Kidus-Tesfaye/edf-tvc-testbed/CAD/views/16_rangefinder_TFmini-S_from_below.png

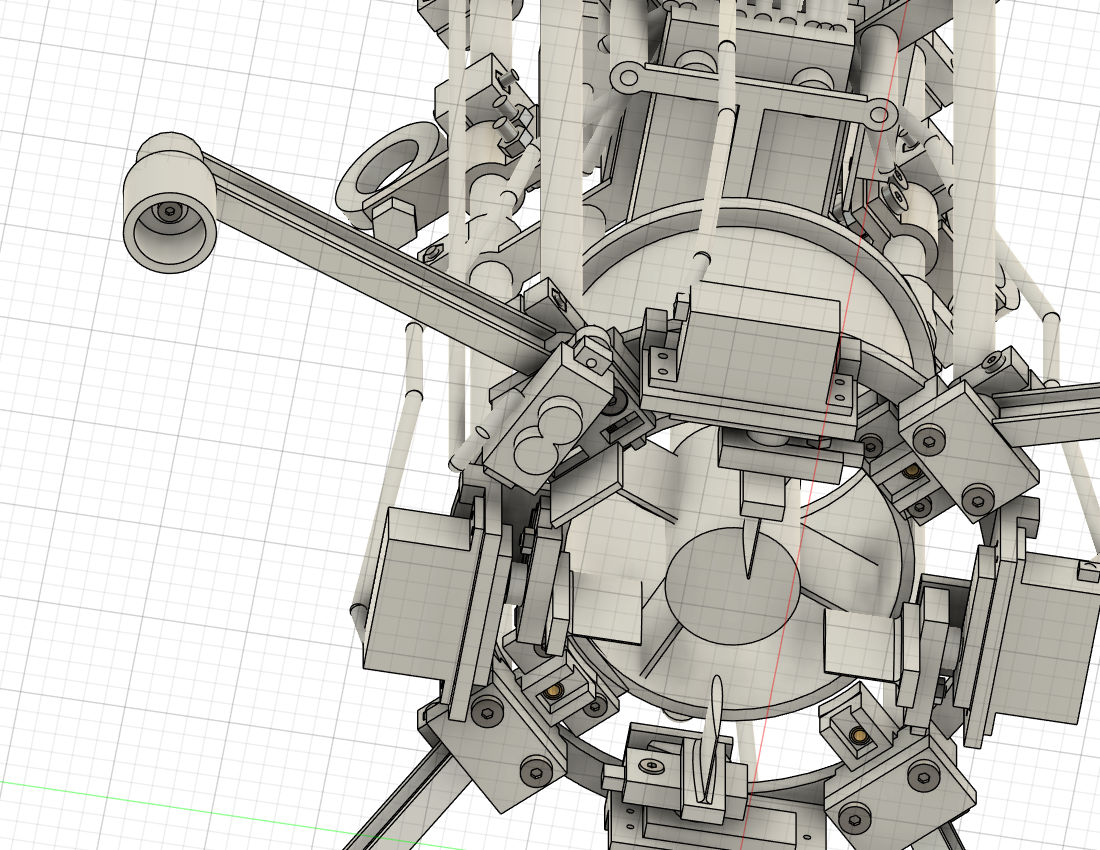
CAD/views/16_rangefinder_TFmini-S_from_below.png
