Kidus-Tesfaye/edf-tvc-testbed/docs/gap-statement-review-2026-09-17-edf-variant.md

# Gap statement review — electric (EDF) variant of the actively stabilised rocket project

*Date: 2026-09-17 · Audience assumed: student-conference reviewers · Reviewer: Claude (Opus 5, via Claude Code) ·
Search bound: delta audit on top of the solid-motor review of the same date — surveys, system papers, recent preprints and same-tier builds for electric-ducted-fan vehicles, one citation hop; "recent" cut-off 2025-03. Source keys S1–S35 refer to the earlier report's table and are repeated below only where cited; new sources start at S36.*

**Statement under review (verbatim, now applied to an electric-ducted-fan vehicle; starting point: the BB Projects "SpaceX-inspired EDF rocket" <a href="#s36" title="S36: B. Brocken, 2021-02-27, &quot;SpaceX inspired EDF rocket&quot;, BB Projects (bbprojects.technology) project page — starting point supplied by the user; counter-example SC1 and SC2 (flown, stock ArduPilot SingleCopter); read: full text; verified: yes — page (70 mm 6S EDF, about 2.5 kg thrust, Pixhawk/ArduPilot 4.0.4 SingleC…">[S36]</a>):**

> Active stabilisation of vertical thrust is a stretch problem for student teams; commercial model rockets use passive fins and aren't designed for control experimentation.

## Verdict

**Not defensible** — confidence high for the statement as written under electric propulsion; a narrower, EDF-specific statement (below) is defensible after narrowing, confidence medium.

Switching to an electric ducted fan (EDF) does not narrow the original gap — it removes it. Every clause now points at something that demonstrably exists. Attitude stabilisation of an EDF "rocket" was flown by the starting-point project itself in 2021 on a stock open-source autopilot configuration (ArduPilot SingleCopter: one fan, four vanes) <a href="#s36" title="S36: B. Brocken, 2021-02-27, &quot;SpaceX inspired EDF rocket&quot;, BB Projects (bbprojects.technology) project page — starting point supplied by the user; counter-example SC1 and SC2 (flown, stock ArduPilot SingleCopter); read: full text; verified: yes — page (70 mm 6S EDF, about 2.5 kg thrust, Pixhawk/ArduPilot 4.0.4 SingleC…">[S36]</a><a href="#s40" title="S40: ArduPilot Dev Team, n.d. (page current 2026-09-17), &quot;SingleCopter and CoaxCopter&quot;, ArduPilot Copter documentation — counter-example SC2 (stock support for a one-fan, four-vane vehicle); read: full text; verified: yes — page (`FRAME_CLASS` 8/9, vane servo mapping and parameters)">[S40]</a>; autonomous hover *and* soft landing were demonstrated by a single Master's student in March 2026 with custom 100 Hz avionics, and the code, CAD and thesis are public <a href="#s37" title="S37: U. Kukovič, 2026-03, &quot;TVC Self-Landing Rocket&quot; (Master&#x27;s thesis, University of Maribor, Electrical Engineering — Automation &amp; Robotics; mentor A. Sarjaš), GitHub repository with thesis PDF, code and CAD, CC BY-NC — strongest counter-example SC1; open flown vehicle for SC3; documented absence (horizontal control);…">[S37]</a>; research groups have adopted electric TVC vehicles as their preferred low-risk testbeds precisely because solid motors are hard to experiment on <a href="#s6" title="S6: R. Linsen, P. Listov, A. de Lajarte, R. Schwan, C. N. Jones, 2022, &quot;Optimal Thrust Vector Control of an Electric Small-Scale Rocket Prototype&quot;, IEEE ICRA 2022; EPFL — carried over; now the nearest academic neighbour (flown electric TVC platform); read: abstract; verified: yes — abstract via OpenAlex (earlier repor…">[S6]</a><a href="#s5" title="S5: P. Santos, J. Reis, P. Oliveira, C. Silvestre, 2026, &quot;QuadRocket: An Aerial Robotic Testbed for Adaptive Thrust-Vector Control of Rocket-Like Vehicles&quot;, arXiv — carried over; research testbed (electric); read: abstract; verified: yes — abstract (earlier report)">[S5]</a><a href="#s38" title="S38: A. Fonte, P. Santos, P. Oliveira, 2025-09-24, &quot;Control and Navigation of a 2-D Electric Rocket&quot;, arXiv preprint — recent; simulation-only; documented open limitation (lateral axis); read: abstract; verified: yes — abstract (&quot;limitations along the lateral axis&quot;)">[S38]</a>. And the "not designed for control experimentation" clause is inverted by the autopilot the starting point already runs: ArduPilot ships a custom-controller framework (`CC_TYPE`, `CC_AXIS_MASK`) with in-flight switching and bumpless transfer back to the stock controller — a hook built for exactly this kind of experiment <a href="#s41" title="S41: ArduPilot Dev Team, n.d. (page current 2026-09-17), &quot;Adding a Custom Controller&quot;, ArduPilot developer documentation — counter-example SC3 (experimentation hook in the COTS autopilot); read: full text; verified: yes — page (`CC_TYPE`, `CC_AXIS_MASK`, RC option 109, bumpless transfer, &quot;tested only lightly&quot;)">[S41]</a>. "Commercial model rockets use passive fins" is simply the wrong comparison class: an EDF vehicle is a powered model aircraft / small UAS, not a model rocket, in regulation and in practice <a href="#s46" title="S46: Federal Aviation Administration, n.d., &quot;Small Unmanned Aircraft Systems (UAS) Regulations (Part 107)&quot; — regulatory class of an EDF vehicle (US context only); read: snippet only; verified: no — classification taken from the search summary; the user&#x27;s jurisdiction is unknown">[S46]</a>. What survives is one specific, documented hole at the student tier — closed-loop *horizontal* position control with low-cost onboard sensing, which the one published thesis reports it could not achieve — and one not-found-by-search absence: an open EDF testbed publishing a validated plant model with a like-for-like comparison of controllers on the same airframe.

| Test | Result | Why (one line, with [S#]) |
|---|---|---|
| 1 Falsifiable | partial | Same as before: "stretch problem" cannot be refuted; the "not designed for control experimentation" clause can be, and <a href="#s41" title="S41: ArduPilot Dev Team, n.d. (page current 2026-09-17), &quot;Adding a Custom Controller&quot;, ArduPilot developer documentation — counter-example SC3 (experimentation hook in the COTS autopilot); read: full text; verified: yes — page (`CC_TYPE`, `CC_AXIS_MASK`, RC option 109, bumpless transfer, &quot;tested only lightly&quot;)">[S41]</a> does |
| 2 Evidenced absence | fail | Every absence claimed is met by a documented presence: flown hobbyist vehicle <a href="#s36" title="S36: B. Brocken, 2021-02-27, &quot;SpaceX inspired EDF rocket&quot;, BB Projects (bbprojects.technology) project page — starting point supplied by the user; counter-example SC1 and SC2 (flown, stock ArduPilot SingleCopter); read: full text; verified: yes — page (70 mm 6S EDF, about 2.5 kg thrust, Pixhawk/ArduPilot 4.0.4 SingleC…">[S36]</a>, flown open thesis vehicle <a href="#s37" title="S37: U. Kukovič, 2026-03, &quot;TVC Self-Landing Rocket&quot; (Master&#x27;s thesis, University of Maribor, Electrical Engineering — Automation &amp; Robotics; mentor A. Sarjaš), GitHub repository with thesis PDF, code and CAD, CC BY-NC — strongest counter-example SC1; open flown vehicle for SC3; documented absence (horizontal control);…">[S37]</a>, stock autopilot support <a href="#s40" title="S40: ArduPilot Dev Team, n.d. (page current 2026-09-17), &quot;SingleCopter and CoaxCopter&quot;, ArduPilot Copter documentation — counter-example SC2 (stock support for a one-fan, four-vane vehicle); read: full text; verified: yes — page (`FRAME_CLASS` 8/9, vane servo mapping and parameters)">[S40]</a>, custom-controller hook <a href="#s41" title="S41: ArduPilot Dev Team, n.d. (page current 2026-09-17), &quot;Adding a Custom Controller&quot;, ArduPilot developer documentation — counter-example SC3 (experimentation hook in the COTS autopilot); read: full text; verified: yes — page (`CC_TYPE`, `CC_AXIS_MASK`, RC option 109, bumpless transfer, &quot;tested only lightly&quot;)">[S41]</a> |
| 3 Honestly scoped | fail | "Model rockets" is the wrong class for an EDF vehicle; the relevant neighbours are single-fan VTOL aircraft and their autopilots, and the claim was never scoped to them |
| 4 Significant | partial | A flown testbed still has value for the expo, but the *research* value has to come from the experiments run on it, because the platform itself is no longer the contribution |
| 5 Not empty for a good reason | fail | It is not empty. The sub-problem that *is* empty at the student tier (horizontal control with cheap sensing) is empty for a good reason — EDF vibration corrupts optical-flow velocity <a href="#s37" title="S37: U. Kukovič, 2026-03, &quot;TVC Self-Landing Rocket&quot; (Master&#x27;s thesis, University of Maribor, Electrical Engineering — Automation &amp; Robotics; mentor A. Sarjaš), GitHub repository with thesis PDF, code and CAD, CC BY-NC — strongest counter-example SC1; open flown vehicle for SC3; documented absence (horizontal control);…">[S37]</a> and lateral dynamics are the stated open limitation in simulation too <a href="#s38" title="S38: A. Fonte, P. Santos, P. Oliveira, 2025-09-24, &quot;Control and Navigation of a 2-D Electric Rocket&quot;, arXiv preprint — recent; simulation-only; documented open limitation (lateral axis); read: abstract; verified: yes — abstract (&quot;limitations along the lateral axis&quot;)">[S38]</a> |
| 6 Current | fail | Three items since the cut-off close or reshape the claim: the Maribor thesis (2026-03) <a href="#s37" title="S37: U. Kukovič, 2026-03, &quot;TVC Self-Landing Rocket&quot; (Master&#x27;s thesis, University of Maribor, Electrical Engineering — Automation &amp; Robotics; mentor A. Sarjaš), GitHub repository with thesis PDF, code and CAD, CC BY-NC — strongest counter-example SC1; open flown vehicle for SC3; documented absence (horizontal control);…">[S37]</a>, QuadRocket (2026-07) <a href="#s5" title="S5: P. Santos, J. Reis, P. Oliveira, C. Silvestre, 2026, &quot;QuadRocket: An Aerial Robotic Testbed for Adaptive Thrust-Vector Control of Rocket-Like Vehicles&quot;, arXiv — carried over; research testbed (electric); read: abstract; verified: yes — abstract (earlier report)">[S5]</a>, and the 2-D electric rocket simulation (2025-09) <a href="#s38" title="S38: A. Fonte, P. Santos, P. Oliveira, 2025-09-24, &quot;Control and Navigation of a 2-D Electric Rocket&quot;, arXiv preprint — recent; simulation-only; documented open limitation (lateral axis); read: abstract; verified: yes — abstract (&quot;limitations along the lateral axis&quot;)">[S38]</a> |

## Glossary

| Term | Meaning here |
|---|---|
| Sub-claim | One atomic piece of the statement, "X has not been done under condition Y", that a single paper could refute |
| Documented absence | Evidence that something is missing: a paper's own limitation sentence, a survey table with the cell empty, a rule saying a component is unavailable |
| Not-found-by-search | Weaker: our logged queries surfaced nothing. Only as strong as the queries |
| EDF | Electric ducted fan: a brushless motor driving a multi-blade fan inside a duct. Throttleable, restartable, runs for minutes, no pyrotechnics — the opposite of a solid rocket motor on every axis that made TVC hard |
| Vane TVC vs gimbal TVC | Vanes deflect the fan's exhaust with movable surfaces in the jet (the BB Projects design <a href="#s36" title="S36: B. Brocken, 2021-02-27, &quot;SpaceX inspired EDF rocket&quot;, BB Projects (bbprojects.technology) project page — starting point supplied by the user; counter-example SC1 and SC2 (flown, stock ArduPilot SingleCopter); read: full text; verified: yes — page (70 mm 6S EDF, about 2.5 kg thrust, Pixhawk/ArduPilot 4.0.4 SingleC…">[S36]</a>, ArduPilot SingleCopter <a href="#s40" title="S40: ArduPilot Dev Team, n.d. (page current 2026-09-17), &quot;SingleCopter and CoaxCopter&quot;, ArduPilot Copter documentation — counter-example SC2 (stock support for a one-fan, four-vane vehicle); read: full text; verified: yes — page (`FRAME_CLASS` 8/9, vane servo mapping and parameters)">[S40]</a>); a gimbal tilts the whole fan (the Maribor design <a href="#s37" title="S37: U. Kukovič, 2026-03, &quot;TVC Self-Landing Rocket&quot; (Master&#x27;s thesis, University of Maribor, Electrical Engineering — Automation &amp; Robotics; mentor A. Sarjaš), GitHub repository with thesis PDF, code and CAD, CC BY-NC — strongest counter-example SC1; open flown vehicle for SC3; documented absence (horizontal control);…">[S37]</a>) |
| SingleCopter | ArduPilot's name for a one-motor, four-vane vehicle (`FRAME_CLASS` 8) <a href="#s40" title="S40: ArduPilot Dev Team, n.d. (page current 2026-09-17), &quot;SingleCopter and CoaxCopter&quot;, ArduPilot Copter documentation — counter-example SC2 (stock support for a one-fan, four-vane vehicle); read: full text; verified: yes — page (`FRAME_CLASS` 8/9, vane servo mapping and parameters)">[S40]</a> |
| Custom controller (ArduPilot) | A firmware hook that lets a user's own attitude controller run in place of the stock one, switched by an RC channel, with automatic fallback <a href="#s41" title="S41: ArduPilot Dev Team, n.d. (page current 2026-09-17), &quot;Adding a Custom Controller&quot;, ArduPilot developer documentation — counter-example SC3 (experimentation hook in the COTS autopilot); read: full text; verified: yes — page (`CC_TYPE`, `CC_AXIS_MASK`, RC option 109, bumpless transfer, &quot;tested only lightly&quot;)">[S41]</a> |
| Reaction torque | The roll torque an EDF applies to the airframe as it spins the fan; must be cancelled by vanes or feed-forward <a href="#s37" title="S37: U. Kukovič, 2026-03, &quot;TVC Self-Landing Rocket&quot; (Master&#x27;s thesis, University of Maribor, Electrical Engineering — Automation &amp; Robotics; mentor A. Sarjaš), GitHub repository with thesis PDF, code and CAD, CC BY-NC — strongest counter-example SC1; open flown vehicle for SC3; documented absence (horizontal control);…">[S37]</a> |
| Small UAS | The regulatory class an EDF vehicle falls into (unmanned aircraft), as opposed to the model-rocket class <a href="#s46" title="S46: Federal Aviation Administration, n.d., &quot;Small Unmanned Aircraft Systems (UAS) Regulations (Part 107)&quot; — regulatory class of an EDF vehicle (US context only); read: snippet only; verified: no — classification taken from the search summary; the user&#x27;s jurisdiction is unknown">[S46]</a> |

## Inputs and assumptions

| Slot | Value | Supplied or assumed |
|---|---|---|
| Field / sub-field | Small VTOL / single-ducted-fan aircraft; thrust-vectored electric "rockets"; hobby and academic testbeds | assumed from the starting point |
| Vocabulary used for searching | "EDF rocket", "electric ducted fan", "electric rocket", "thrust vector control", "vane", "gimbal", "self-landing", "VTVL", "hover", "SingleCopter", "custom controller", plus the solid-motor terms from the earlier review | assumed |
| Audience | Student-conference reviewers | supplied |
| Scope boundaries | Same group project, budget not a constraint, about 3 months to an expo; the vehicle class is now a 2–4 kg electric single-fan VTOL derived from <a href="#s36" title="S36: B. Brocken, 2021-02-27, &quot;SpaceX inspired EDF rocket&quot;, BB Projects (bbprojects.technology) project page — starting point supplied by the user; counter-example SC1 and SC2 (flown, stock ArduPilot SingleCopter); read: full text; verified: yes — page (70 mm 6S EDF, about 2.5 kg thrust, Pixhawk/ArduPilot 4.0.4 SingleC…">[S36]</a> | supplied (time, budget, starting point) / assumed (mass class from <a href="#s36" title="S36: B. Brocken, 2021-02-27, &quot;SpaceX inspired EDF rocket&quot;, BB Projects (bbprojects.technology) project page — starting point supplied by the user; counter-example SC1 and SC2 (flown, stock ArduPilot SingleCopter); read: full text; verified: yes — page (70 mm 6S EDF, about 2.5 kg thrust, Pixhawk/ArduPilot 4.0.4 SingleC…">[S36]</a> and <a href="#s37" title="S37: U. Kukovič, 2026-03, &quot;TVC Self-Landing Rocket&quot; (Master&#x27;s thesis, University of Maribor, Electrical Engineering — Automation &amp; Robotics; mentor A. Sarjaš), GitHub repository with thesis PDF, code and CAD, CC BY-NC — strongest counter-example SC1; open flown vehicle for SC3; documented absence (horizontal control);…">[S37]</a>) |
| Seed papers / library | <a href="#s36" title="S36: B. Brocken, 2021-02-27, &quot;SpaceX inspired EDF rocket&quot;, BB Projects (bbprojects.technology) project page — starting point supplied by the user; counter-example SC1 and SC2 (flown, stock ArduPilot SingleCopter); read: full text; verified: yes — page (70 mm 6S EDF, about 2.5 kg thrust, Pixhawk/ArduPilot 4.0.4 SingleC…">[S36]</a> (supplied as the starting point); <a href="#s6" title="S6: R. Linsen, P. Listov, A. de Lajarte, R. Schwan, C. N. Jones, 2022, &quot;Optimal Thrust Vector Control of an Electric Small-Scale Rocket Prototype&quot;, IEEE ICRA 2022; EPFL — carried over; now the nearest academic neighbour (flown electric TVC platform); read: abstract; verified: yes — abstract via OpenAlex (earlier repor…">[S6]</a><a href="#s5" title="S5: P. Santos, J. Reis, P. Oliveira, C. Silvestre, 2026, &quot;QuadRocket: An Aerial Robotic Testbed for Adaptive Thrust-Vector Control of Rocket-Like Vehicles&quot;, arXiv — carried over; research testbed (electric); read: abstract; verified: yes — abstract (earlier report)">[S5]</a><a href="#s37" title="S37: U. Kukovič, 2026-03, &quot;TVC Self-Landing Rocket&quot; (Master&#x27;s thesis, University of Maribor, Electrical Engineering — Automation &amp; Robotics; mentor A. Sarjaš), GitHub repository with thesis PDF, code and CAD, CC BY-NC — strongest counter-example SC1; open flown vehicle for SC3; documented absence (horizontal control);…">[S37]</a> taken as the nearest academic and thesis neighbours | supplied / assumed |
| Already searched by the user | Nothing beyond being shown <a href="#s36" title="S36: B. Brocken, 2021-02-27, &quot;SpaceX inspired EDF rocket&quot;, BB Projects (bbprojects.technology) project page — starting point supplied by the user; counter-example SC1 and SC2 (flown, stock ArduPilot SingleCopter); read: full text; verified: yes — page (70 mm 6S EDF, about 2.5 kg thrust, Pixhawk/ArduPilot 4.0.4 SingleC…">[S36]</a> | supplied |
| "Recent" cut-off | 2025-03 | assumed |

## Sub-claims

| ID | Sub-claim | Gap type | Top-down evidence | Bottom-up evidence | Status | Strongest counter-paper | Evidence strength |
|---|---|---|---|---|---|---|---|
| SC1 | Active attitude stabilisation of an EDF-propelled "rocket" (vane or gimbal TVC), including hover and landing, is beyond the reach of student teams | practical-knowledge / population | EPFL flew an electric small-scale TVC rocket indoors and outdoors with MPC on embedded hardware, as "an inexpensive platform to explore guidance algorithms" <a href="#s6" title="S6: R. Linsen, P. Listov, A. de Lajarte, R. Schwan, C. N. Jones, 2022, &quot;Optimal Thrust Vector Control of an Electric Small-Scale Rocket Prototype&quot;, IEEE ICRA 2022; EPFL — carried over; now the nearest academic neighbour (flown electric TVC platform); read: abstract; verified: yes — abstract via OpenAlex (earlier repor…">[S6]</a>; the Lisbon group's QuadRocket flies in a motion-capture arena <a href="#s5" title="S5: P. Santos, J. Reis, P. Oliveira, C. Silvestre, 2026, &quot;QuadRocket: An Aerial Robotic Testbed for Adaptive Thrust-Vector Control of Rocket-Like Vehicles&quot;, arXiv — carried over; research testbed (electric); read: abstract; verified: yes — abstract (earlier report)">[S5]</a> and its 2-D electric-rocket simulation is the same group's student-facing model <a href="#s38" title="S38: A. Fonte, P. Santos, P. Oliveira, 2025-09-24, &quot;Control and Navigation of a 2-D Electric Rocket&quot;, arXiv preprint — recent; simulation-only; documented open limitation (lateral axis); read: abstract; verified: yes — abstract (&quot;limitations along the lateral axis&quot;)">[S38]</a> | A hobbyist flew the starting-point vehicle on stock ArduPilot in 2021 <a href="#s36" title="S36: B. Brocken, 2021-02-27, &quot;SpaceX inspired EDF rocket&quot;, BB Projects (bbprojects.technology) project page — starting point supplied by the user; counter-example SC1 and SC2 (flown, stock ArduPilot SingleCopter); read: full text; verified: yes — page (70 mm 6S EDF, about 2.5 kg thrust, Pixhawk/ArduPilot 4.0.4 SingleC…">[S36]</a>; a Master's student demonstrated autonomous hover and soft landing (50–100 mm/s touchdown) in March 2026 and released code, CAD and thesis <a href="#s37" title="S37: U. Kukovič, 2026-03, &quot;TVC Self-Landing Rocket&quot; (Master&#x27;s thesis, University of Maribor, Electrical Engineering — Automation &amp; Robotics; mentor A. Sarjaš), GitHub repository with thesis PDF, code and CAD, CC BY-NC — strongest counter-example SC1; open flown vehicle for SC3; documented absence (horizontal control);…">[S37]</a>; further hobbyist EDF landers exist <a href="#s42" title="S42: Hackster.io News, n.d., &quot;Ikarus Electric &#x27;Rocket&#x27;&quot; (3D-printed four-vane EDF vehicle that lands on a pad) — same-tier hobbyist lander; read: not accessible; verified: n/a">[S42]</a><a href="#s44" title="S44: Bresc, n.d., &quot;Ducted fan thrust vectoring drone&quot;, Printables.com model — same-tier printable design; read: snippet only; verified: no — not opened">[S44]</a><a href="#s45" title="S45: RCU Forums thread, n.d., &quot;EDF Thrust Vectoring Autonomous LEM (Lunar Excursion Module) Build&quot; — same-tier hobbyist build; read: snippet only; verified: no — not opened">[S45]</a> and a 2024 Indonesian thesis covers 70 mm EDF TVC <a href="#s43" title="S43: N. M. Farras, 2024, Master&#x27;s/undergraduate thesis chapter &quot;Thrust Vectoring Control&quot; (70 mm EDF), Institut Teknologi Bandung digital library — same-tier student thesis on EDF TVC; read: snippet only; verified: no — not opened; title and EDF size from search snippet">[S43]</a> | closed | <a href="#s37" title="S37: U. Kukovič, 2026-03, &quot;TVC Self-Landing Rocket&quot; (Master&#x27;s thesis, University of Maribor, Electrical Engineering — Automation &amp; Robotics; mentor A. Sarjaš), GitHub repository with thesis PDF, code and CAD, CC BY-NC — strongest counter-example SC1; open flown vehicle for SC3; documented absence (horizontal control);…">[S37]</a> (student, EDF, gimbal TVC, hover and landing, open) | closed by <a href="#s37" title="S37: U. Kukovič, 2026-03, &quot;TVC Self-Landing Rocket&quot; (Master&#x27;s thesis, University of Maribor, Electrical Engineering — Automation &amp; Robotics; mentor A. Sarjaš), GitHub repository with thesis PDF, code and CAD, CC BY-NC — strongest counter-example SC1; open flown vehicle for SC3; documented absence (horizontal control);…">[S37]</a> and <a href="#s36" title="S36: B. Brocken, 2021-02-27, &quot;SpaceX inspired EDF rocket&quot;, BB Projects (bbprojects.technology) project page — starting point supplied by the user; counter-example SC1 and SC2 (flown, stock ArduPilot SingleCopter); read: full text; verified: yes — page (70 mm 6S EDF, about 2.5 kg thrust, Pixhawk/ArduPilot 4.0.4 SingleC…">[S36]</a> |
| SC2 | The commercial / off-the-shelf baseline for this vehicle class is passively stabilised and unsuited to active control (the EDF analogue of "commercial model rockets use passive fins") | evidence (market) | The dominant open-source autopilot supports a one-fan, four-vane vehicle as a standard frame type, with per-vane servo configuration documented <a href="#s40" title="S40: ArduPilot Dev Team, n.d. (page current 2026-09-17), &quot;SingleCopter and CoaxCopter&quot;, ArduPilot Copter documentation — counter-example SC2 (stock support for a one-fan, four-vane vehicle); read: full text; verified: yes — page (`FRAME_CLASS` 8/9, vane servo mapping and parameters)">[S40]</a> | The starting point runs exactly that configuration on a Pixhawk and flew on it <a href="#s36" title="S36: B. Brocken, 2021-02-27, &quot;SpaceX inspired EDF rocket&quot;, BB Projects (bbprojects.technology) project page — starting point supplied by the user; counter-example SC1 and SC2 (flown, stock ArduPilot SingleCopter); read: full text; verified: yes — page (70 mm 6S EDF, about 2.5 kg thrust, Pixhawk/ArduPilot 4.0.4 SingleC…">[S36]</a>; no commercial EDF-rocket *kit* was found (search log #8), but the vehicle is a UAS and the UAS COTS ecosystem is the baseline <a href="#s46" title="S46: Federal Aviation Administration, n.d., &quot;Small Unmanned Aircraft Systems (UAS) Regulations (Part 107)&quot; — regulatory class of an EDF vehicle (US context only); read: snippet only; verified: no — classification taken from the search summary; the user&#x27;s jurisdiction is unknown">[S46]</a> | closed | <a href="#s40" title="S40: ArduPilot Dev Team, n.d. (page current 2026-09-17), &quot;SingleCopter and CoaxCopter&quot;, ArduPilot Copter documentation — counter-example SC2 (stock support for a one-fan, four-vane vehicle); read: full text; verified: yes — page (`FRAME_CLASS` 8/9, vane servo mapping and parameters)">[S40]</a> with <a href="#s36" title="S36: B. Brocken, 2021-02-27, &quot;SpaceX inspired EDF rocket&quot;, BB Projects (bbprojects.technology) project page — starting point supplied by the user; counter-example SC1 and SC2 (flown, stock ArduPilot SingleCopter); read: full text; verified: yes — page (70 mm 6S EDF, about 2.5 kg thrust, Pixhawk/ArduPilot 4.0.4 SingleC…">[S36]</a> as the flown instance | closed by <a href="#s40" title="S40: ArduPilot Dev Team, n.d. (page current 2026-09-17), &quot;SingleCopter and CoaxCopter&quot;, ArduPilot Copter documentation — counter-example SC2 (stock support for a one-fan, four-vane vehicle); read: full text; verified: yes — page (`FRAME_CLASS` 8/9, vane servo mapping and parameters)">[S40]</a> and <a href="#s36" title="S36: B. Brocken, 2021-02-27, &quot;SpaceX inspired EDF rocket&quot;, BB Projects (bbprojects.technology) project page — starting point supplied by the user; counter-example SC1 and SC2 (flown, stock ArduPilot SingleCopter); read: full text; verified: yes — page (70 mm 6S EDF, about 2.5 kg thrust, Pixhawk/ArduPilot 4.0.4 SingleC…">[S36]</a> |
| SC3 | No platform exists on which a student team can run controlled attitude-control experiments (controller exposed, instrumented, reusable) | methodological / platform | ArduPilot's custom-controller framework runs a user's controller in place of the stock one, switchable in flight, with bumpless fallback <a href="#s41" title="S41: ArduPilot Dev Team, n.d. (page current 2026-09-17), &quot;Adding a Custom Controller&quot;, ArduPilot developer documentation — counter-example SC3 (experimentation hook in the COTS autopilot); read: full text; verified: yes — page (`CC_TYPE`, `CC_AXIS_MASK`, RC option 109, bumpless transfer, &quot;tested only lightly&quot;)">[S41]</a>; EPFL <a href="#s6" title="S6: R. Linsen, P. Listov, A. de Lajarte, R. Schwan, C. N. Jones, 2022, &quot;Optimal Thrust Vector Control of an Electric Small-Scale Rocket Prototype&quot;, IEEE ICRA 2022; EPFL — carried over; now the nearest academic neighbour (flown electric TVC platform); read: abstract; verified: yes — abstract via OpenAlex (earlier repor…">[S6]</a> and QuadRocket <a href="#s5" title="S5: P. Santos, J. Reis, P. Oliveira, C. Silvestre, 2026, &quot;QuadRocket: An Aerial Robotic Testbed for Adaptive Thrust-Vector Control of Rocket-Like Vehicles&quot;, arXiv — carried over; research testbed (electric); read: abstract; verified: yes — abstract (earlier report)">[S5]</a> are research testbeds built for this purpose | The Maribor vehicle is open (CC BY-NC) with a bare-metal 100 Hz loop the student wrote and tuned <a href="#s37" title="S37: U. Kukovič, 2026-03, &quot;TVC Self-Landing Rocket&quot; (Master&#x27;s thesis, University of Maribor, Electrical Engineering — Automation &amp; Robotics; mentor A. Sarjaš), GitHub repository with thesis PDF, code and CAD, CC BY-NC — strongest counter-example SC1; open flown vehicle for SC3; documented absence (horizontal control);…">[S37]</a>; the starting point's Pixhawk config, Arduino code and Gerbers are free and the CAD is for sale <a href="#s36" title="S36: B. Brocken, 2021-02-27, &quot;SpaceX inspired EDF rocket&quot;, BB Projects (bbprojects.technology) project page — starting point supplied by the user; counter-example SC1 and SC2 (flown, stock ArduPilot SingleCopter); read: full text; verified: yes — page (70 mm 6S EDF, about 2.5 kg thrust, Pixhawk/ArduPilot 4.0.4 SingleC…">[S36]</a> | partially closed | <a href="#s41" title="S41: ArduPilot Dev Team, n.d. (page current 2026-09-17), &quot;Adding a Custom Controller&quot;, ArduPilot developer documentation — counter-example SC3 (experimentation hook in the COTS autopilot); read: full text; verified: yes — page (`CC_TYPE`, `CC_AXIS_MASK`, RC option 109, bumpless transfer, &quot;tested only lightly&quot;)">[S41]</a> for attitude experiments; <a href="#s37" title="S37: U. Kukovič, 2026-03, &quot;TVC Self-Landing Rocket&quot; (Master&#x27;s thesis, University of Maribor, Electrical Engineering — Automation &amp; Robotics; mentor A. Sarjaš), GitHub repository with thesis PDF, code and CAD, CC BY-NC — strongest counter-example SC1; open flown vehicle for SC3; documented absence (horizontal control);…">[S37]</a> for an open flown vehicle | closed by <a href="#s41" title="S41: ArduPilot Dev Team, n.d. (page current 2026-09-17), &quot;Adding a Custom Controller&quot;, ArduPilot developer documentation — counter-example SC3 (experimentation hook in the COTS autopilot); read: full text; verified: yes — page (`CC_TYPE`, `CC_AXIS_MASK`, RC option 109, bumpless transfer, &quot;tested only lightly&quot;)">[S41]</a> and <a href="#s37" title="S37: U. Kukovič, 2026-03, &quot;TVC Self-Landing Rocket&quot; (Master&#x27;s thesis, University of Maribor, Electrical Engineering — Automation &amp; Robotics; mentor A. Sarjaš), GitHub repository with thesis PDF, code and CAD, CC BY-NC — strongest counter-example SC1; open flown vehicle for SC3; documented absence (horizontal control);…">[S37]</a> for attitude control; not-found-by-search for an open EDF testbed with a published plant model and like-for-like controller comparison; documented absence for student-tier closed-loop horizontal control ("could tip over", optical flow "unreliable") <a href="#s37" title="S37: U. Kukovič, 2026-03, &quot;TVC Self-Landing Rocket&quot; (Master&#x27;s thesis, University of Maribor, Electrical Engineering — Automation &amp; Robotics; mentor A. Sarjaš), GitHub repository with thesis PDF, code and CAD, CC BY-NC — strongest counter-example SC1; open flown vehicle for SC3; documented absence (horizontal control);…">[S37]</a> and lateral-axis limitations <a href="#s38" title="S38: A. Fonte, P. Santos, P. Oliveira, 2025-09-24, &quot;Control and Navigation of a 2-D Electric Rocket&quot;, arXiv preprint — recent; simulation-only; documented open limitation (lateral axis); read: abstract; verified: yes — abstract (&quot;limitations along the lateral axis&quot;)">[S38]</a> |

## Top-down search

### SC1 — active stabilisation of an EDF vehicle by students

**Surveys.** The only review surfaced with "thrust vectoring" and "electric" in the title covers spacecraft electric propulsion (ion and plasma thrusters) and says nothing about ducted-fan vehicles <a href="#s39" title="S39: A. Shumeiko, V. Telekh, S. Ryzhkov, 2025, &quot;Thrust-vectoring schemes for electric propulsion systems: A review&quot;, Chinese Journal of Aeronautics 38(6) — read, not cited — the only &quot;review&quot; surfaced, but it covers spacecraft ion/plasma thrusters, not ducted fans; read: abstract; verified: n/a">[S39]</a>. No survey of small electric TVC vehicles or educational testbeds was found (search log #4, #11).

**System papers.** The academic picture is the same three groups as the solid-motor review, and all three have gone electric: EPFL's ICRA 2022 electric TVC prototype, flown indoors and outdoors with embedded MPC <a href="#s6" title="S6: R. Linsen, P. Listov, A. de Lajarte, R. Schwan, C. N. Jones, 2022, &quot;Optimal Thrust Vector Control of an Electric Small-Scale Rocket Prototype&quot;, IEEE ICRA 2022; EPFL — carried over; now the nearest academic neighbour (flown electric TVC platform); read: abstract; verified: yes — abstract via OpenAlex (earlier repor…">[S6]</a>; the Lisbon group's QuadRocket, a rocket body on a quadrotor used as "a low-cost, low-risk platform for validating advanced thrust-vector control strategies" <a href="#s5" title="S5: P. Santos, J. Reis, P. Oliveira, C. Silvestre, 2026, &quot;QuadRocket: An Aerial Robotic Testbed for Adaptive Thrust-Vector Control of Rocket-Like Vehicles&quot;, arXiv — carried over; research testbed (electric); read: abstract; verified: yes — abstract (earlier report)">[S5]</a>, and the same group's 2025 simulation of a 2-D electric rocket with LQR and Kalman filtering, which "reveal[s] limitations along the lateral axis, whose resolution is suggested for future work" <a href="#s38" title="S38: A. Fonte, P. Santos, P. Oliveira, 2025-09-24, &quot;Control and Navigation of a 2-D Electric Rocket&quot;, arXiv preprint — recent; simulation-only; documented open limitation (lateral axis); read: abstract; verified: yes — abstract (&quot;limitations along the lateral axis&quot;)">[S38]</a>. The reason these groups use electric vehicles is the reason the statement's premise fails under EDF: an electric vehicle can be flown repeatedly, indoors, throttled, and tethered — the four things a solid motor forbids.

**Recent preprints.** The arXiv API query for ducted-fan or electric-rocket vehicles with thrust vectoring or landing returned four papers, all legged or humanoid robots and none relevant (search log #11); <a href="#s38" title="S38: A. Fonte, P. Santos, P. Oliveira, 2025-09-24, &quot;Control and Navigation of a 2-D Electric Rocket&quot;, arXiv preprint — recent; simulation-only; documented open limitation (lateral axis); read: abstract; verified: yes — abstract (&quot;limitations along the lateral axis&quot;)">[S38]</a> was found by web search instead. Nothing since the cut-off reports a *student team* electric TVC vehicle in a preprint — the student-tier evidence is in theses and repositories, below.

### SC2 — the off-the-shelf baseline

The comparison class changes completely. An EDF "rocket" is a single-fan VTOL aircraft; ArduPilot Copter supports it as `FRAME_CLASS` 8 (SingleCopter: "a single motor and 4 independent flaps") with yaw from differential vane deflection and per-vane `SERVOx_TRIM/REVERSED/MIN/MAX` configuration <a href="#s40" title="S40: ArduPilot Dev Team, n.d. (page current 2026-09-17), &quot;SingleCopter and CoaxCopter&quot;, ArduPilot Copter documentation — counter-example SC2 (stock support for a one-fan, four-vane vehicle); read: full text; verified: yes — page (`FRAME_CLASS` 8/9, vane servo mapping and parameters)">[S40]</a>. The premise "commercial [platforms] use passive fins" has no analogue here — the off-the-shelf baseline is an *actively stabilised* vehicle out of the box. Regulatory framing follows the same logic: EDF-powered models fall under model-aircraft / small-UAS rules, not model-rocket codes <a href="#s46" title="S46: Federal Aviation Administration, n.d., &quot;Small Unmanned Aircraft Systems (UAS) Regulations (Part 107)&quot; — regulatory class of an EDF vehicle (US context only); read: snippet only; verified: no — classification taken from the search summary; the user&#x27;s jurisdiction is unknown">[S46]</a>, so the NAR/Tripoli/IREC constraints of the solid-motor review <a href="#s17" title="S17: Experimental Sounding Rocket Association, 2025, &quot;IREC Design, Test, &amp; Evaluation Guide&quot;, Rev. 2025 V1.1.6 — carried over; cited only to say it no longer applies; read: full text; verified: yes — §7 (earlier report)">[S17]</a> do not apply, and UAS registration thresholds and flying-site rules do.

### SC3 — a platform for control experimentation

ArduPilot's developer documentation describes a custom-controller library that "allows you to implement and easily run your controller inside ArduPilot in a systematic way": the user's controller receives the attitude targets, outputs roll/pitch/yaw commands, runs "after the main rate controller ... and before the motor output library", is enabled per axis via `CC_AXIS_MASK`, can be switched in and out in flight via RC option 109, and returns to the stock controller with "bumpless transfer" <a href="#s41" title="S41: ArduPilot Dev Team, n.d. (page current 2026-09-17), &quot;Adding a Custom Controller&quot;, ArduPilot developer documentation — counter-example SC3 (experimentation hook in the COTS autopilot); read: full text; verified: yes — page (`CC_TYPE`, `CC_AXIS_MASK`, RC option 109, bumpless transfer, &quot;tested only lightly&quot;)">[S41]</a>. The same page warns the example controller "has been tested only lightly" and advises switching to custom control "while the vehicle is hovering steadily" — which is a description of a safe experimental protocol, not a limitation on the claim. For a student team, this is the platform the statement says does not exist, and the starting point already runs the firmware it lives in <a href="#s36" title="S36: B. Brocken, 2021-02-27, &quot;SpaceX inspired EDF rocket&quot;, BB Projects (bbprojects.technology) project page — starting point supplied by the user; counter-example SC1 and SC2 (flown, stock ArduPilot SingleCopter); read: full text; verified: yes — page (70 mm 6S EDF, about 2.5 kg thrust, Pixhawk/ArduPilot 4.0.4 SingleC…">[S36]</a>.

## Bottom-up search

**Seeds:** <a href="#s36" title="S36: B. Brocken, 2021-02-27, &quot;SpaceX inspired EDF rocket&quot;, BB Projects (bbprojects.technology) project page — starting point supplied by the user; counter-example SC1 and SC2 (flown, stock ArduPilot SingleCopter); read: full text; verified: yes — page (70 mm 6S EDF, about 2.5 kg thrust, Pixhawk/ArduPilot 4.0.4 SingleC…">[S36]</a>, <a href="#s37" title="S37: U. Kukovič, 2026-03, &quot;TVC Self-Landing Rocket&quot; (Master&#x27;s thesis, University of Maribor, Electrical Engineering — Automation &amp; Robotics; mentor A. Sarjaš), GitHub repository with thesis PDF, code and CAD, CC BY-NC — strongest counter-example SC1; open flown vehicle for SC3; documented absence (horizontal control);…">[S37]</a>, <a href="#s6" title="S6: R. Linsen, P. Listov, A. de Lajarte, R. Schwan, C. N. Jones, 2022, &quot;Optimal Thrust Vector Control of an Electric Small-Scale Rocket Prototype&quot;, IEEE ICRA 2022; EPFL — carried over; now the nearest academic neighbour (flown electric TVC platform); read: abstract; verified: yes — abstract via OpenAlex (earlier repor…">[S6]</a>, <a href="#s5" title="S5: P. Santos, J. Reis, P. Oliveira, C. Silvestre, 2026, &quot;QuadRocket: An Aerial Robotic Testbed for Adaptive Thrust-Vector Control of Rocket-Like Vehicles&quot;, arXiv — carried over; research testbed (electric); read: abstract; verified: yes — abstract (earlier report)">[S5]</a>

**Chaining.** Forward from the Lisbon simulation papers <a href="#s3" title="S3: P. dos Santos, P. Oliveira, 2024, &quot;Thrust vector control and state estimation architecture for low-cost small-scale launchers&quot;, Acta Astronautica 222 — carried over; chaining seed for the Lisbon group; read: abstract; verified: yes — abstract (earlier report)">[S3]</a><a href="#s4" title="S4: P. dos Santos, P. Oliveira, 2023, &quot;ADCS Design for a Sounding Rocket with Thrust Vectoring&quot;, Aerotecnica Missili &amp; Spazio 102(3) — carried over; chaining seed; read: abstract; verified: spot-checked — OpenAlex abstract (earlier report)">[S4]</a> reaches <a href="#s5" title="S5: P. Santos, J. Reis, P. Oliveira, C. Silvestre, 2026, &quot;QuadRocket: An Aerial Robotic Testbed for Adaptive Thrust-Vector Control of Rocket-Like Vehicles&quot;, arXiv — carried over; research testbed (electric); read: abstract; verified: yes — abstract (earlier report)">[S5]</a> and <a href="#s38" title="S38: A. Fonte, P. Santos, P. Oliveira, 2025-09-24, &quot;Control and Navigation of a 2-D Electric Rocket&quot;, arXiv preprint — recent; simulation-only; documented open limitation (lateral axis); read: abstract; verified: yes — abstract (&quot;limitations along the lateral axis&quot;)">[S38]</a> (same authors, electric vehicles). Backward from <a href="#s37" title="S37: U. Kukovič, 2026-03, &quot;TVC Self-Landing Rocket&quot; (Master&#x27;s thesis, University of Maribor, Electrical Engineering — Automation &amp; Robotics; mentor A. Sarjaš), GitHub repository with thesis PDF, code and CAD, CC BY-NC — strongest counter-example SC1; open flown vehicle for SC3; documented absence (horizontal control);…">[S37]</a>: the thesis cites EPFL-style work and hobbyist designs (reference list not extracted). No second hop.

**Same-tier builds.**

- **BB Projects (Brian Brocken), 2021** <a href="#s36" title="S36: B. Brocken, 2021-02-27, &quot;SpaceX inspired EDF rocket&quot;, BB Projects (bbprojects.technology) project page — starting point supplied by the user; counter-example SC1 and SC2 (flown, stock ArduPilot SingleCopter); read: full text; verified: yes — page (70 mm 6S EDF, about 2.5 kg thrust, Pixhawk/ArduPilot 4.0.4 SingleC…">[S36]</a>: 70 mm 12-blade 6S EDF, about 2.5 kg thrust, 80 A ESC, 6S 1000 mAh LiPo; four exhaust vanes as the TVC unit; Pixhawk running ArduPilot 4.0.4 as SingleCopter; deployable landing legs on eight 9 g servos with an Arduino Nano controller. Maiden flight documented. The legs failed under hard landings ("landing gear seems to be not as durable as i would like it to be") and were replaced with fixed gear. STL and Fusion 360 files are sold; Pixhawk configuration, Arduino code and PCB Gerbers are free.
- **Uroš Kukovič, MSc thesis, University of Maribor, 2026-03** <a href="#s37" title="S37: U. Kukovič, 2026-03, &quot;TVC Self-Landing Rocket&quot; (Master&#x27;s thesis, University of Maribor, Electrical Engineering — Automation &amp; Robotics; mentor A. Sarjaš), GitHub repository with thesis PDF, code and CAD, CC BY-NC — strongest counter-example SC1; open flown vehicle for SC3; documented absence (horizontal control);…">[S37]</a>: 90 mm EDF, about 3.8 kg thrust, 6S, 120 A ESC; four high-torque servos gimballing the fan ±10°; STM32F411 flight controller with a bare-metal 100 Hz cascaded-PID loop (attitude inner, height/velocity outer), ESP32-S3 sensor hub with Wi-Fi telemetry; BNO085 IMU, time-of-flight lidar, PMW3901 optical flow; all-up mass about 2.65 kg. Autonomous hover and soft landing demonstrated (touchdown 50–100 mm/s; attitude settling about 0.8 s; roll feed-forward for fan reaction torque). Everything released under CC BY-NC. Zero stars and forks — nobody has built on it yet.
- Hobbyist EDF landers documented only in pages that could not be opened: Ikarus, a 3D-printed four-vane EDF vehicle that lands on a pad <a href="#s42" title="S42: Hackster.io News, n.d., &quot;Ikarus Electric &#x27;Rocket&#x27;&quot; (3D-printed four-vane EDF vehicle that lands on a pad) — same-tier hobbyist lander; read: not accessible; verified: n/a">[S42]</a>; a printable ducted-fan thrust-vectoring drone <a href="#s44" title="S44: Bresc, n.d., &quot;Ducted fan thrust vectoring drone&quot;, Printables.com model — same-tier printable design; read: snippet only; verified: no — not opened">[S44]</a>; an EDF thrust-vectoring lunar-module build on an RC forum <a href="#s45" title="S45: RCU Forums thread, n.d., &quot;EDF Thrust Vectoring Autonomous LEM (Lunar Excursion Module) Build&quot; — same-tier hobbyist build; read: snippet only; verified: no — not opened">[S45]</a>. A 2024 Institut Teknologi Bandung thesis chapter treats TVC on a 70 mm EDF <a href="#s43" title="S43: N. M. Farras, 2024, Master&#x27;s/undergraduate thesis chapter &quot;Thrust Vectoring Control&quot; (70 mm EDF), Institut Teknologi Bandung digital library — same-tier student thesis on EDF TVC; read: snippet only; verified: no — not opened; title and EDF size from search snippet">[S43]</a>.

**Nearest neighbours' own statements of what is still open:**

> "manually guide the rocket to land on the landing area, since it could tip over" — <a href="#s37" title="S37: U. Kukovič, 2026-03, &quot;TVC Self-Landing Rocket&quot; (Master&#x27;s thesis, University of Maribor, Electrical Engineering — Automation &amp; Robotics; mentor A. Sarjaš), GitHub repository with thesis PDF, code and CAD, CC BY-NC — strongest counter-example SC1; open flown vehicle for SC3; documented absence (horizontal control);…">[S37]</a>, README (horizontal stabilisation not achieved)

> "Vibration from the EDF and uneven ground texture caused unreliable velocity estimates" — <a href="#s37" title="S37: U. Kukovič, 2026-03, &quot;TVC Self-Landing Rocket&quot; (Master&#x27;s thesis, University of Maribor, Electrical Engineering — Automation &amp; Robotics; mentor A. Sarjaš), GitHub repository with thesis PDF, code and CAD, CC BY-NC — strongest counter-example SC1; open flown vehicle for SC3; documented absence (horizontal control);…">[S37]</a>, README (optical flow unsuitable for closed-loop horizontal control; stereo vision or radar suggested)

> "The results reveal limitations along the lateral axis, whose resolution is suggested for future work." — <a href="#s38" title="S38: A. Fonte, P. Santos, P. Oliveira, 2025-09-24, &quot;Control and Navigation of a 2-D Electric Rocket&quot;, arXiv preprint — recent; simulation-only; documented open limitation (lateral axis); read: abstract; verified: yes — abstract (&quot;limitations along the lateral axis&quot;)">[S38]</a>, abstract

> "The example controller is for experimental purposes only and it has been tested only lightly." — <a href="#s41" title="S41: ArduPilot Dev Team, n.d. (page current 2026-09-17), &quot;Adding a Custom Controller&quot;, ArduPilot developer documentation — counter-example SC3 (experimentation hook in the COTS autopilot); read: full text; verified: yes — page (`CC_TYPE`, `CC_AXIS_MASK`, RC option 109, bumpless transfer, &quot;tested only lightly&quot;)">[S41]</a>, ArduPilot custom-controller documentation

> "landing gear seems to be not as durable as i would like it to be" — <a href="#s36" title="S36: B. Brocken, 2021-02-27, &quot;SpaceX inspired EDF rocket&quot;, BB Projects (bbprojects.technology) project page — starting point supplied by the user; counter-example SC1 and SC2 (flown, stock ArduPilot SingleCopter); read: full text; verified: yes — page (70 mm 6S EDF, about 2.5 kg thrust, Pixhawk/ArduPilot 4.0.4 SingleC…">[S36]</a>, project log

**Map of what exists (electric tier).**

| Layer | State of the art | Open? |
|---|---|---|
| Stock autopilot on a vane-controlled EDF vehicle | Supported frame type; flown by the starting point <a href="#s40" title="S40: ArduPilot Dev Team, n.d. (page current 2026-09-17), &quot;SingleCopter and CoaxCopter&quot;, ArduPilot Copter documentation — counter-example SC2 (stock support for a one-fan, four-vane vehicle); read: full text; verified: yes — page (`FRAME_CLASS` 8/9, vane servo mapping and parameters)">[S40]</a><a href="#s36" title="S36: B. Brocken, 2021-02-27, &quot;SpaceX inspired EDF rocket&quot;, BB Projects (bbprojects.technology) project page — starting point supplied by the user; counter-example SC1 and SC2 (flown, stock ArduPilot SingleCopter); read: full text; verified: yes — page (70 mm 6S EDF, about 2.5 kg thrust, Pixhawk/ArduPilot 4.0.4 SingleC…">[S36]</a> | Yes (ArduPilot), CAD for sale |
| Custom attitude controller on that autopilot | Framework exists with in-flight switching <a href="#s41" title="S41: ArduPilot Dev Team, n.d. (page current 2026-09-17), &quot;Adding a Custom Controller&quot;, ArduPilot developer documentation — counter-example SC3 (experimentation hook in the COTS autopilot); read: full text; verified: yes — page (`CC_TYPE`, `CC_AXIS_MASK`, RC option 109, bumpless transfer, &quot;tested only lightly&quot;)">[S41]</a> | Yes |
| Custom avionics, hover and soft landing | Done by one student, published with code and CAD <a href="#s37" title="S37: U. Kukovič, 2026-03, &quot;TVC Self-Landing Rocket&quot; (Master&#x27;s thesis, University of Maribor, Electrical Engineering — Automation &amp; Robotics; mentor A. Sarjaš), GitHub repository with thesis PDF, code and CAD, CC BY-NC — strongest counter-example SC1; open flown vehicle for SC3; documented absence (horizontal control);…">[S37]</a> | Yes (CC BY-NC) |
| Research testbeds with optimal / adaptive control | EPFL MPC <a href="#s6" title="S6: R. Linsen, P. Listov, A. de Lajarte, R. Schwan, C. N. Jones, 2022, &quot;Optimal Thrust Vector Control of an Electric Small-Scale Rocket Prototype&quot;, IEEE ICRA 2022; EPFL — carried over; now the nearest academic neighbour (flown electric TVC platform); read: abstract; verified: yes — abstract via OpenAlex (earlier repor…">[S6]</a>; QuadRocket adaptive backstepping <a href="#s5" title="S5: P. Santos, J. Reis, P. Oliveira, C. Silvestre, 2026, &quot;QuadRocket: An Aerial Robotic Testbed for Adaptive Thrust-Vector Control of Rocket-Like Vehicles&quot;, arXiv — carried over; research testbed (electric); read: abstract; verified: yes — abstract (earlier report)">[S5]</a> | Code availability not checked |
| Closed-loop horizontal position control with low-cost onboard sensing | Not achieved in the student thesis <a href="#s37" title="S37: U. Kukovič, 2026-03, &quot;TVC Self-Landing Rocket&quot; (Master&#x27;s thesis, University of Maribor, Electrical Engineering — Automation &amp; Robotics; mentor A. Sarjaš), GitHub repository with thesis PDF, code and CAD, CC BY-NC — strongest counter-example SC1; open flown vehicle for SC3; documented absence (horizontal control);…">[S37]</a>; lateral axis flagged as open in simulation <a href="#s38" title="S38: A. Fonte, P. Santos, P. Oliveira, 2025-09-24, &quot;Control and Navigation of a 2-D Electric Rocket&quot;, arXiv preprint — recent; simulation-only; documented open limitation (lateral axis); read: abstract; verified: yes — abstract (&quot;limitations along the lateral axis&quot;)">[S38]</a> | — |
| Published plant model plus like-for-like controller comparison on one EDF airframe | Not found (search log #4, #8, #11) | — |

The empty cells are the last two rows. The original statement claims the first three.

## Reconciliation

- **Solid-motor review said "university teams stall at static fire"; the electric tier says a single student hovered and landed.** Both are right, and the difference is the propulsion: an EDF gives minutes of throttleable, restartable thrust and can be tested tethered and indoors, so the iteration loop that took Barnard "four years" and ten failed launches on solid motors <a href="#s12" title="S12: J. Barnard, K. Hammond, 2019, &quot;Build Your Own Thrust Vectored Rockets for Vertical Landings Like SpaceX&quot;, Make: — carried over; the solid-motor iteration cost being contrasted; read: full text; verified: yes — article (earlier report)">[S12]</a> collapses to bench and tether sessions. The "stretch" premise was a solid-motor premise. Resolution: drop it.
- **The statement's "commercial platforms" clause and the off-the-shelf reality point in opposite directions.** Under EDF the COTS baseline *is* the actively stabilised vehicle <a href="#s40" title="S40: ArduPilot Dev Team, n.d. (page current 2026-09-17), &quot;SingleCopter and CoaxCopter&quot;, ArduPilot Copter documentation — counter-example SC2 (stock support for a one-fan, four-vane vehicle); read: full text; verified: yes — page (`FRAME_CLASS` 8/9, vane servo mapping and parameters)">[S40]</a>, and the COTS autopilot *is* the experimentation hook <a href="#s41" title="S41: ArduPilot Dev Team, n.d. (page current 2026-09-17), &quot;Adding a Custom Controller&quot;, ArduPilot developer documentation — counter-example SC3 (experimentation hook in the COTS autopilot); read: full text; verified: yes — page (`CC_TYPE`, `CC_AXIS_MASK`, RC option 109, bumpless transfer, &quot;tested only lightly&quot;)">[S41]</a>. Resolution: the project cannot claim to supply a platform the market lacks; it can claim to *use* that hook to run experiments nobody has published for this vehicle class.
- **Research testbeds <a href="#s5" title="S5: P. Santos, J. Reis, P. Oliveira, C. Silvestre, 2026, &quot;QuadRocket: An Aerial Robotic Testbed for Adaptive Thrust-Vector Control of Rocket-Like Vehicles&quot;, arXiv — carried over; research testbed (electric); read: abstract; verified: yes — abstract (earlier report)">[S5]</a><a href="#s6" title="S6: R. Linsen, P. Listov, A. de Lajarte, R. Schwan, C. N. Jones, 2022, &quot;Optimal Thrust Vector Control of an Electric Small-Scale Rocket Prototype&quot;, IEEE ICRA 2022; EPFL — carried over; now the nearest academic neighbour (flown electric TVC platform); read: abstract; verified: yes — abstract via OpenAlex (earlier repor…">[S6]</a> versus student vehicles <a href="#s36" title="S36: B. Brocken, 2021-02-27, &quot;SpaceX inspired EDF rocket&quot;, BB Projects (bbprojects.technology) project page — starting point supplied by the user; counter-example SC1 and SC2 (flown, stock ArduPilot SingleCopter); read: full text; verified: yes — page (70 mm 6S EDF, about 2.5 kg thrust, Pixhawk/ArduPilot 4.0.4 SingleC…">[S36]</a><a href="#s37" title="S37: U. Kukovič, 2026-03, &quot;TVC Self-Landing Rocket&quot; (Master&#x27;s thesis, University of Maribor, Electrical Engineering — Automation &amp; Robotics; mentor A. Sarjaš), GitHub repository with thesis PDF, code and CAD, CC BY-NC — strongest counter-example SC1; open flown vehicle for SC3; documented absence (horizontal control);…">[S37]</a>.** The research testbeds have the controllers; the student vehicles have the openness. Neither publishes a validated plant model with a controller comparison that a third party could rerun, as far as the searches reached. That intersection, plus the documented horizontal-control failure <a href="#s37" title="S37: U. Kukovič, 2026-03, &quot;TVC Self-Landing Rocket&quot; (Master&#x27;s thesis, University of Maribor, Electrical Engineering — Automation &amp; Robotics; mentor A. Sarjaš), GitHub repository with thesis PDF, code and CAD, CC BY-NC — strongest counter-example SC1; open flown vehicle for SC3; documented absence (horizontal control);…">[S37]</a>, is where a defensible EDF statement lives.

## Rewritten statement

> Electric-ducted-fan "rockets" steered by exhaust vanes or a gimballed fan have been hovered and landed by hobbyists on a stock ArduPilot SingleCopter configuration and by a Master's student with custom 100 Hz avionics, and research groups now use electric thrust-vectored vehicles as their standard low-risk testbeds; attitude stabilisation of such a vehicle is a configuration task, not a research gap. What has not been shown at the student tier is closed-loop horizontal position control of an EDF vehicle with low-cost onboard sensing — the one published thesis reports it failed on vibration-corrupted optical flow — and no open EDF testbed publishes a validated plant model together with a like-for-like comparison of controllers flown on the same airframe. This project builds an open EDF thrust-vectoring testbed from the BB Projects design, identifies its plant model from flight data, and uses ArduPilot's custom-controller hook to compare [two or three named controllers] on identical hardware.

**What changed and why:** every clause of the original was replaced, because under electric propulsion each one names something that exists; the new statement acknowledges <a href="#s36" title="S36: B. Brocken, 2021-02-27, &quot;SpaceX inspired EDF rocket&quot;, BB Projects (bbprojects.technology) project page — starting point supplied by the user; counter-example SC1 and SC2 (flown, stock ArduPilot SingleCopter); read: full text; verified: yes — page (70 mm 6S EDF, about 2.5 kg thrust, Pixhawk/ArduPilot 4.0.4 SingleC…">[S36]</a><a href="#s37" title="S37: U. Kukovič, 2026-03, &quot;TVC Self-Landing Rocket&quot; (Master&#x27;s thesis, University of Maribor, Electrical Engineering — Automation &amp; Robotics; mentor A. Sarjaš), GitHub repository with thesis PDF, code and CAD, CC BY-NC — strongest counter-example SC1; open flown vehicle for SC3; documented absence (horizontal control);…">[S37]</a><a href="#s40" title="S40: ArduPilot Dev Team, n.d. (page current 2026-09-17), &quot;SingleCopter and CoaxCopter&quot;, ArduPilot Copter documentation — counter-example SC2 (stock support for a one-fan, four-vane vehicle); read: full text; verified: yes — page (`FRAME_CLASS` 8/9, vane servo mapping and parameters)">[S40]</a><a href="#s41" title="S41: ArduPilot Dev Team, n.d. (page current 2026-09-17), &quot;Adding a Custom Controller&quot;, ArduPilot developer documentation — counter-example SC3 (experimentation hook in the COTS autopilot); read: full text; verified: yes — page (`CC_TYPE`, `CC_AXIS_MASK`, RC option 109, bumpless transfer, &quot;tested only lightly&quot;)">[S41]</a> up front (a reviewer will), and stakes the contribution on the two things the searches did not find — a published plant-model-plus-comparison on one airframe (not-found-by-search, so it must be re-checked against EPFL's and QuadRocket's code releases before it goes in a paper) and horizontal control with cheap sensing (documented absence, <a href="#s37" title="S37: U. Kukovič, 2026-03, &quot;TVC Self-Landing Rocket&quot; (Master&#x27;s thesis, University of Maribor, Electrical Engineering — Automation &amp; Robotics; mentor A. Sarjaš), GitHub repository with thesis PDF, code and CAD, CC BY-NC — strongest counter-example SC1; open flown vehicle for SC3; documented absence (horizontal control);…">[S37]</a><a href="#s38" title="S38: A. Fonte, P. Santos, P. Oliveira, 2025-09-24, &quot;Control and Navigation of a 2-D Electric Rocket&quot;, arXiv preprint — recent; simulation-only; documented open limitation (lateral axis); read: abstract; verified: yes — abstract (&quot;limitations along the lateral axis&quot;)">[S38]</a>).

## Implications for the project

Not part of the audit, but the evidence changes the three-month plan more than it changes the statement:

- **EDF fits the timeline; solid motors did not.** Start from <a href="#s36" title="S36: B. Brocken, 2021-02-27, &quot;SpaceX inspired EDF rocket&quot;, BB Projects (bbprojects.technology) project page — starting point supplied by the user; counter-example SC1 and SC2 (flown, stock ArduPilot SingleCopter); read: full text; verified: yes — page (70 mm 6S EDF, about 2.5 kg thrust, Pixhawk/ArduPilot 4.0.4 SingleC…">[S36]</a> (files for sale, config and code free) on ArduPilot SingleCopter <a href="#s40" title="S40: ArduPilot Dev Team, n.d. (page current 2026-09-17), &quot;SingleCopter and CoaxCopter&quot;, ArduPilot Copter documentation — counter-example SC2 (stock support for a one-fan, four-vane vehicle); read: full text; verified: yes — page (`FRAME_CLASS` 8/9, vane servo mapping and parameters)">[S40]</a>; a stable tethered hover is a weeks-scale milestone, not the deliverable. Then the "experiment" is the custom-controller work <a href="#s41" title="S41: ArduPilot Dev Team, n.d. (page current 2026-09-17), &quot;Adding a Custom Controller&quot;, ArduPilot developer documentation — counter-example SC3 (experimentation hook in the COTS autopilot); read: full text; verified: yes — page (`CC_TYPE`, `CC_AXIS_MASK`, RC option 109, bumpless transfer, &quot;tested only lightly&quot;)">[S41]</a>, which is exactly what a student conference paper can report.
- **Plan for the failures the neighbours reported.** Landing legs break on hard landings <a href="#s36" title="S36: B. Brocken, 2021-02-27, &quot;SpaceX inspired EDF rocket&quot;, BB Projects (bbprojects.technology) project page — starting point supplied by the user; counter-example SC1 and SC2 (flown, stock ArduPilot SingleCopter); read: full text; verified: yes — page (70 mm 6S EDF, about 2.5 kg thrust, Pixhawk/ArduPilot 4.0.4 SingleC…">[S36]</a>; horizontal drift with optical flow is unreliable over EDF vibration <a href="#s37" title="S37: U. Kukovič, 2026-03, &quot;TVC Self-Landing Rocket&quot; (Master&#x27;s thesis, University of Maribor, Electrical Engineering — Automation &amp; Robotics; mentor A. Sarjaš), GitHub repository with thesis PDF, code and CAD, CC BY-NC — strongest counter-example SC1; open flown vehicle for SC3; documented absence (horizontal control);…">[S37]</a>; the custom-controller example is "tested only lightly" <a href="#s41" title="S41: ArduPilot Dev Team, n.d. (page current 2026-09-17), &quot;Adding a Custom Controller&quot;, ArduPilot developer documentation — counter-example SC3 (experimentation hook in the COTS autopilot); read: full text; verified: yes — page (`CC_TYPE`, `CC_AXIS_MASK`, RC option 109, bumpless transfer, &quot;tested only lightly&quot;)">[S41]</a>. Budget is not the constraint, so a motion-capture or UWB positioning setup for indoor tests removes the sensing problem the thesis hit — and turns it into a stated scope boundary rather than a failure.
- **What the simulation will not model** (the sim-to-real list for this vehicle): vane control authority scales with fan throttle, so the plant changes with thrust setting; fan reaction torque in roll <a href="#s37" title="S37: U. Kukovič, 2026-03, &quot;TVC Self-Landing Rocket&quot; (Master&#x27;s thesis, University of Maribor, Electrical Engineering — Automation &amp; Robotics; mentor A. Sarjaš), GitHub repository with thesis PDF, code and CAD, CC BY-NC — strongest counter-example SC1; open flown vehicle for SC3; documented absence (horizontal control);…">[S37]</a>; ESC and fan spool-up lag; IMU vibration at fan blade-pass frequency <a href="#s37" title="S37: U. Kukovič, 2026-03, &quot;TVC Self-Landing Rocket&quot; (Master&#x27;s thesis, University of Maribor, Electrical Engineering — Automation &amp; Robotics; mentor A. Sarjaš), GitHub repository with thesis PDF, code and CAD, CC BY-NC — strongest counter-example SC1; open flown vehicle for SC3; documented absence (horizontal control);…">[S37]</a>; ground effect in the last 20 cm of landing; battery sag over a flight. <a href="#s38" title="S38: A. Fonte, P. Santos, P. Oliveira, 2025-09-24, &quot;Control and Navigation of a 2-D Electric Rocket&quot;, arXiv preprint — recent; simulation-only; documented open limitation (lateral axis); read: abstract; verified: yes — abstract (&quot;limitations along the lateral axis&quot;)">[S38]</a> neglects actuator dynamics and aerodynamics by design — do not inherit that in a hardware project.
- **Safety and rules change class.** A 2.5–3.8 kg-thrust fan is a blade hazard: duct guards, tethers, and a keep-out radius for indoor tests; a 6S LiPo needs a charging and storage protocol. The vehicle is a small UAS <a href="#s46" title="S46: Federal Aviation Administration, n.d., &quot;Small Unmanned Aircraft Systems (UAS) Regulations (Part 107)&quot; — regulatory class of an EDF vehicle (US context only); read: snippet only; verified: no — classification taken from the search summary; the user&#x27;s jurisdiction is unknown">[S46]</a> — check the local registration threshold and where it may be flown; none of the rocketry codes in the earlier review apply.
- **For the expo:** a tethered hover with a live attitude plot and an in-flight switch between two controllers <a href="#s41" title="S41: ArduPilot Dev Team, n.d. (page current 2026-09-17), &quot;Adding a Custom Controller&quot;, ArduPilot developer documentation — counter-example SC3 (experimentation hook in the COTS autopilot); read: full text; verified: yes — page (`CC_TYPE`, `CC_AXIS_MASK`, RC option 109, bumpless transfer, &quot;tested only lightly&quot;)">[S41]</a> is a better demonstration than a single untethered flight, and it is repeatable across a day.

## What would flip it

- **The finding that would overturn this verdict:** for the *rewritten* statement, a public repository or paper that already publishes an EDF vehicle's identified plant model with a like-for-like comparison of two or more controllers flown on the same airframe — most likely EPFL's electric TVC code <a href="#s6" title="S6: R. Linsen, P. Listov, A. de Lajarte, R. Schwan, C. N. Jones, 2022, &quot;Optimal Thrust Vector Control of an Electric Small-Scale Rocket Prototype&quot;, IEEE ICRA 2022; EPFL — carried over; now the nearest academic neighbour (flown electric TVC platform); read: abstract; verified: yes — abstract via OpenAlex (earlier repor…">[S6]</a> if it was released, or QuadRocket's supplementary material <a href="#s5" title="S5: P. Santos, J. Reis, P. Oliveira, C. Silvestre, 2026, &quot;QuadRocket: An Aerial Robotic Testbed for Adaptive Thrust-Vector Control of Rocket-Like Vehicles&quot;, arXiv — carried over; research testbed (electric); read: abstract; verified: yes — abstract (earlier report)">[S5]</a>; or a second thesis that achieved closed-loop horizontal control with low-cost sensing. For the *original* statement there is nothing to flip: it is already closed.
- **Where it would most likely be found:** GitHub (search "EPFL Rocket Team TVC", "QuadRocket"), the EPFL and Lisbon group pages, YouTube (EDF-rocket builds are documented mostly in video), and the Hackster/Hackaday pages that returned 403 <a href="#s42" title="S42: Hackster.io News, n.d., &quot;Ikarus Electric &#x27;Rocket&#x27;&quot; (3D-printed four-vane EDF vehicle that lands on a pad) — same-tier hobbyist lander; read: not accessible; verified: n/a">[S42]</a>.

## Search log

| # | Date | Tool / database | Query (verbatim) | Hits | Surfaced |
|---|---|---|---|---|---|
| 1 | 2026-09-17 | WebFetch | `https://bbprojects.technology/blogs/projects/spacex-inspired-edf-rocket` | page | <a href="#s36" title="S36: B. Brocken, 2021-02-27, &quot;SpaceX inspired EDF rocket&quot;, BB Projects (bbprojects.technology) project page — starting point supplied by the user; counter-example SC1 and SC2 (flown, stock ArduPilot SingleCopter); read: full text; verified: yes — page (70 mm 6S EDF, about 2.5 kg thrust, Pixhawk/ArduPilot 4.0.4 SingleC…">[S36]</a> read |
| 2 | 2026-09-17 | WebSearch | `"EDF rocket" thrust vector control hover landing project open source gimbal electric ducted fan model rocket` | 9 links | <a href="#s37" title="S37: U. Kukovič, 2026-03, &quot;TVC Self-Landing Rocket&quot; (Master&#x27;s thesis, University of Maribor, Electrical Engineering — Automation &amp; Robotics; mentor A. Sarjaš), GitHub repository with thesis PDF, code and CAD, CC BY-NC — strongest counter-example SC1; open flown vehicle for SC3; documented absence (horizontal control);…">[S37]</a> <a href="#s43" title="S43: N. M. Farras, 2024, Master&#x27;s/undergraduate thesis chapter &quot;Thrust Vectoring Control&quot; (70 mm EDF), Institut Teknologi Bandung digital library — same-tier student thesis on EDF TVC; read: snippet only; verified: no — not opened; title and EDF size from search snippet">[S43]</a>; Hackaday.io and Hackster mirrors of <a href="#s36" title="S36: B. Brocken, 2021-02-27, &quot;SpaceX inspired EDF rocket&quot;, BB Projects (bbprojects.technology) project page — starting point supplied by the user; counter-example SC1 and SC2 (flown, stock ArduPilot SingleCopter); read: full text; verified: yes — page (70 mm 6S EDF, about 2.5 kg thrust, Pixhawk/ArduPilot 4.0.4 SingleC…">[S36]</a> |
| 3 | 2026-09-17 | WebFetch | `https://github.com/UrosKukovic/TVC_Self_Landing_Rocket` | README | <a href="#s37" title="S37: U. Kukovič, 2026-03, &quot;TVC Self-Landing Rocket&quot; (Master&#x27;s thesis, University of Maribor, Electrical Engineering — Automation &amp; Robotics; mentor A. Sarjaš), GitHub repository with thesis PDF, code and CAD, CC BY-NC — strongest counter-example SC1; open flown vehicle for SC3; documented absence (horizontal control);…">[S37]</a> read |
| 4 | 2026-09-17 | WebSearch | `"electric ducted fan" rocket prototype "thrust vector" control student thesis OR paper hover VTVL demonstrator 2024 2025` | 10 links | <a href="#s38" title="S38: A. Fonte, P. Santos, P. Oliveira, 2025-09-24, &quot;Control and Navigation of a 2-D Electric Rocket&quot;, arXiv preprint — recent; simulation-only; documented open limitation (lateral axis); read: abstract; verified: yes — abstract (&quot;limitations along the lateral axis&quot;)">[S38]</a> <a href="#s39" title="S39: A. Shumeiko, V. Telekh, S. Ryzhkov, 2025, &quot;Thrust-vectoring schemes for electric propulsion systems: A review&quot;, Chinese Journal of Aeronautics 38(6) — read, not cited — the only &quot;review&quot; surfaced, but it covers spacecraft ion/plasma thrusters, not ducted fans; read: abstract; verified: n/a">[S39]</a> <a href="#s43" title="S43: N. M. Farras, 2024, Master&#x27;s/undergraduate thesis chapter &quot;Thrust Vectoring Control&quot; (70 mm EDF), Institut Teknologi Bandung digital library — same-tier student thesis on EDF TVC; read: snippet only; verified: no — not opened; title and EDF size from search snippet">[S43]</a> <a href="#s6" title="S6: R. Linsen, P. Listov, A. de Lajarte, R. Schwan, C. N. Jones, 2022, &quot;Optimal Thrust Vector Control of an Electric Small-Scale Rocket Prototype&quot;, IEEE ICRA 2022; EPFL — carried over; now the nearest academic neighbour (flown electric TVC platform); read: abstract; verified: yes — abstract via OpenAlex (earlier repor…">[S6]</a>; MDPI Aerospace 2025 EDF static test seen, not opened |
| 5 | 2026-09-17 | WebFetch | `https://arxiv.org/abs/2509.19970` | page | <a href="#s38" title="S38: A. Fonte, P. Santos, P. Oliveira, 2025-09-24, &quot;Control and Navigation of a 2-D Electric Rocket&quot;, arXiv preprint — recent; simulation-only; documented open limitation (lateral axis); read: abstract; verified: yes — abstract (&quot;limitations along the lateral axis&quot;)">[S38]</a> read |
| 6 | 2026-09-17 | WebFetch | `https://www.sciopen.com/article/10.1016/j.cja.2025.103401` | page | <a href="#s39" title="S39: A. Shumeiko, V. Telekh, S. Ryzhkov, 2025, &quot;Thrust-vectoring schemes for electric propulsion systems: A review&quot;, Chinese Journal of Aeronautics 38(6) — read, not cited — the only &quot;review&quot; surfaced, but it covers spacecraft ion/plasma thrusters, not ducted fans; read: abstract; verified: n/a">[S39]</a> read — out of scope (spacecraft electric propulsion) |
| 7 | 2026-09-17 | WebFetch | `https://ardupilot.org/copter/docs/singlecopter-and-coaxcopter.html` | page | <a href="#s40" title="S40: ArduPilot Dev Team, n.d. (page current 2026-09-17), &quot;SingleCopter and CoaxCopter&quot;, ArduPilot Copter documentation — counter-example SC2 (stock support for a one-fan, four-vane vehicle); read: full text; verified: yes — page (`FRAME_CLASS` 8/9, vane servo mapping and parameters)">[S40]</a> read |
| 8 | 2026-09-17 | WebSearch | `EDF rocket kit for sale self-landing electric ducted fan rocket kit educational STEM thrust vectoring product` | 9 links; no commercial kit among them | <a href="#s42" title="S42: Hackster.io News, n.d., &quot;Ikarus Electric &#x27;Rocket&#x27;&quot; (3D-printed four-vane EDF vehicle that lands on a pad) — same-tier hobbyist lander; read: not accessible; verified: n/a">[S42]</a> <a href="#s44" title="S44: Bresc, n.d., &quot;Ducted fan thrust vectoring drone&quot;, Printables.com model — same-tier printable design; read: snippet only; verified: no — not opened">[S44]</a> <a href="#s45" title="S45: RCU Forums thread, n.d., &quot;EDF Thrust Vectoring Autonomous LEM (Lunar Excursion Module) Build&quot; — same-tier hobbyist build; read: snippet only; verified: no — not opened">[S45]</a> |
| 9 | 2026-09-17 | WebFetch | `https://www.hackster.io/news/ikarus-electric-rocket-f5926b65b498` | HTTP 403 | <a href="#s42" title="S42: Hackster.io News, n.d., &quot;Ikarus Electric &#x27;Rocket&#x27;&quot; (3D-printed four-vane EDF vehicle that lands on a pad) — same-tier hobbyist lander; read: not accessible; verified: n/a">[S42]</a> not accessible |
| 10 | 2026-09-17 | WebSearch | `EDF "rocket" electric ducted fan vehicle counts as drone UAS model aircraft regulations not model rocket NAR FAA registration` | 9 links | <a href="#s46" title="S46: Federal Aviation Administration, n.d., &quot;Small Unmanned Aircraft Systems (UAS) Regulations (Part 107)&quot; — regulatory class of an EDF vehicle (US context only); read: snippet only; verified: no — classification taken from the search summary; the user&#x27;s jurisdiction is unknown">[S46]</a> |
| 11 | 2026-09-17 | arXiv API | `(all:"ducted fan" OR all:"electric rocket") AND (all:"thrust vector" OR all:"thrust-vector" OR all:landing)`, sorted by date | totalResults 4, none relevant (legged/humanoid robots) | — |
| 12 | 2026-09-17 | WebFetch | `https://ardupilot.org/dev/docs/copter-adding-custom-controller.html` | page | <a href="#s41" title="S41: ArduPilot Dev Team, n.d. (page current 2026-09-17), &quot;Adding a Custom Controller&quot;, ArduPilot developer documentation — counter-example SC3 (experimentation hook in the COTS autopilot); read: full text; verified: yes — page (`CC_TYPE`, `CC_AXIS_MASK`, RC option 109, bumpless transfer, &quot;tested only lightly&quot;)">[S41]</a> read |

## Searches not run

- **Code releases behind the research testbeds** — whether EPFL's electric TVC prototype <a href="#s6" title="S6: R. Linsen, P. Listov, A. de Lajarte, R. Schwan, C. N. Jones, 2022, &quot;Optimal Thrust Vector Control of an Electric Small-Scale Rocket Prototype&quot;, IEEE ICRA 2022; EPFL — carried over; now the nearest academic neighbour (flown electric TVC platform); read: abstract; verified: yes — abstract via OpenAlex (earlier repor…">[S6]</a> or QuadRocket <a href="#s5" title="S5: P. Santos, J. Reis, P. Oliveira, C. Silvestre, 2026, &quot;QuadRocket: An Aerial Robotic Testbed for Adaptive Thrust-Vector Control of Rocket-Like Vehicles&quot;, arXiv — carried over; research testbed (electric); read: abstract; verified: yes — abstract (earlier report)">[S5]</a> published code or a plant model. This is the single check that could flip the rewritten statement, and it was not made.
- **YouTube** — most hobbyist EDF-rocket builds (including several likely to have flown untethered) are documented only in video.
- **Hackster.io and Hackaday.io project pages** — the Ikarus write-up <a href="#s42" title="S42: Hackster.io News, n.d., &quot;Ikarus Electric &#x27;Rocket&#x27;&quot; (3D-printed four-vane EDF vehicle that lands on a pad) — same-tier hobbyist lander; read: not accessible; verified: n/a">[S42]</a> and the mirrors of <a href="#s36" title="S36: B. Brocken, 2021-02-27, &quot;SpaceX inspired EDF rocket&quot;, BB Projects (bbprojects.technology) project page — starting point supplied by the user; counter-example SC1 and SC2 (flown, stock ArduPilot SingleCopter); read: full text; verified: yes — page (70 mm 6S EDF, about 2.5 kg thrust, Pixhawk/ArduPilot 4.0.4 SingleC…">[S36]</a> returned 403 or were not opened; the ITB thesis <a href="#s43" title="S43: N. M. Farras, 2024, Master&#x27;s/undergraduate thesis chapter &quot;Thrust Vectoring Control&quot; (70 mm EDF), Institut Teknologi Bandung digital library — same-tier student thesis on EDF TVC; read: snippet only; verified: no — not opened; title and EDF size from search snippet">[S43]</a> was not opened.
- **Google Scholar with hit counts and "cited by" from <a href="#s6" title="S6: R. Linsen, P. Listov, A. de Lajarte, R. Schwan, C. N. Jones, 2022, &quot;Optimal Thrust Vector Control of an Electric Small-Scale Rocket Prototype&quot;, IEEE ICRA 2022; EPFL — carried over; now the nearest academic neighbour (flown electric TVC platform); read: abstract; verified: yes — abstract via OpenAlex (earlier repor…">[S6]</a>**; **a second citation hop**; **non-English theses** (the Maribor thesis itself is likely in Slovene; only its README was read).
- **Commercial toy or STEM "landing rocket" drones** — a single-fan toy product could exist under a name the queries did not use.
- **Jurisdiction-specific UAS rules** for the user's location, which is unknown; <a href="#s46" title="S46: Federal Aviation Administration, n.d., &quot;Small Unmanned Aircraft Systems (UAS) Regulations (Part 107)&quot; — regulatory class of an EDF vehicle (US context only); read: snippet only; verified: no — classification taken from the search summary; the user&#x27;s jurisdiction is unknown">[S46]</a> is US-centric context only.

## Sources consulted

| Key | Citation (authors, year, title, venue) | Link (DOI / URL) | Role | Depth read | Verified |
|---|---|---|---|---|---|
| S3 | P. dos Santos, P. Oliveira, 2024, "Thrust vector control and state estimation architecture for low-cost small-scale launchers", Acta Astronautica 222 | https://arxiv.org/abs/2303.16983 | carried over; chaining seed for the Lisbon group | abstract | yes — abstract (earlier report) |
| S4 | P. dos Santos, P. Oliveira, 2023, "ADCS Design for a Sounding Rocket with Thrust Vectoring", Aerotecnica Missili & Spazio 102(3) | https://doi.org/10.1007/s42496-023-00161-w | carried over; chaining seed | abstract | spot-checked — OpenAlex abstract (earlier report) |
| S5 | P. Santos, J. Reis, P. Oliveira, C. Silvestre, 2026, "QuadRocket: An Aerial Robotic Testbed for Adaptive Thrust-Vector Control of Rocket-Like Vehicles", arXiv | https://arxiv.org/abs/2607.02474 | carried over; research testbed (electric) | abstract | yes — abstract (earlier report) |
| S6 | R. Linsen, P. Listov, A. de Lajarte, R. Schwan, C. N. Jones, 2022, "Optimal Thrust Vector Control of an Electric Small-Scale Rocket Prototype", IEEE ICRA 2022; EPFL | https://doi.org/10.1109/ICRA46639.2022.9811938 | carried over; now the nearest academic neighbour (flown electric TVC platform) | abstract | yes — abstract via OpenAlex (earlier report) |
| S12 | J. Barnard, K. Hammond, 2019, "Build Your Own Thrust Vectored Rockets for Vertical Landings Like SpaceX", Make: | https://makezine.com/article/maker-news/build-your-own-thrust-vectored-rockets-for-vertical-landings-like-spacex/ | carried over; the solid-motor iteration cost being contrasted | full text | yes — article (earlier report) |
| S17 | Experimental Sounding Rocket Association, 2025, "IREC Design, Test, & Evaluation Guide", Rev. 2025 V1.1.6 | https://www.soundingrocket.org/uploads/9/0/6/4/9064598/2025-irec_dteg_v1.1.6_02-14-25.pdf | carried over; cited only to say it no longer applies | full text | yes — §7 (earlier report) |
| S36 | B. Brocken, 2021-02-27, "SpaceX inspired EDF rocket", BB Projects (bbprojects.technology) project page | https://bbprojects.technology/blogs/projects/spacex-inspired-edf-rocket | starting point supplied by the user; counter-example SC1 and SC2 (flown, stock ArduPilot SingleCopter) | full text | yes — page (70 mm 6S EDF, about 2.5 kg thrust, Pixhawk/ArduPilot 4.0.4 SingleCopter, four vanes, legs failed, files for sale, config/code free) |
| S37 | U. Kukovič, 2026-03, "TVC Self-Landing Rocket" (Master's thesis, University of Maribor, Electrical Engineering — Automation & Robotics; mentor A. Sarjaš), GitHub repository with thesis PDF, code and CAD, CC BY-NC | https://github.com/UrosKukovic/TVC_Self_Landing_Rocket | strongest counter-example SC1; open flown vehicle for SC3; documented absence (horizontal control) | full text | yes — README (hardware list, 100 Hz cascaded PID, hover and soft-landing results, "could tip over", "unreliable velocity estimates", 0 stars / 0 forks); thesis PDF not opened |
| S38 | A. Fonte, P. Santos, P. Oliveira, 2025-09-24, "Control and Navigation of a 2-D Electric Rocket", arXiv preprint | https://arxiv.org/abs/2509.19970 | recent; simulation-only; documented open limitation (lateral axis) | abstract | yes — abstract ("limitations along the lateral axis") |
| S39 | A. Shumeiko, V. Telekh, S. Ryzhkov, 2025, "Thrust-vectoring schemes for electric propulsion systems: A review", Chinese Journal of Aeronautics 38(6) | https://www.sciopen.com/article/10.1016/j.cja.2025.103401 | read, not cited — the only "review" surfaced, but it covers spacecraft ion/plasma thrusters, not ducted fans | abstract | n/a |
| S40 | ArduPilot Dev Team, n.d. (page current 2026-09-17), "SingleCopter and CoaxCopter", ArduPilot Copter documentation | https://ardupilot.org/copter/docs/singlecopter-and-coaxcopter.html | counter-example SC2 (stock support for a one-fan, four-vane vehicle) | full text | yes — page (`FRAME_CLASS` 8/9, vane servo mapping and parameters) |
| S41 | ArduPilot Dev Team, n.d. (page current 2026-09-17), "Adding a Custom Controller", ArduPilot developer documentation | https://ardupilot.org/dev/docs/copter-adding-custom-controller.html | counter-example SC3 (experimentation hook in the COTS autopilot) | full text | yes — page (`CC_TYPE`, `CC_AXIS_MASK`, RC option 109, bumpless transfer, "tested only lightly") |
| S42 | Hackster.io News, n.d., "Ikarus Electric 'Rocket'" (3D-printed four-vane EDF vehicle that lands on a pad) | https://www.hackster.io/news/ikarus-electric-rocket-f5926b65b498 | same-tier hobbyist lander | not accessible | n/a |
| S43 | N. M. Farras, 2024, Master's/undergraduate thesis chapter "Thrust Vectoring Control" (70 mm EDF), Institut Teknologi Bandung digital library | https://digilib.itb.ac.id/assets/files/2024/MjAyNCBUUyBQUCBOYXVmYWwgTXVoYW1tYWQgRmFycmFzIDEgLSBCQUIgMmEucGRm.pdf | same-tier student thesis on EDF TVC | snippet only | no — not opened; title and EDF size from search snippet |
| S44 | Bresc, n.d., "Ducted fan thrust vectoring drone", Printables.com model | https://www.printables.com/model/722967-ducted-fan-thrust-vectoring-drone | same-tier printable design | snippet only | no — not opened |
| S45 | RCU Forums thread, n.d., "EDF Thrust Vectoring Autonomous LEM (Lunar Excursion Module) Build" | https://www.rcuniverse.com/forum/electric-rc-jets-198/11665275-edf-thrust-vectoring-autonomous-lem-lunar-excursion-module-build.html | same-tier hobbyist build | snippet only | no — not opened |
| S46 | Federal Aviation Administration, n.d., "Small Unmanned Aircraft Systems (UAS) Regulations (Part 107)" | https://www.faa.gov/newsroom/small-unmanned-aircraft-systems-uas-regulations-part-107 | regulatory class of an EDF vehicle (US context only) | snippet only | no — classification taken from the search summary; the user's jurisdiction is unknown |
