Kidus-Tesfaye/edf-tvc-testbed/CAD/views/01_flight_iso.png

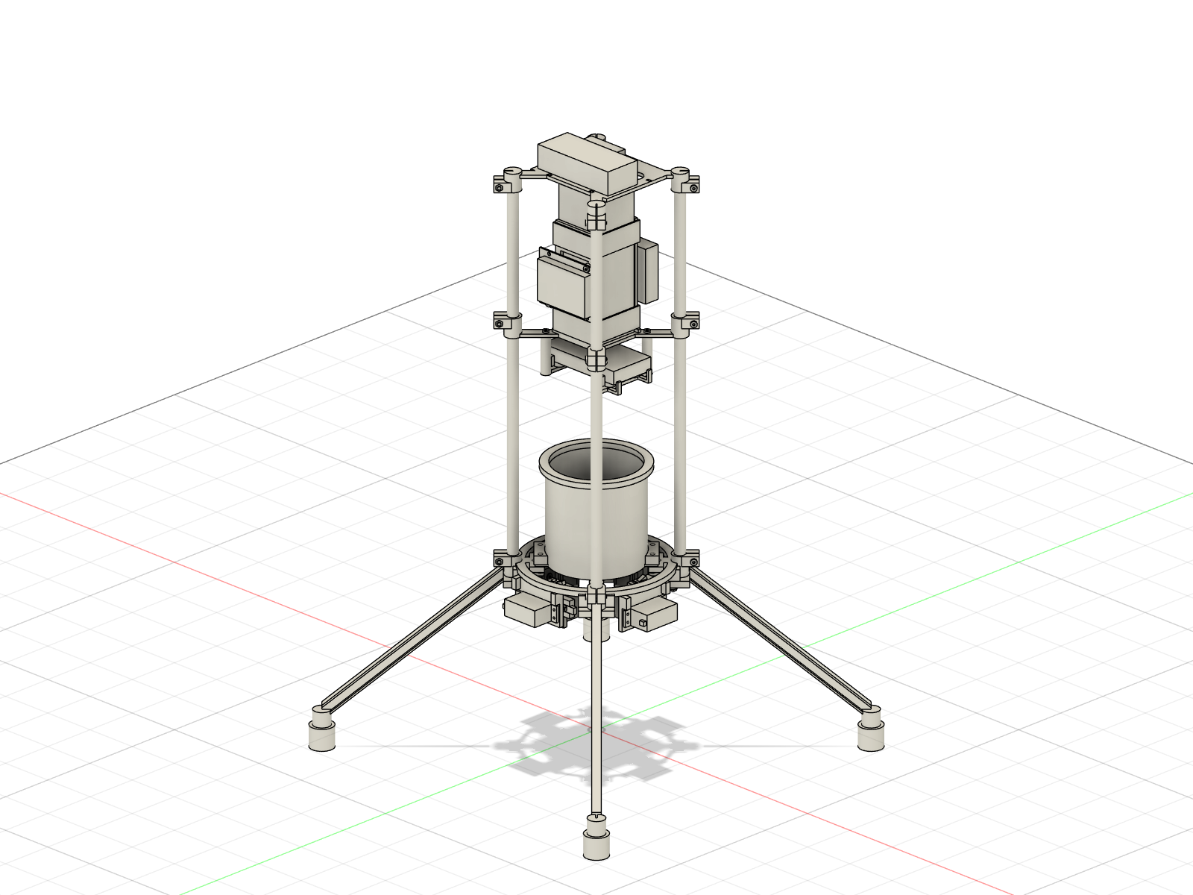
CAD/views/01_flight_iso.png
