Kidus-Tesfaye/edf-tvc-testbed/CAD/views/02_flight_front_from_-Y.png

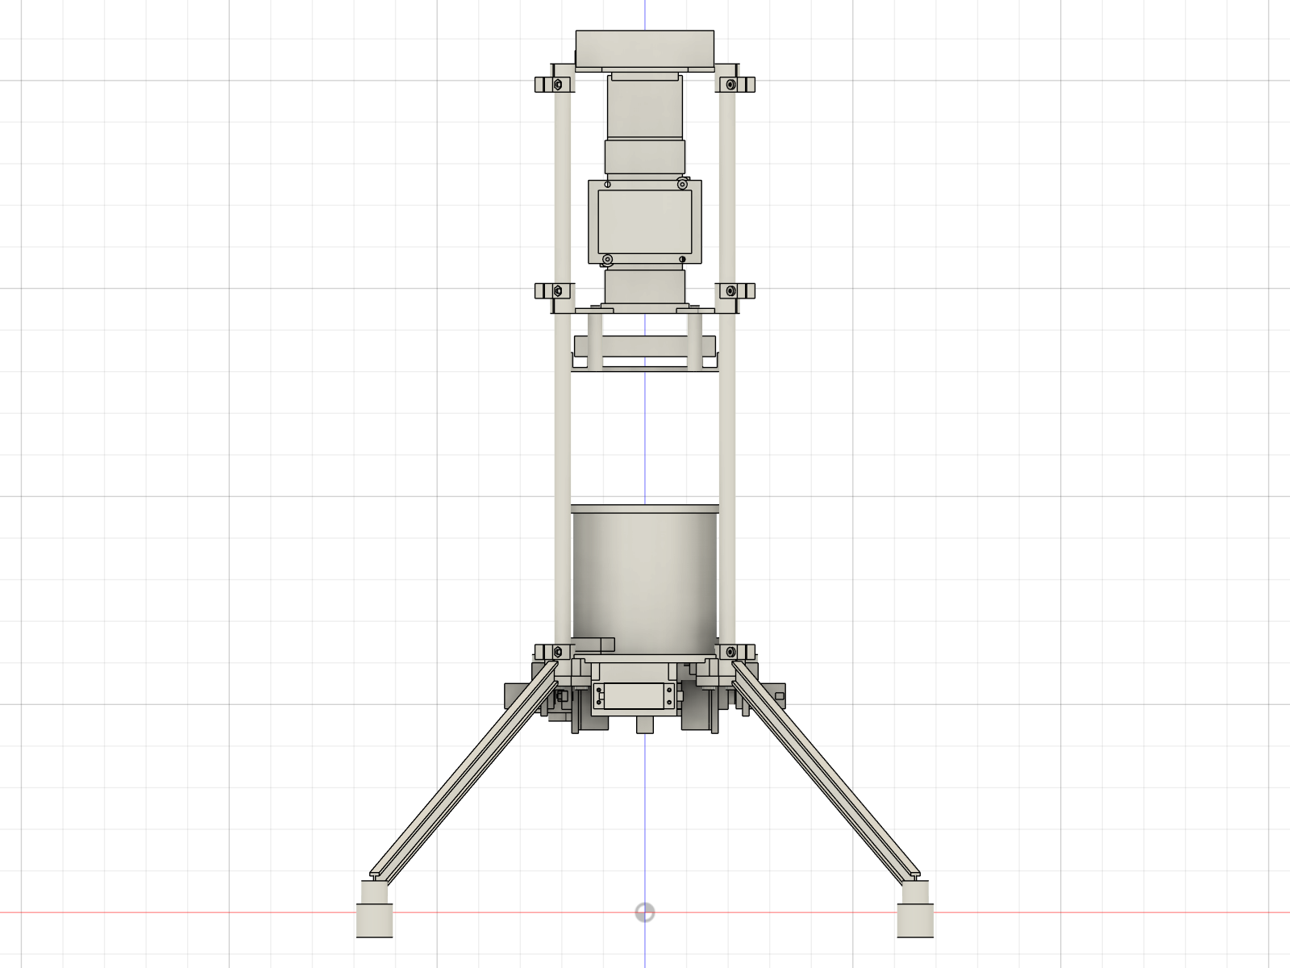
CAD/views/02_flight_front_from_-Y.png
