Kidus-Tesfaye/edf-tvc-testbed/CAD/views/06_flight_top.png

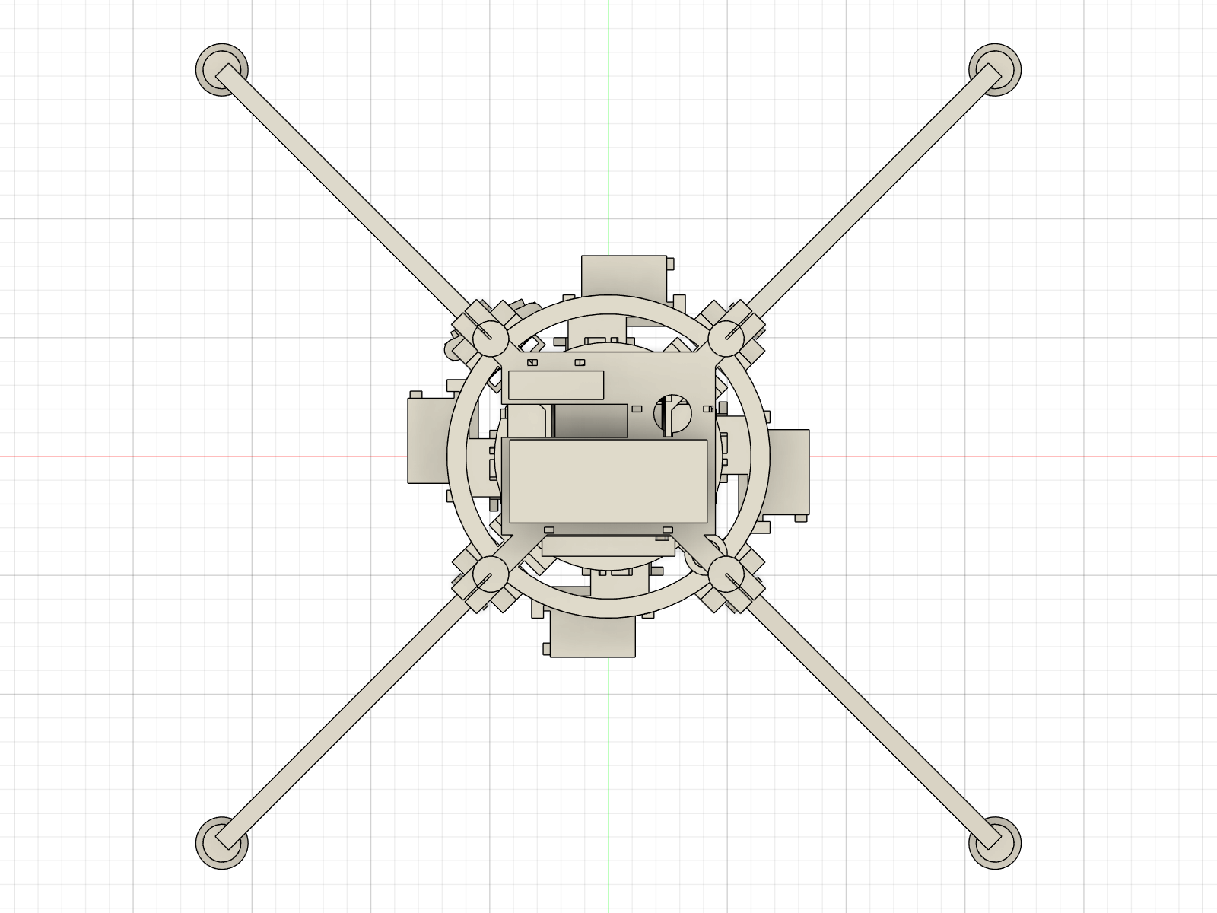
CAD/views/06_flight_top.png
