Kidus-Tesfaye/edf-tvc-testbed/CAD/views/08_exploded_flight.png

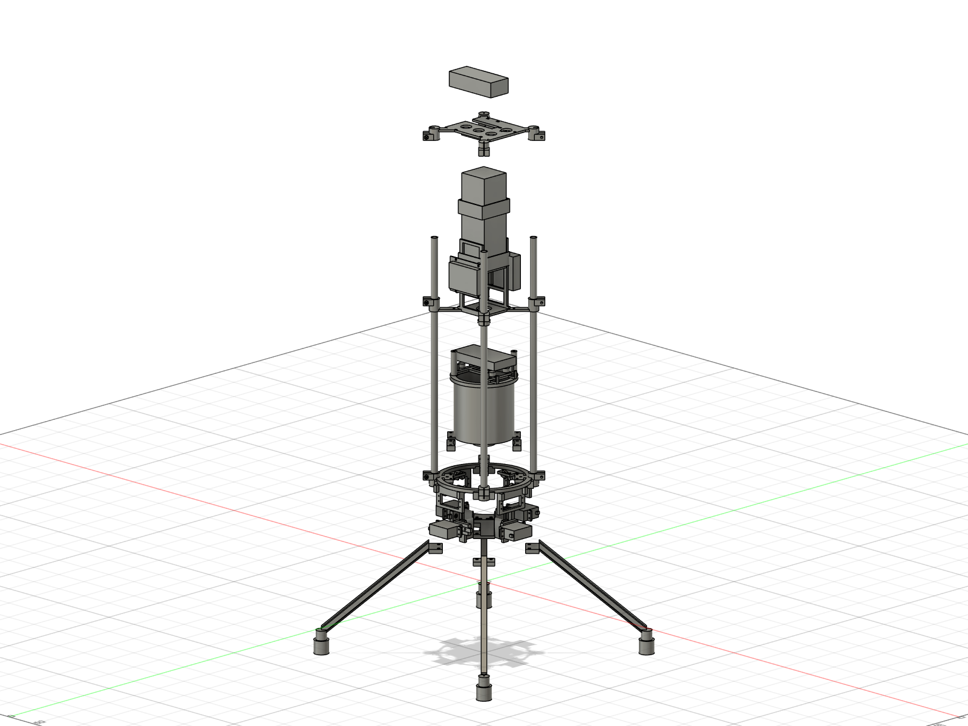
CAD/views/08_exploded_flight.png
