Kidus-Tesfaye/edf-tvc-testbed/CAD/views/09_station_V+X_close_from_-Y.png

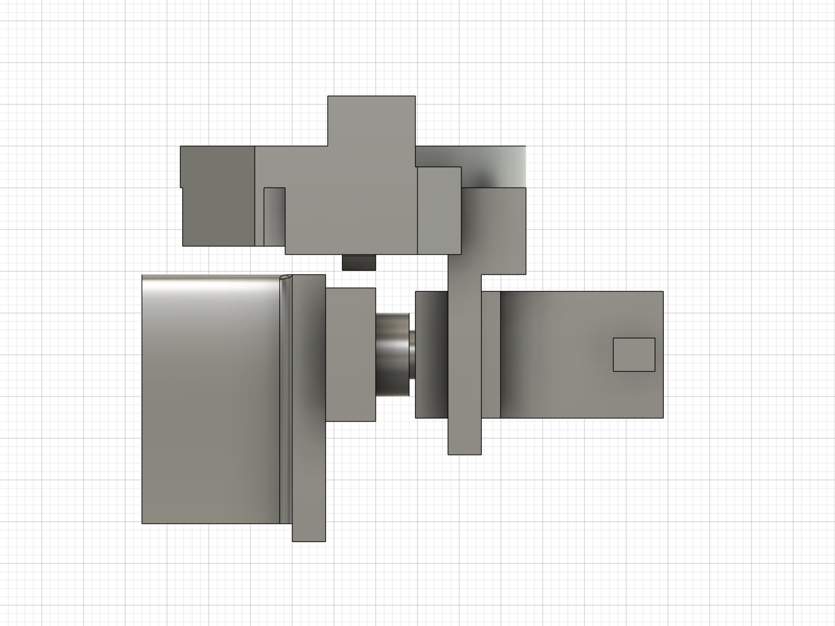
CAD/views/09_station_V+X_close_from_-Y.png
