Kidus-Tesfaye/edf-tvc-testbed/CAD/views/09_station_V+X_close_iso.png

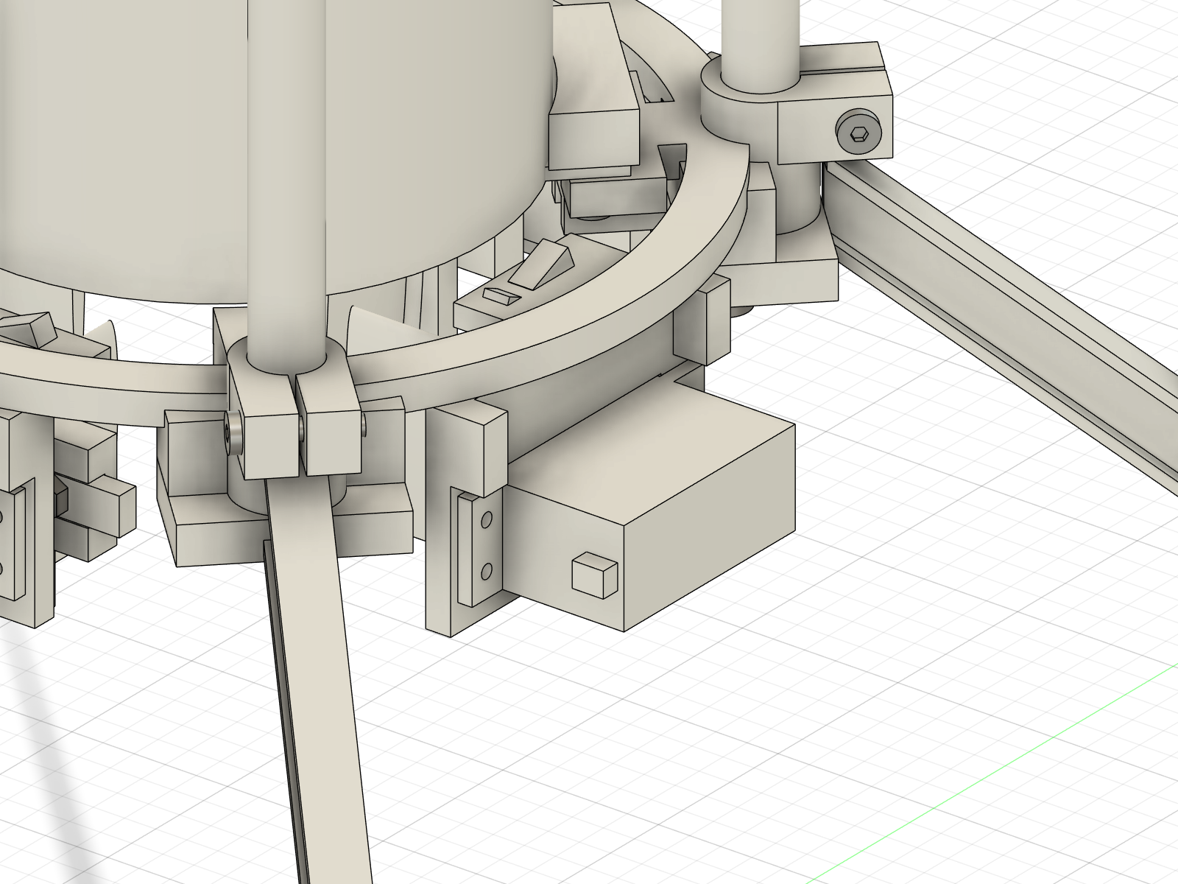
CAD/views/09_station_V+X_close_iso.png
