Kidus-Tesfaye/edf-tvc-testbed/CAD/views/10_section_station_V+X_at_hinge_plane_Z130_from_above.png

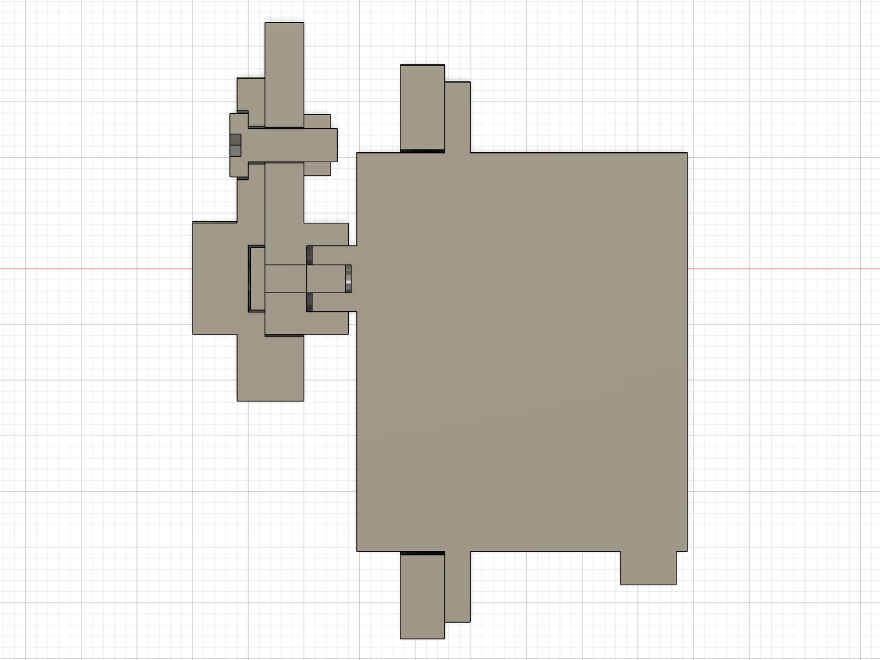
CAD/views/10_section_station_V+X_at_hinge_plane_Z130_from_above.png
