Kidus-Tesfaye/edf-tvc-testbed/CAD/views/10a_section_station_V+X_hinge_plane_Z130_iso.png

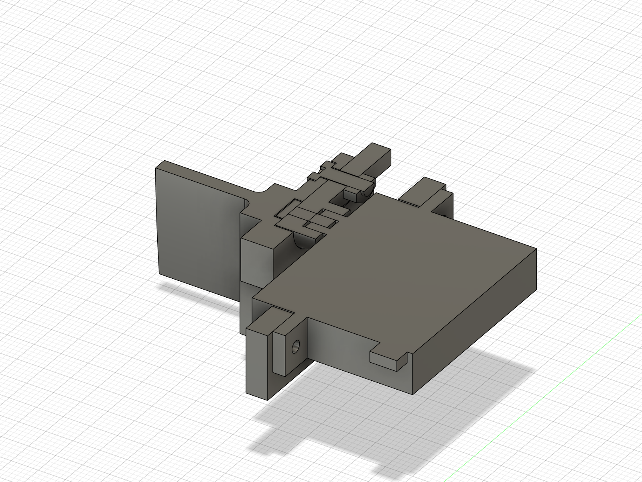
CAD/views/10a_section_station_V+X_hinge_plane_Z130_iso.png
