Kidus-Tesfaye/edf-tvc-testbed/CAD/views/10b_section_station_V+X_plane_Y0_through_hinge_axis_from_-Y.png

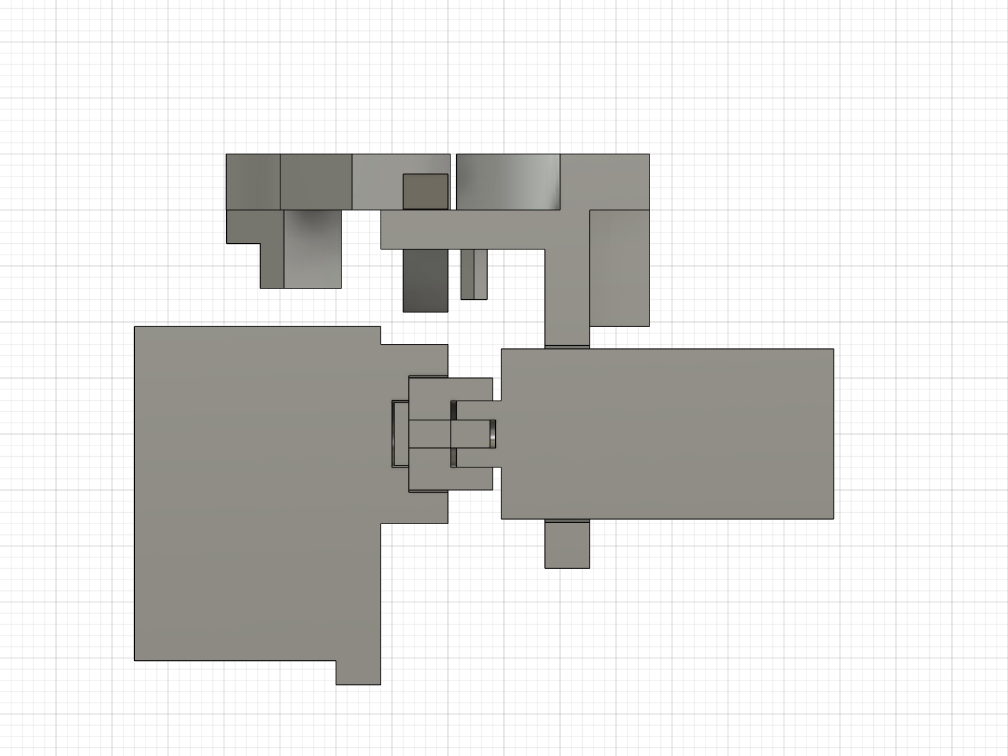
CAD/views/10b_section_station_V+X_plane_Y0_through_hinge_axis_from_-Y.png
