Kidus-Tesfaye/edf-tvc-testbed/CAD/views/11_station_V+X_pose_+20_deg_along_hinge_axis.png

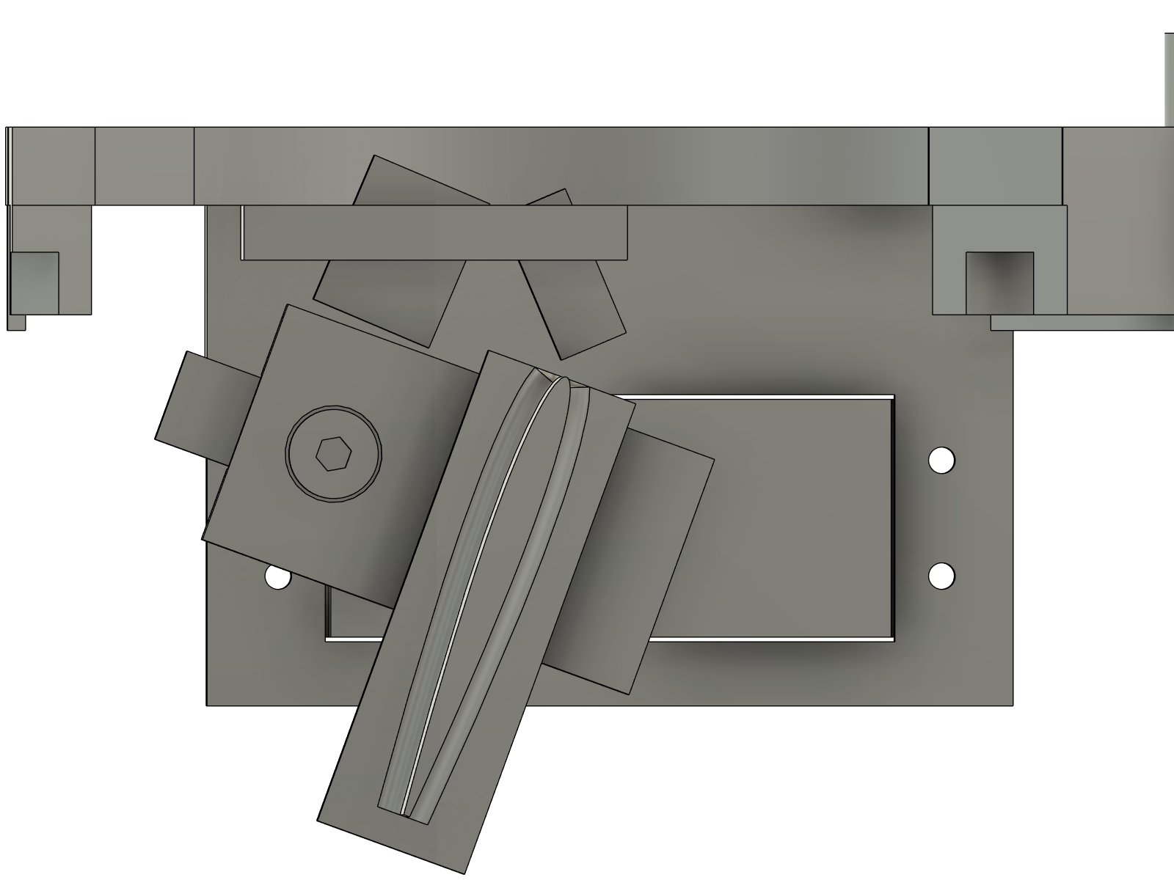
CAD/views/11_station_V+X_pose_+20_deg_along_hinge_axis.png
