Kidus-Tesfaye/edf-tvc-testbed/CAD/views/11_station_V+X_pose_+stop_from_-Y.png

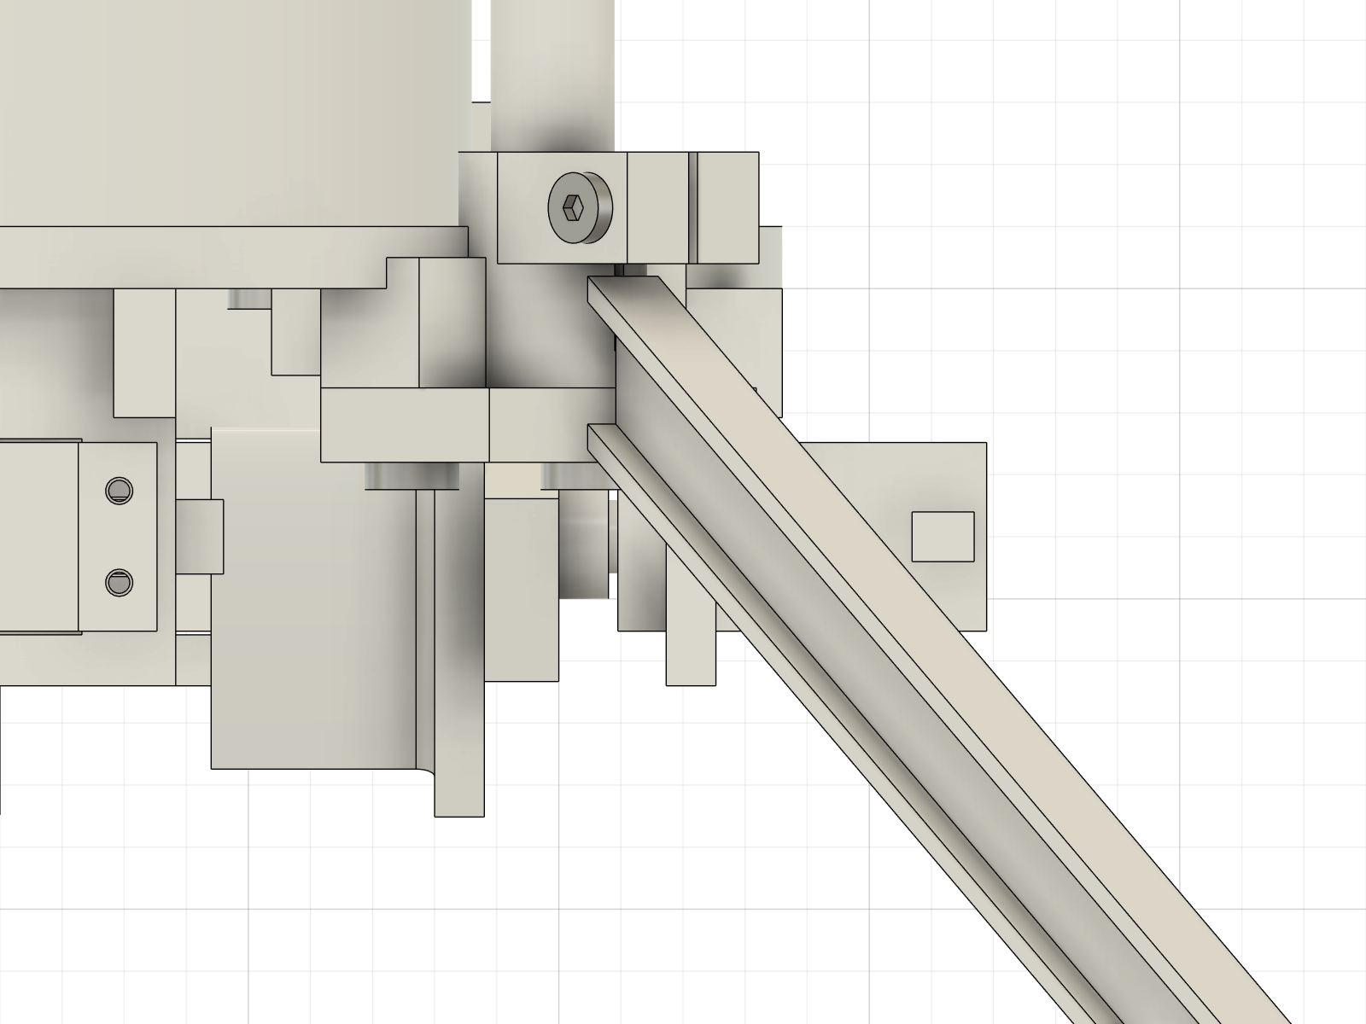
CAD/views/11_station_V+X_pose_+stop_from_-Y.png
