Kidus-Tesfaye/edf-tvc-testbed/CAD/views/12_battery_sliding_out_60mm_-X.png

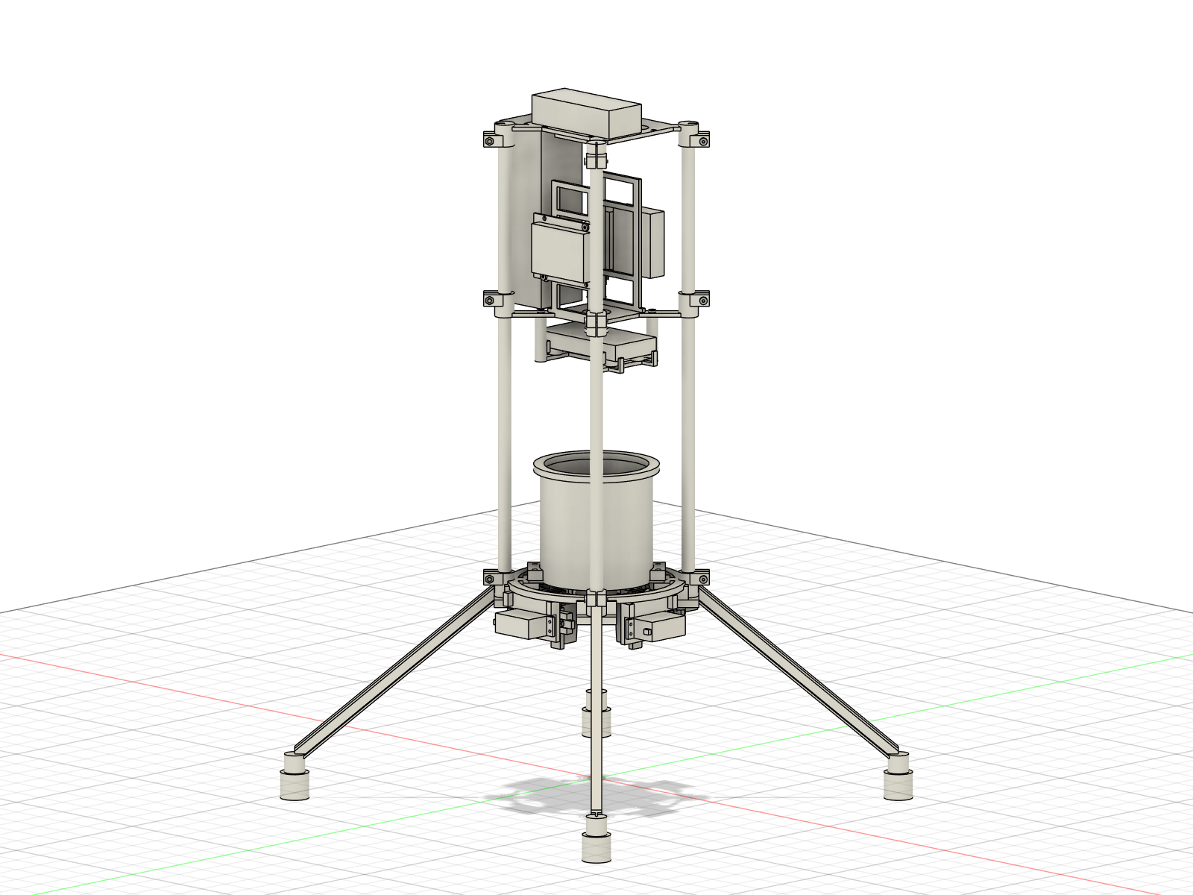
CAD/views/12_battery_sliding_out_60mm_-X.png
