Kidus-Tesfaye/edf-tvc-testbed/CAD/views/15_R3_fixed_vane_option_fitted_from_below.png

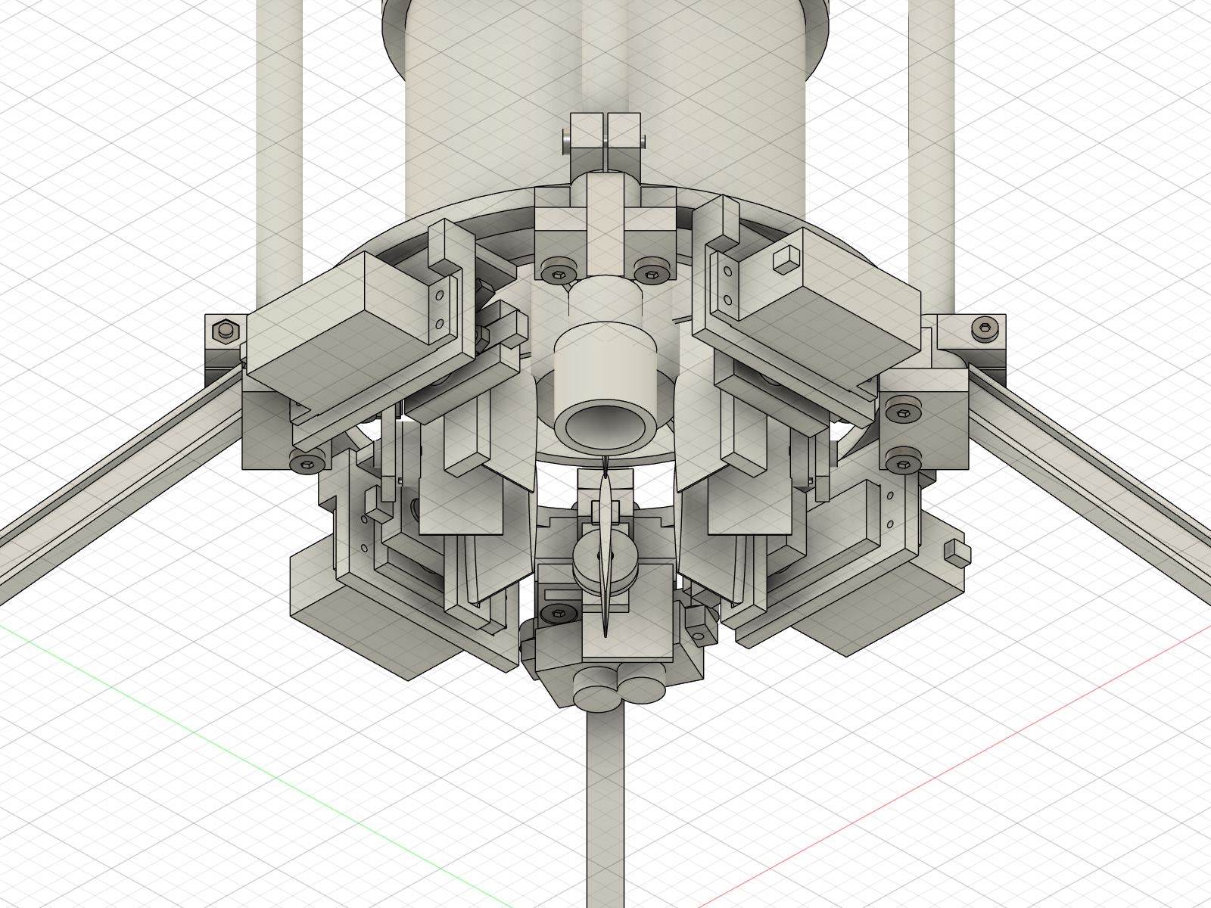
CAD/views/15_R3_fixed_vane_option_fitted_from_below.png
