Kidus-Tesfaye/edf-tvc-testbed/CAD/views/17a_intake_guard_fitted_iso.png

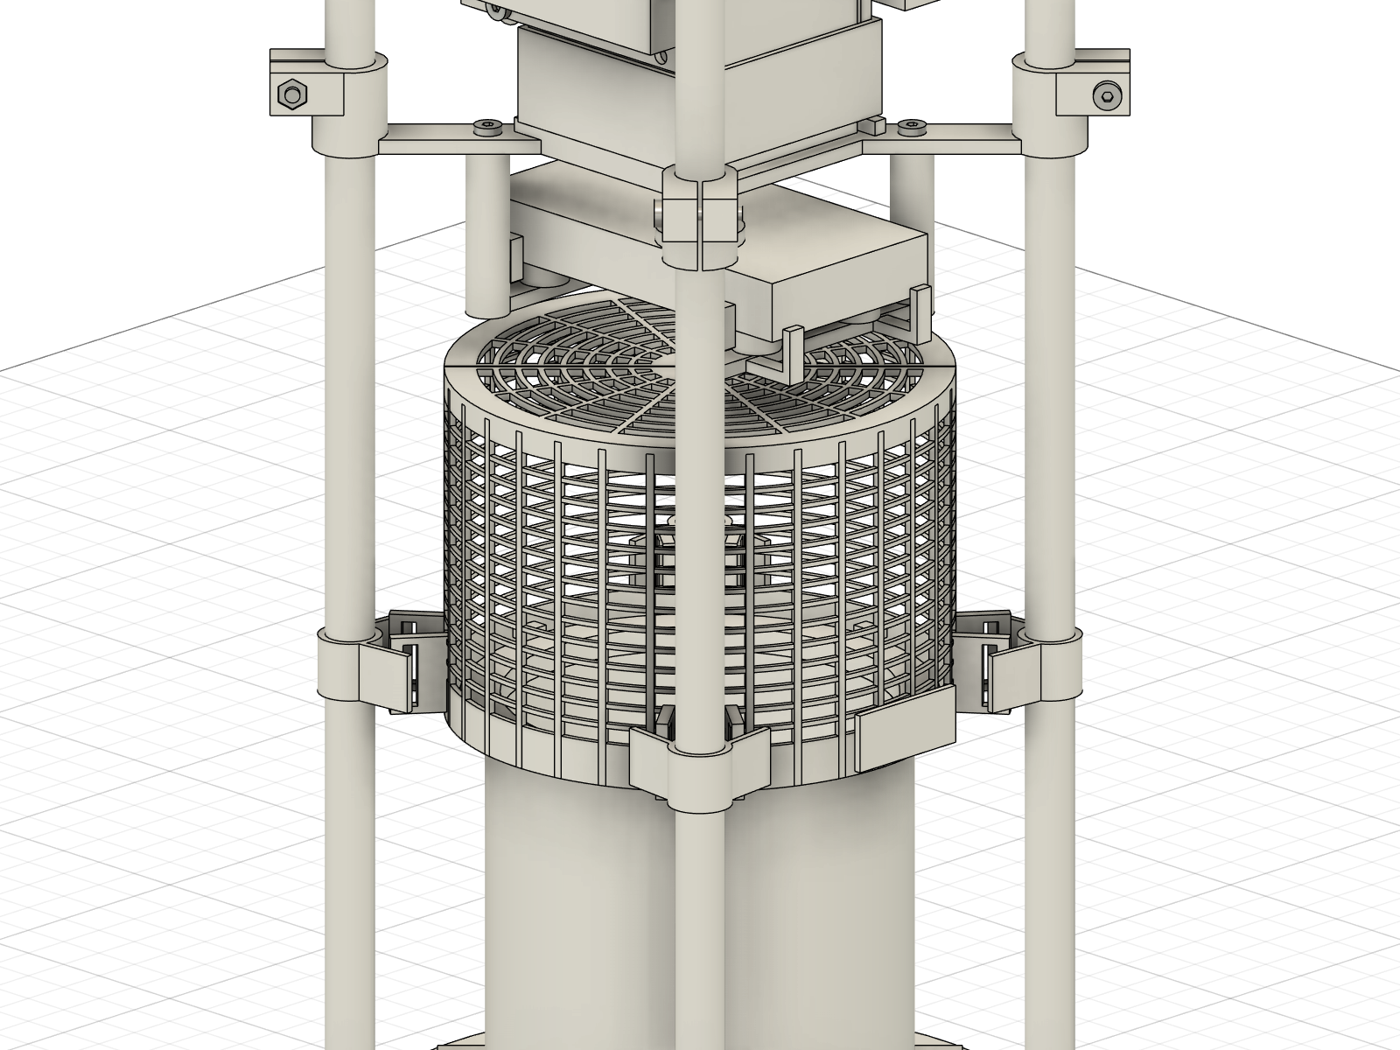
CAD/views/17a_intake_guard_fitted_iso.png
