Kidus-Tesfaye/edf-tvc-testbed/CAD/views/17b_intake_guard_fitted_front_from_-Y.png

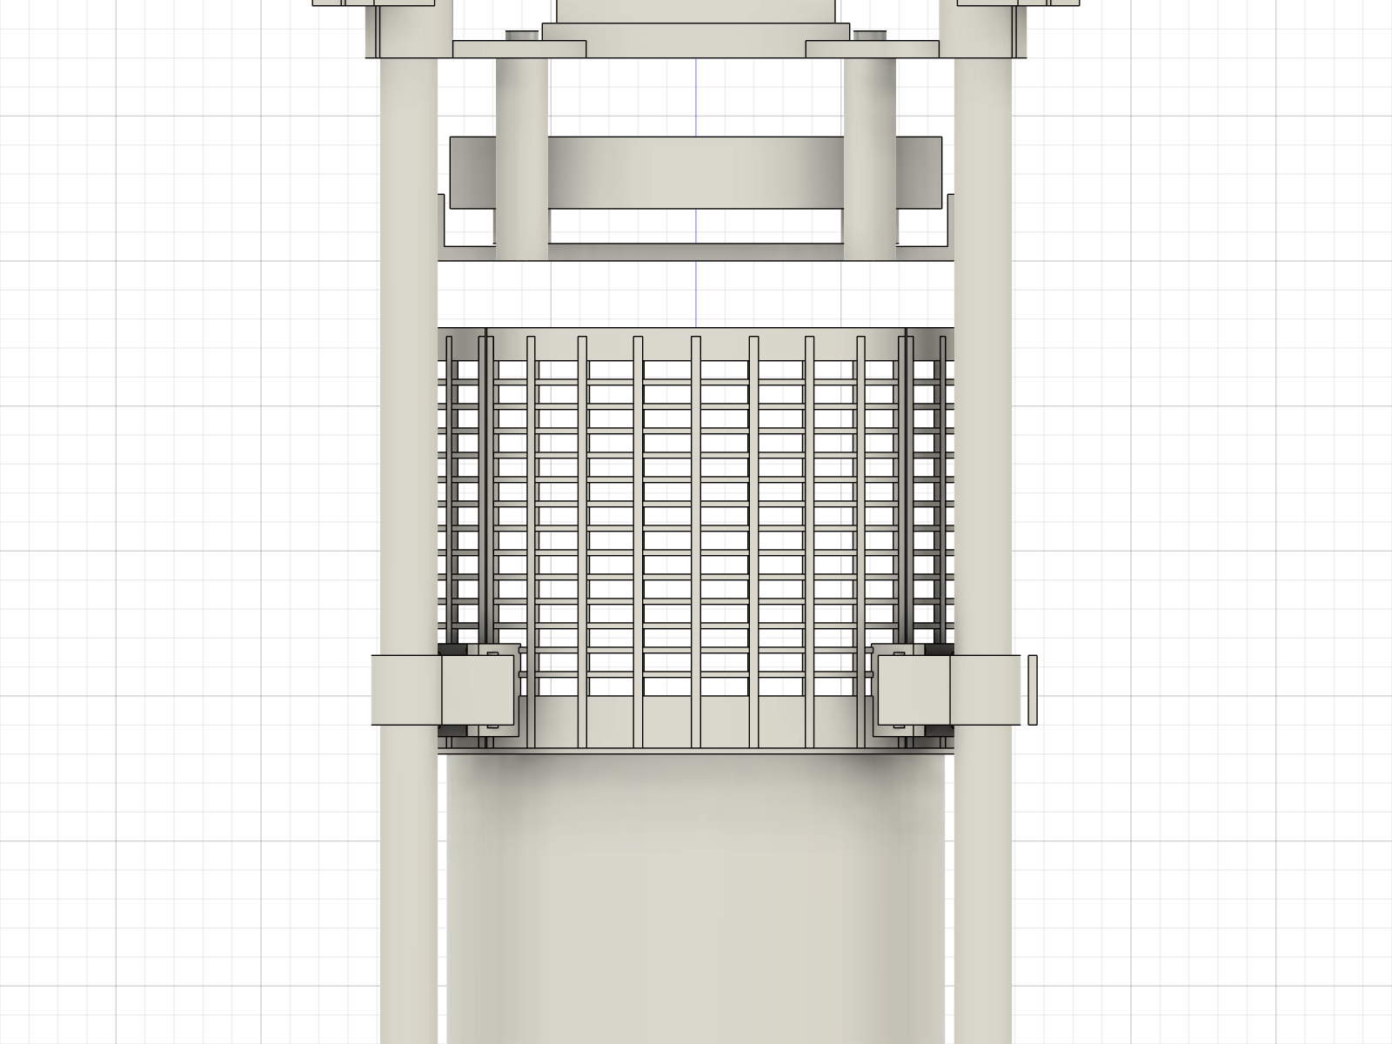
CAD/views/17b_intake_guard_fitted_front_from_-Y.png
