Kidus-Tesfaye/edf-tvc-testbed/CAD/views/18a_pixhawk_stops_iso.png

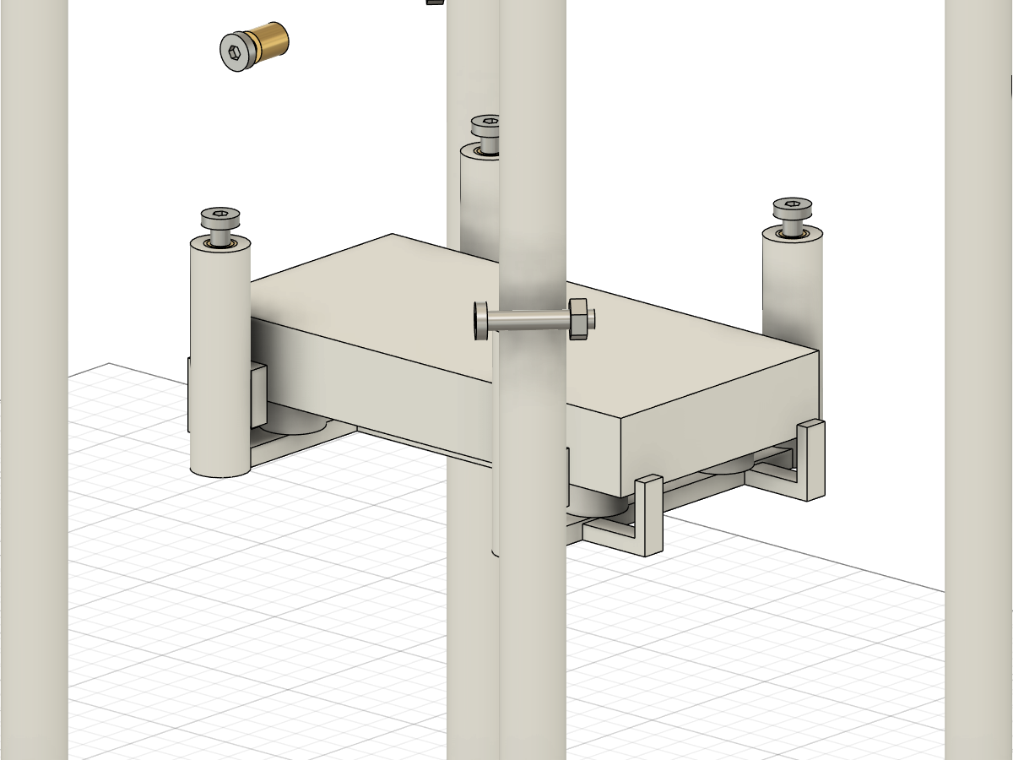
CAD/views/18a_pixhawk_stops_iso.png
