Kidus-Tesfaye/edf-tvc-testbed/CAD/views/18b_pixhawk_stops_from_-Y.png

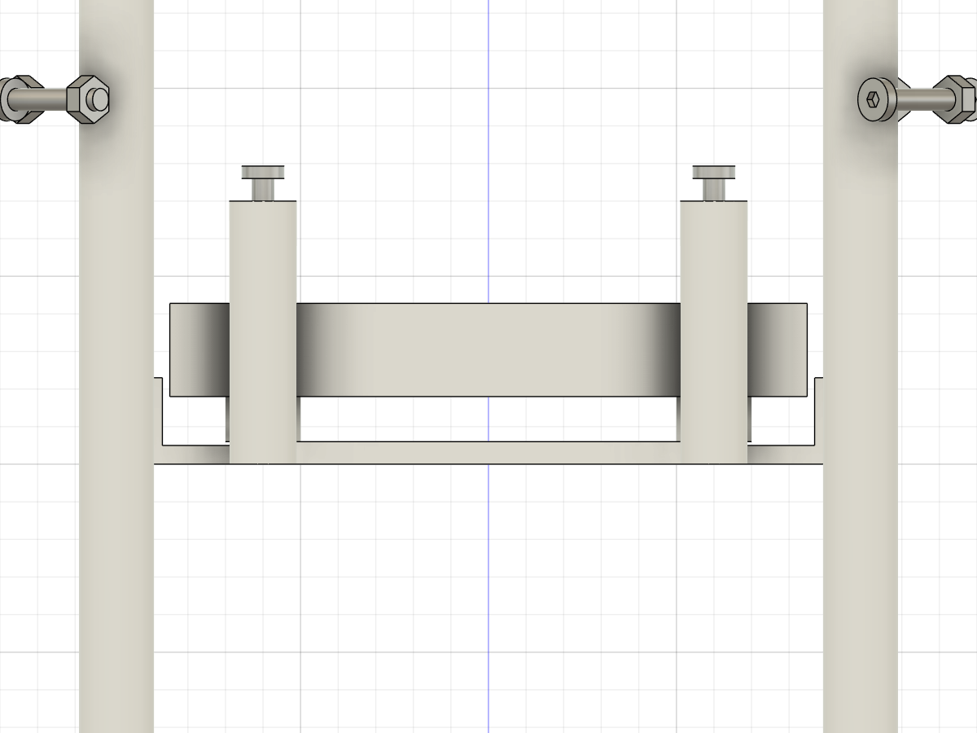
CAD/views/18b_pixhawk_stops_from_-Y.png
