Kidus-Tesfaye/edf-tvc-testbed/bom/extracted_rows.md

# Extracted BOM rows and links (from Updated_Gimbal_Testbed_BOM_with_Arduino_with_Embedded.docx)

| # | Category | Component | Qty | Unit AED | Total AED | Vendor cell text | Link(s) |
|---|---|---|---|---|---|---|---|
| 1 | Propulsion | 70 mm 12-blade EDF unit, 6S-capable | 2 | 225 | 450 | Amazon | [Amazon](https://www.amazon.ae/POENVFPO-Lightweight-Efficiency-Accessories-Enthusiasts/dp/B0G2YPSDJ6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) |
| 2 | Propulsion | 100 A brushless ESC, 6S compatible | 2 | 158 | 316 | Amazon | [Amazon](https://www.amazon.com/dp/B0D39GH5JF?lv=shuf&channelId=500&plpRedirect=mhFallback&th=1) |
| 3 | Power | 6S Lipo Battery 4000mAh 22.2V 100C (bench testing) / 6S Lipo Battery 3300mAh 22.2V 120C (flight pack) | 1 / 1 | 359 / 290 | 649 | Amazon / Amazon | [Amazon](https://www.amazon.ae/Zeee-4000mAh-22-2V-100C-Helicopter/dp/B0F4XFQS5G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)<br>[Amazon](https://www.amazon.ae/Zeee-Battery-Connector-Airplane-Helicopter/dp/B0FNMP8STK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) |
| 4 | Power | 6S balance charger with storage mode | 1 | 173 | 173 | Amazon | [Amazon](https://amzn.eu/d/00YRU9iJ) |
| 5 | Safety | LiPo fire-resistant charging/storage bag | 1 | 28 | 28 | Amazon.ae / hobby retailer | [Amazon.ae / hobby retailer](https://amzn.eu/d/0hyYz9iI) |
| 6 | Instrumentation | Inline high-current watt/power meter (optional) | 1 | 52 | 52 | RC electronics supplier | [RC electronics supplier](https://amzn.eu/d/0gBDlyTM) |
| 7 | Instrumentation | Thrust measurement kit / load-cell stand | 1 | 255 | 255 | Ali-express | [Ali-express](https://ar.aliexpress.com/item/32997870524.html?gatewayAdapt=glo2ara#nav-review) |
| 8 | Control | Pixhawk 6C flight controller, Aluminum casing, PM07 Module | 1 | 807.4 | 807.4 | Holybro – official manufacturer | [Holybro – official manufacturer](https://holybro.com/products/pixhawk-6c?variant=42420293599421) |
| 10 | Power/Control | 2-6S high-current UBEC, 10 A continuous / 15 A peak class | 2 | 105 | 210 | HobbyWingDirect / Amazon | [HobbyWingDirect](https://www.hobbywingdirect.com/products/ubec-10a)<br>[Amazon](https://www.amazon.ae/CHICIRIS-Adjustable-Waterproof-Performance-Quadcopter/dp/B0HBB71FD7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) |
| 11 | Safety | Latching mushroom emergency-stop switch | 1 | 31 | 31 | RS UAE / industrial supplier | [RS UAE / industrial supplier](https://amzn.eu/d/0iW9w0GX) |
| 12 | Safety/Power | TE Connectivity LEV100-class 100 A DC contactor | 1 | 175 | 175 | RS UAE | [RS UAE](https://amzn.eu/d/05Eabkha) |
| 13 | Safety/Power | Main fuse holder + appropriately rated spare fuses | 1 | 47 | 47 | RS UAE  and  automotive electrical supplier | [RS UAE](https://amzn.eu/d/0aYNgcaI)<br>[automotive electrical supplier](https://amzn.eu/d/0dQeJM9W) |
| 14 | Power | XT90-S anti-spark connector sets | 1 | 90 | 90 | Amazon | [Amazon](https://amzn.eu/d/0gTKRxiO) |
| 15 | Power | 10/12 AWG silicone wire assortment | 1 | 156 | 156 | 10/12 AWG silicone wire assortment | [10/12 AWG silicone wire assortment](https://amzn.eu/d/0h1lqBdq) |
| 16 | Electrical | Crimp terminals, heat-shrink and braided sleeving kit | 1 | 70 | 70 | RS UAE / Amazon.ae and  RCS supplier | [RS UAE / Amazon.ae](https://amzn.eu/d/04nibuGm)<br>[RCS supplier](https://amzn.eu/d/0gbopxeT) |
| 17 | Actuation | 40 kg-cm metal-gear digital servo, DS3240-class, 2-pack | 1 | 123 | 123 | Amazon.ae / robotics supplier | [Amazon.ae / robotics supplier](https://amzn.eu/d/0dhyJcwB) |
| 18 | Actuation | Heavy-duty metal servo horns | 1 | 66 | 66 | Robotics/RC supplier | [Robotics/RC supplier](https://amzn.eu/d/09Oa1URy) |
| 19 | Actuation | Adjustable pushrods + ball-link set | 1 | 126 | 126 | RC supplier | [RC supplier](https://amzn.eu/d/0aD0ldEh) |
| 20 | Mechanics | 625ZZ ball-bearing pack | 1 | 45 | 45 | Bearing supplier / Amazon.ae | [Bearing supplier / Amazon.ae](https://amzn.eu/d/08ORbNQY) |
| 21 | Mechanics | Steel pivot shafts / shoulder-bolt set | 1 | 98 | 98 | RS UAE / fastener supplier | [RS UAE](https://amzn.eu/d/030UZwzj)<br>[fastener supplier](https://amzn.eu/d/0851RCnY) |
| 22 | Structure | 10 x 8 mm Carbon-fibre tubes | 4 | 35 | 140 | Composite/RC supplier | [Composite/RC supplier](https://amzn.eu/d/0aSbtn76) |
| 23 | Structure | Aluminum extrusion / plate stock for base frame | 1 | 220 | 220 | Local metal supplier |  |
| 24 | Hardware | Stainless M3/M4/M5 fastener assortment | 1 | 47 | 47 | RS UAE / local fastener supplier | [RS UAE / local fastener supplier](https://amzn.eu/d/01qgPMFi) |
| 25 | Structure | Rubber vibration isolators / bobbins | 1 | 41 | 41 | RS UAE | [RS UAE](https://amzn.eu/d/066wOaaF) |
| 26 | Safety | Load-rated tether straps + metal eye bolts | 1 | 52 | 52 | Strap and eye bolt | [Strap](https://amzn.eu/d/00J59Snu)<br>[eye bolt](https://amzn.eu/d/0avC805V) |
| 27 | Safety | Polycarbonate safety shield material | 1 | 130 | 130 | Local plastics supplier |  |
| 28 | Sensors | Independent IMU breakout (BNO085-class or equivalent) | 1 | 111 | 111 | Adafruit / electronics supplier | [Adafruit / electronics supplier](https://www.amazon.ae/BNO085-Precision-Sensor-Interface-Replace/dp/B0F3T788HD) |
| 29 | Instrumentation | Optical/non-contact tachometer | 1 | 109 | 109 | Amazon.ae / instrumentation supplier | [Amazon.ae / instrumentation supplier](https://amzn.eu/d/02ukxVkd) |
| 30 | Instrumentation | External current/voltage sensor module | 1 | 69 | 69 | Electronics supplier | [Electronics supplier](https://amzn.eu/d/09PJFPb6) |
| 31 | Instrumentation | Temperature sensor kit for ESC/motor/battery monitoring | 1 | 294 | 294 | Electronics supplier | [Electronics supplier](https://eshop.se.com/ae/temperature-sensor-kit-for-external-battery-system-e3sopt003.html) |
| 32 | Data | High-endurance microSD cards + USB reader | 1 | 92 | 92 | SanDisk retailer and Amazon.ae | [SanDisk retailer](https://amzn.eu/d/02mGlEAD)<br>[Amazon.ae](https://amzn.eu/d/0f8epI5R) |
| 33 | Fabrication | PETG | 2 | 101 | 202 | Amazon | [Amazon](https://amzn.eu/d/07LLvYvb) |
| 34 | Fabrication | PETG - CF | 2 | 95 | 190 | Amazon | [Amazon](https://amzn.eu/d/0ainyIOF) |
| 35 | Fabrication | Epoxy, thread locker and assembly consumables | 1 | 49 | 49 | RS UAE / hardware supplier | [RS UAE / hardware supplier](https://amzn.eu/d/09nwg224) |
| 36 | Backup Control | Arduino Mega 2560 Rev3 (official) | 1 | 211 | 211 | Arduino / RS | [Arduino / RS](https://amzn.eu/d/0aKwZjF3) |
| TOTAL ROW | Estimated purchased-component total | AED 6,510 | Previous gimbal BOM: AED 6,280 + Arduino Mega 2560 Rev3 allowance: AED 230 |

Rows: 36 (incl. total row) · hyperlinks: 40
