Kidus-Tesfaye/edf-tvc-testbed/bom/Gimbal_Testbed_BOM.docx

# | Category | Component / specification | Qty | Unit AED | Total AED | Suggested vendor/source | Purpose

1 | Propulsion | 80 mm 12-blade EDF unit, 6S-capable | 2 | 238.71 | 477.42 | Amazon (https://www.amazon.com/XFLY-MODEL-Brushless-Inrunner-3280-KV2200-Aircraft/dp/B094Q84CZJ) | Primary thrust source; second unit retained as spare for testing continuity.
2 | Propulsion | 150 A brushless ESC, 6S compatible | 2 | 440 | 880 | Amazon (https://www.amazon.com/Flycolor-FlyDragon-aircraft-helicopter-electronic/dp/B08JJBPPC4) | Drives the EDF motor; one installed and one spare/matched backup.
3 | Power | 6S Lipo Battery 4000mAh 22.2V 100C (bench testing) 6S Lipo Battery 3300mAh 22.2V 120C (flight pack) | 1 1 | 359 290 | 649 | Amazon (https://www.amazon.ae/Zeee-4000mAh-22-2V-100C-Helicopter/dp/B0F4XFQS5G) Amazon (https://www.amazon.ae/Zeee-Battery-Connector-Airplane-Helicopter/dp/B0FNMP8STK) | High-current power source; two batteries support repeat tests and rotation.
4 | Power | 6S balance charger with storage mode | 1 | 173 | 173 | Amazon (https://amzn.eu/d/00YRU9iJ) | Safe charging, balancing and storage charging of LiPo packs.
5 | Safety | LiPo fire-resistant charging/storage bag | 1 | 28 | 28 | Amazon.ae / hobby retailer (https://amzn.eu/d/0hyYz9iI) | Reduces risk during battery charging, transport and storage.
6 | Instrumentation | Inline high-current watt/power meter (optional) | 1 | 52 | 52 | RC electronics supplier (https://amzn.eu/d/0gBDlyTM) | Bench measurement of voltage, current, power and energy draw.
7 | Instrumentation | Thrust measurement kit / load-cell stand | 1 | 252.41 | 252.41 | Ali-express (https://ar.aliexpress.com/item/32997870524.html?gatewayAdapt=glo2ara) | Static thrust calibration and repeatability checks before closed-loop tests.
8 | Control | Pixhawk 6C flight controller, Aluminum casing, PM07 Module | 1 | 807.4 | 807.4 | Holybro – official manufacturer (https://holybro.com/products/pixhawk-6c?variant=42420293599421) | Primary real-time control, IMU sensing, logging and actuator command platform.
10 | Power/Control | 2-6S high-current UBEC, 10 A continuous / 15 A peak class | 2 | 105 | 210 | HobbyWingDirect (https://www.hobbywingdirect.com/products/ubec-10a) / Amazon (https://www.amazon.ae/CHICIRIS-Adjustable-Waterproof-Performance-Quadcopter/dp/B0HBB71FD7) | Dedicated regulated servo/control power to isolate logic from propulsion noise.
11 | Safety | Latching mushroom emergency-stop switch | 1 | 31 | 31 | RS UAE / industrial supplier (https://amzn.eu/d/0iW9w0GX) | Immediate operator-accessible shutdown command for bench and tethered tests.
12 | Safety/Power | EV200AH-class 200 A sealed DC contactor, 12-24 V coil, 1NO | 1 | 363.03 | 363.03 | Amazon.ae (https://www.amazon.ae/dp/B0HFS8CYV8) | Hard high-current propulsion isolation controlled by the safety circuit.
13 | Safety/Power | ANL fuse holders (2) + 150 A / 32 V DC ANL fuses (2) | 1 | 62.74 | 62.74 | Amazon.ae (https://www.amazon.ae/dp/B097K598LQ) | Protects high-current branches from short-circuit and wiring faults.
14 | Power | XT90-S anti-spark connector sets | 1 | 90 | 90 | Amazon (https://amzn.eu/d/0gTKRxiO) | High-current removable battery connection with reduced connector arcing.
15 | Power | 10/12 AWG silicone wire assortment | 1 | 391.63 | 391.63 | Amazon.ae (10 AWG) (https://www.amazon.ae/dp/B07Z4S98J4) / Amazon.ae (12 AWG) (https://www.amazon.ae/dp/B07ZHXLLGC) | Low-resistance propulsion and battery wiring.
16 | Electrical | Crimp terminals, heat-shrink and braided sleeving kit | 1 | 133.40 | 133.40 | Amazon.ae: crimp kit (https://amzn.eu/d/04nibuGm) / heat-shrink (https://amzn.eu/d/0gbopxeT) / braided sleeve (https://www.amazon.ae/dp/B075VR7ZQS) | Reliable terminations, insulation, abrasion protection and cable management.
17 | Actuation | 40 kg-cm metal-gear digital servo, DS3240-class, 2-pack | 1 | 123 | 123 | Amazon.ae / robotics supplier (https://amzn.eu/d/0dhyJcwB) | Two-axis gimbal actuation: pitch and yaw.
18 | Actuation | Heavy-duty metal servo horns | 1 | 66 | 66 | Robotics/RC supplier (https://amzn.eu/d/09Oa1URy) | Transfers servo torque into the gimbal linkage with less flex than plastic horns.
19 | Actuation | M3 adjustable pushrods with ball-link ends, 100 mm, 2-pack | 1 | 79.90 | 79.90 | Amazon.ae (https://www.amazon.ae/dp/B0F4Y2ZS9M) | Low-play mechanical linkage between servos and gimbal axes.
20 | Mechanics | 625ZZ ball-bearing pack | 1 | 24.08 | 24.08 | Bearing supplier / Amazon.ae (https://amzn.eu/d/08ORbNQY) | Low-friction gimbal pivots and repeatable axis alignment.
21 | Mechanics | Stainless shoulder bolts, 5 mm shoulder x M4 x 16 mm (fit 625ZZ), 10-pack | 1 | 54.96 | 54.96 | Amazon.ae (https://www.amazon.ae/dp/B077GYHYSB) | Metal gimbal pivot hardware; should not be 3D printed.
22 | Structure | 10 x 8 mm Carbon-fibre tubes | 4 | 33.67 | 134.68 | Amazon.ae (sold in 2-packs; order 2) (https://www.amazon.ae/dp/B0CTG7TPDM) | Light, stiff structural rails/booms for the testbed.
23 | Structure | Aluminum extrusion / plate stock for base frame | 1 | 220 | 220 | Local metal supplier (https://amzn.eu/d/01MTSYsK) | Rigid non-printed base and fixture structure for tethered testing.
24 | Hardware | Stainless M3/M4/M5 fastener assortment | 1 | 47 | 47 | RS UAE / local fastener supplier (https://amzn.eu/d/01qgPMFi) | Assembly hardware for gimbal, electronics and frame.
25 | Structure | Rubber vibration isolators / bobbins | 1 | 41 | 41 | RS UAE (https://amzn.eu/d/066wOaaF) | Reduces high-frequency EDF vibration reaching control electronics and sensors.
26 | Safety | Load-rated tether straps + metal eye bolts | 1 | 52 | 52 | Strap (https://amzn.eu/d/00J59Snu) and eye bolt (https://amzn.eu/d/0avC805V) | Physical restraint for indoor/tethered experiments; metal load path retained.
27 | Safety | Polycarbonate safety shield material | 1 | 130 | 130 | Local plastics supplier | Operator protection around the EDF and rotating gimbal during bench tests.
28 | Sensors | Independent IMU breakout (BNO085-class or equivalent) | 1 | 111 | 111 | Adafruit / electronics supplier (https://www.amazon.ae/BNO085-Precision-Sensor-Interface-Replace/dp/B0F3T788HD) | Reference sensor for validation and cross-checking Pixhawk attitude measurements.
29 | Instrumentation | Optical/non-contact tachometer | 1 | 109.90 | 109.90 | Amazon.ae / instrumentation supplier (https://amzn.eu/d/02ukxVkd) | Independent RPM verification during propulsion characterization.
30 | Instrumentation | External current/voltage sensor module | 1 | 69 | 69 | Electronics supplier (https://amzn.eu/d/09PJFPb6) | Secondary electrical measurements for data validation.
31 | Instrumentation | Temperature sensors: 4x MAX6675 + K-type thermocouples, 5x DS18B20 probes | 1 | 117.22 | 117.22 | Amazon.ae (MAX6675) (https://www.amazon.ae/dp/B092VV1D2N) / Amazon.ae (DS18B20) (https://www.amazon.ae/dp/B0CG3HMVWL) | Tracks thermal loading during repeated runs.
32 | Data | High-endurance microSD cards + USB reader | 1 | 136.39 | 136.39 | SanDisk High Endurance 64 GB (https://www.amazon.ae/dp/B07P3D6Y5B) and Amazon.ae (reader) (https://amzn.eu/d/0f8epI5R) | Reliable controller/log storage and fast transfer to analysis computer.
33 | Fabrication | PETG | 2 | 101 | 202 | Amazon (https://amzn.eu/d/07LLvYvb) | Prints gimbal rings, mounts, trays, guards and non-metal structural parts.
34 | Fabrication | PETG - CF | 2 | 95 | 190 | Amazon (https://amzn.eu/d/0ainyIOF) | Printing material
35 | Fabrication | Epoxy, thread locker and assembly consumables | 1 | 49 | 49 | RS UAE / hardware supplier (https://amzn.eu/d/09nwg224) | Secures fasteners, inserts and non-serviceable joints during fabrication.
36 | Backup Control | Arduino Mega 2560 Rev3 (official) | 1 | 211.70 | 211.70 | Arduino / RS (https://amzn.eu/d/0aKwZjF3) | Backup/auxiliary controller for bench tests, PWM/servo experiments, sensor interfacing and fallback data acquisition; Pixhawk remains primary controller.
Estimated purchased-component total | | | | | AED 6,065.22 | Previous gimbal BOM: AED 6,280 + Arduino Mega 2560 Rev3 allowance: AED 230

Updated Bill of Materials (BOM)

Two-Axis Gimballed EDF Control Testbed

Revision date: 17 September 2026

A. Purchased Components

B. Components Recommended for 3D Printing

Use printing where custom geometry, rapid iteration and low mass are valuable. Keep the critical rotating/load-bearing and high-current parts as purchased metal/electrical components.

# | 3D-printed part | Suggested material | Why print it

1 | Outer gimbal ring / frame | PETG-CF preferred | Custom geometry; good candidate for stiffness-to-weight optimization.
2 | Inner EDF cradle | PETG-CF preferred | Holds the EDF while allowing two-axis rotation.
3 | Servo mounting brackets | PETG-CF / PETG | Custom hole pattern and easy iterative adjustment.
4 | Linkage support arms / guides | PETG-CF / PETG | Low-load geometry can be iterated quickly.
5 | Pixhawk mounting tray | PETG | Keeps controller isolated and organized.
6 | Arduino mounting tray | PETG | Optional tray for the backup Mega 2560.
7 | Battery/electronics tray | PETG-CF | Custom fit around straps and cable routing.
8 | Electronics enclosure | PETG | Protects low-voltage electronics from accidental contact.
9 | Carbon-tube clamps | PETG-CF | Custom clamp geometry around purchased carbon tubes.
10 | Tether bracket bodies | PETG-CF | Printed body only; use metal eye bolts/inserts for actual load path.
11 | EDF inlet/exhaust guards | PETG | Protective guard geometry; keep clear of rotor and airflow.
12 | Cable guides and strain-relief clips | PETG | Keeps wiring away from gimbal motion and EDF intake.
13 | Outer shell / cosmetic panels | PETG | Non-critical enclosure and presentation finish.
14 | E-stop enclosure | PETG | Houses the purchased industrial mushroom switch.

C. Parts That Should Remain Purchased / Metal

- Gimbal pivot shafts, shoulder bolts and bearing races.
- Load-rated tether eye bolts and the primary restraint load path.
- High-current contactor, fuses, connectors and battery wiring hardware.
- Servo output shafts/horns where metal parts are available.
- The main aluminium base/frame members and protective polycarbonate shield.

Capstone Testbed BOM - Two-Axis Gimballed EDF - Revision 17 Sep 2026
