Kidus-Tesfaye/edf-tvc-testbed/CAD/cad/EDF_PETG_Vehicle_R4_MIN_assembly.step

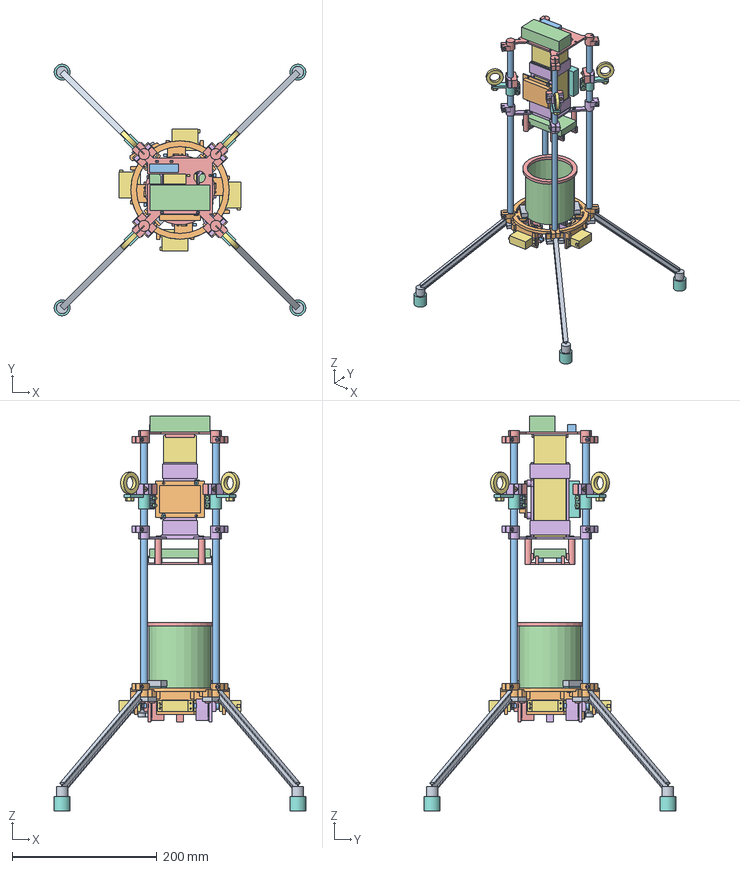
[picture p24: CAD file, 2026-11-08]
CAD/cad/EDF_PETG_Vehicle_R4_MIN_assembly.step
347.2 x 347.2 x 545.0 mm
