Kidus-Tesfaye/edf-tvc-testbed/CAD/cad/R4_R4-TETHER-KIT.step

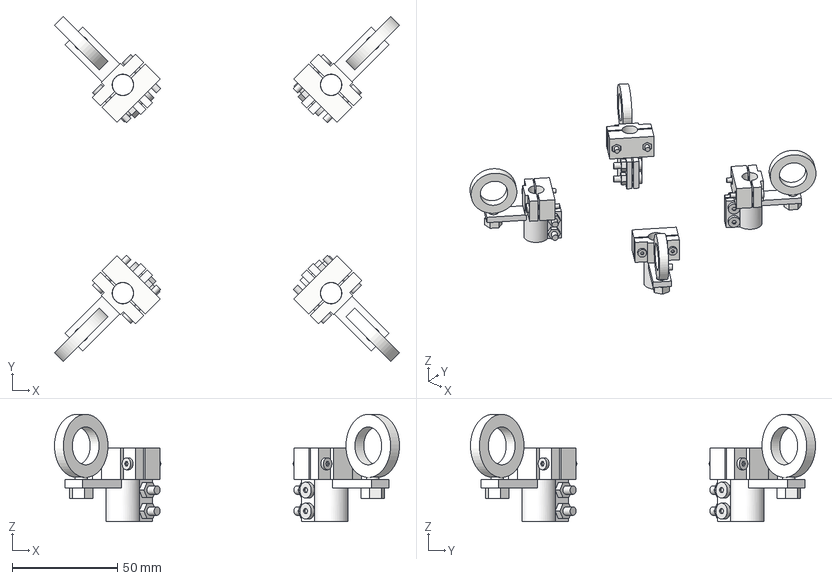
[picture p25: CAD file, 2026-11-08]
CAD/cad/R4_R4-TETHER-KIT.step
164.0 x 164.0 x 51.0 mm
