Kidus-Tesfaye/edf-tvc-testbed/CAD/parts/step/R3-ES-06_fixed_vane.step

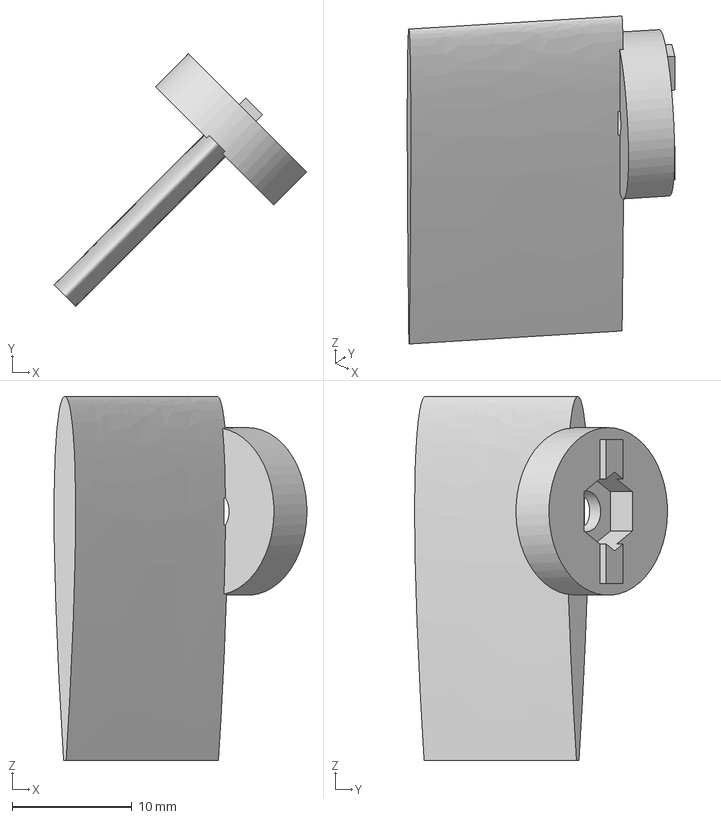
[picture p26: CAD file, 2026-11-08]
CAD/parts/step/R3-ES-06_fixed_vane.step
21.1 x 21.1 x 30.4 mm
