Kidus-Tesfaye/edf-tvc-testbed/CAD/parts/stl/TB-FL-01_testbed_foot_locator.stl

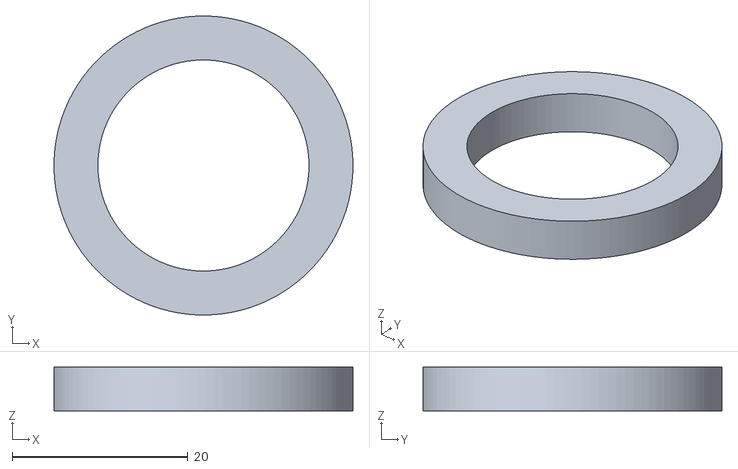
[picture p27: CAD file, 2026-11-08]
CAD/parts/stl/TB-FL-01_testbed_foot_locator.stl
34.0 x 34.0 x 5.00
