Kidus-Tesfaye/edf-tvc-testbed/CAD/parts/step/R4-FL-02_top_plate.step

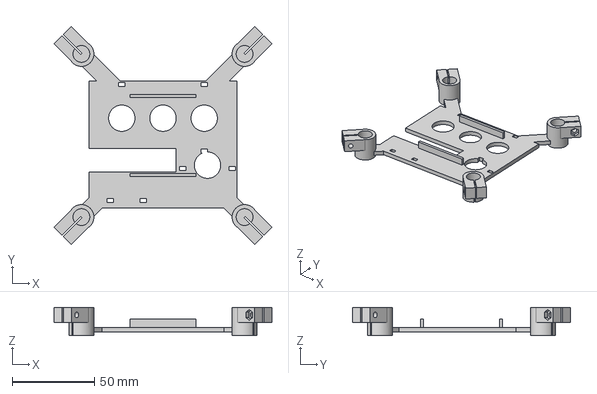
[picture p28: CAD file, 2026-11-08]
CAD/parts/step/R4-FL-02_top_plate.step
132.2 x 132.2 x 17.0 mm
