Kidus-Tesfaye/edf-tvc-testbed/CAD/parts/step/R3-TT-03_tether_backup_stop.step

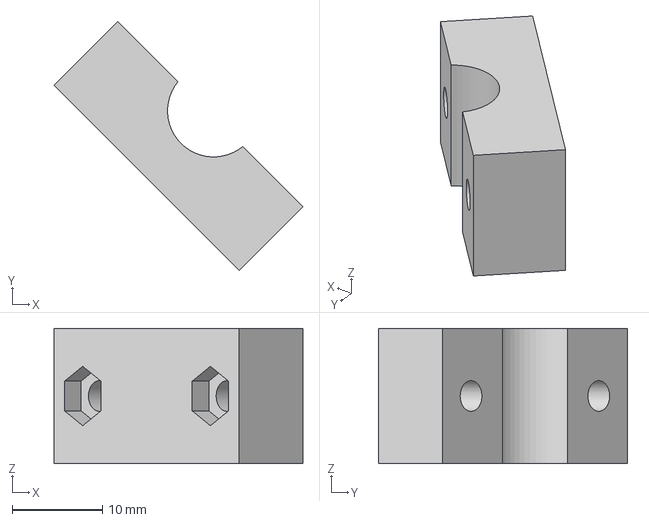
[picture p29: CAD file, 2026-11-08]
CAD/parts/step/R3-TT-03_tether_backup_stop.step
27.6 x 27.6 x 15.0 mm
