Kidus-Tesfaye/edf-tvc-testbed/CAD/parts/step/R3-ES-07_fixed_vane_angle_insert_0deg.step

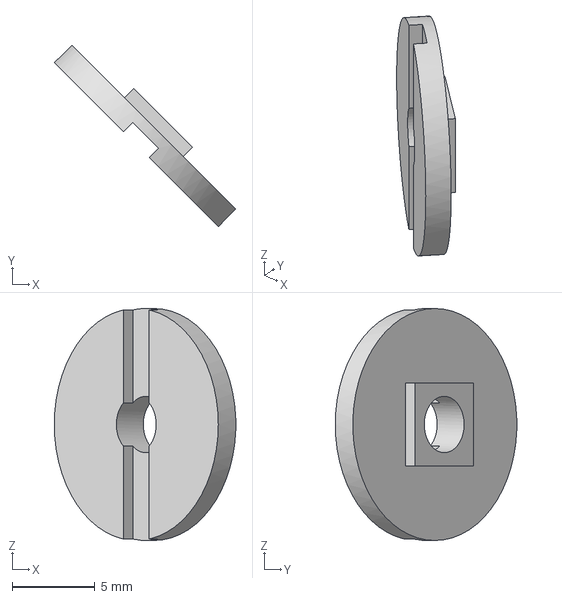
[picture p30: CAD file, 2026-11-08]
CAD/parts/step/R3-ES-07_fixed_vane_angle_insert_0deg.step
11.0 x 11.0 x 14.0 mm
