Kidus-Tesfaye/edf-tvc-testbed/CAD/parts/step/R4-FL-01_mid_plate.step

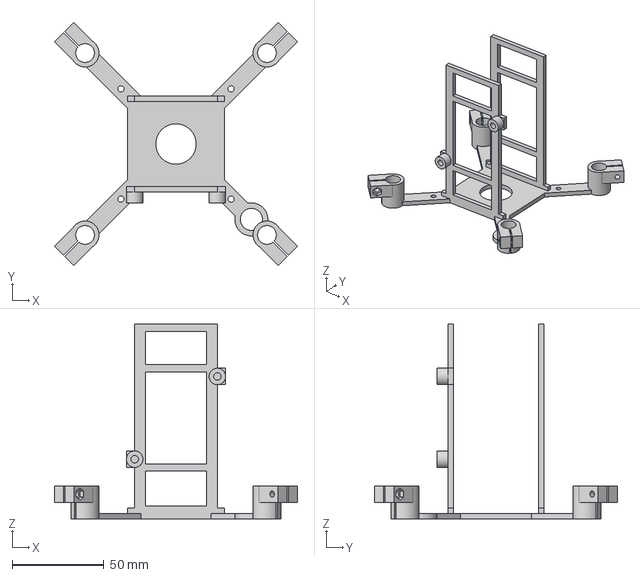
[picture p31: CAD file, 2026-11-08]
CAD/parts/step/R4-FL-01_mid_plate.step
132.2 x 132.2 x 106.0 mm
