Kidus-Tesfaye/edf-tvc-testbed/CAD/parts/step/R3-FR-11T_tether_backup_stop_cap.step

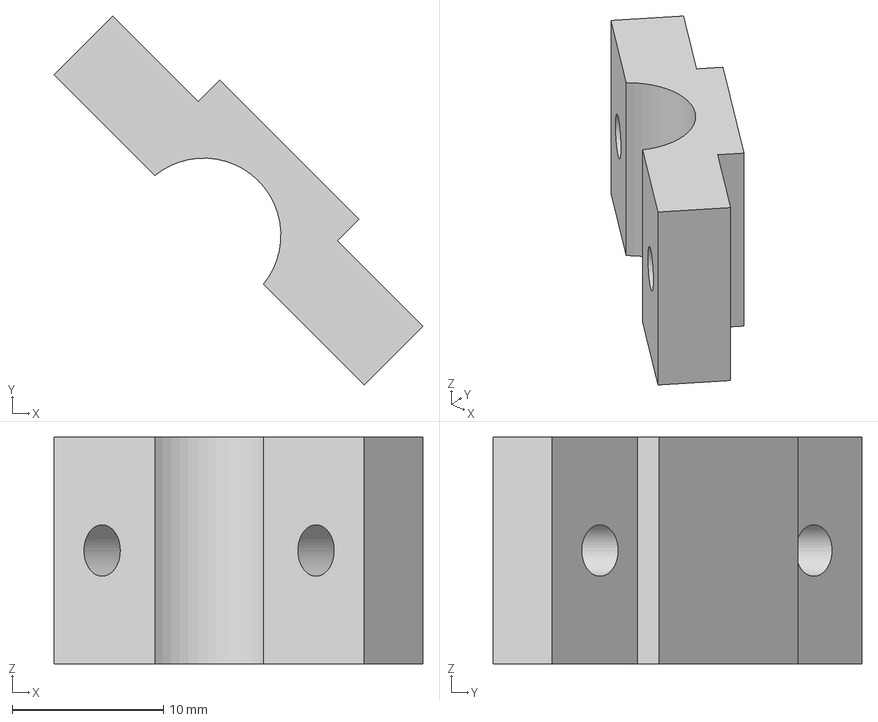
[picture p32: CAD file, 2026-11-08]
CAD/parts/step/R3-FR-11T_tether_backup_stop_cap.step
24.4 x 24.4 x 15.0 mm
