Kidus-Tesfaye/edf-tvc-testbed/CAD/parts/step/R4-FR-02_tube_plug.step

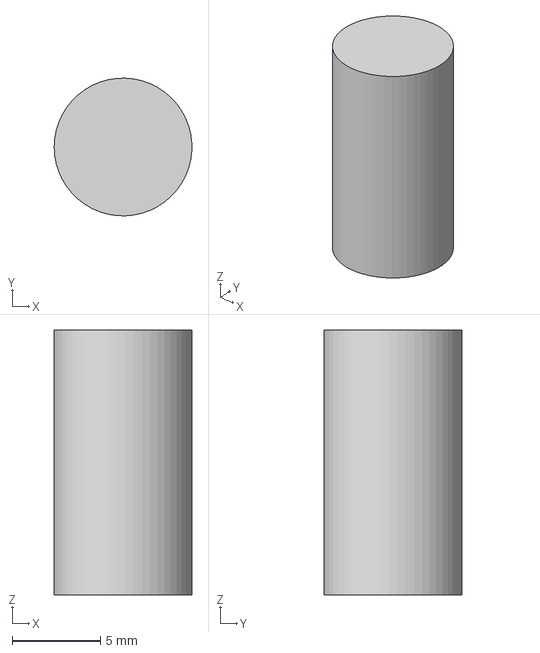
[picture p33: CAD file, 2026-11-08]
CAD/parts/step/R4-FR-02_tube_plug.step
7.79 x 7.80 x 15.0 mm
