Kidus-Tesfaye/edf-tvc-testbed/CAD/parts/step/R4-ES-09_rangefinder_mount.step

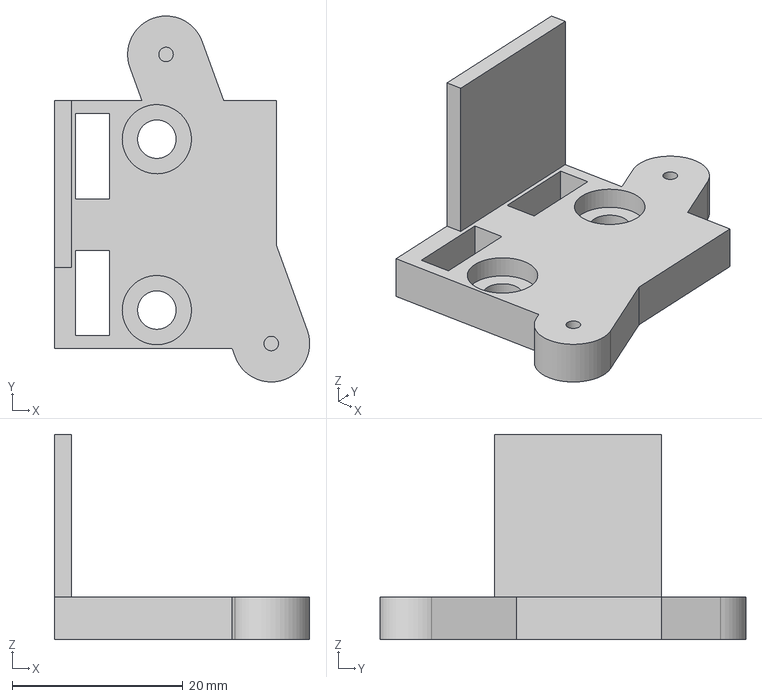
[picture p34: CAD file, 2026-11-08]
CAD/parts/step/R4-ES-09_rangefinder_mount.step
29.9 x 42.8 x 24.0 mm
