Kidus-Tesfaye/edf-tvc-testbed/CAD/parts/step/R3-ES-10_fixed_vane_strut.step

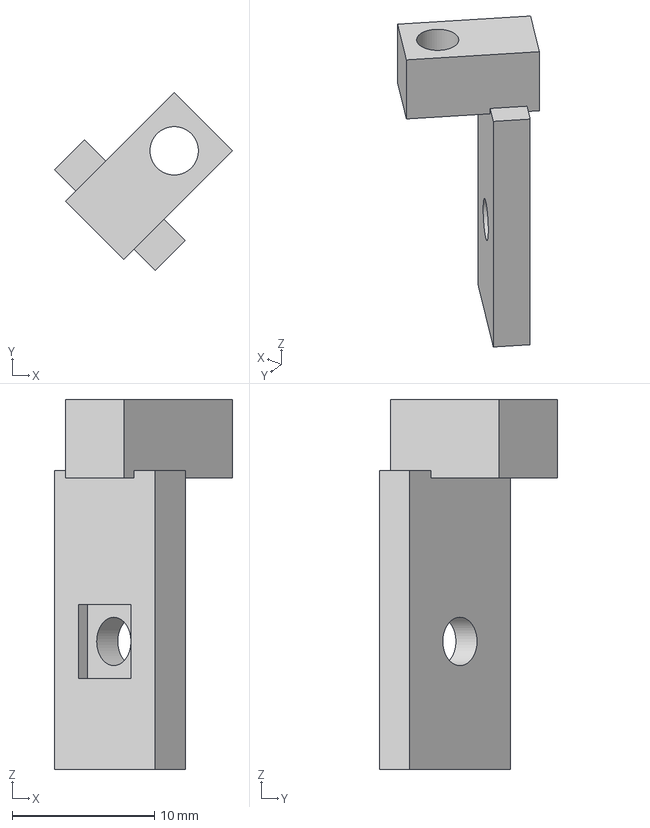
[picture p35: CAD file, 2026-11-08]
CAD/parts/step/R3-ES-10_fixed_vane_strut.step
12.5 x 12.5 x 26.0 mm
