Kidus-Tesfaye/edf-tvc-testbed/CAD/parts/step/R4-LG-02_foot.step

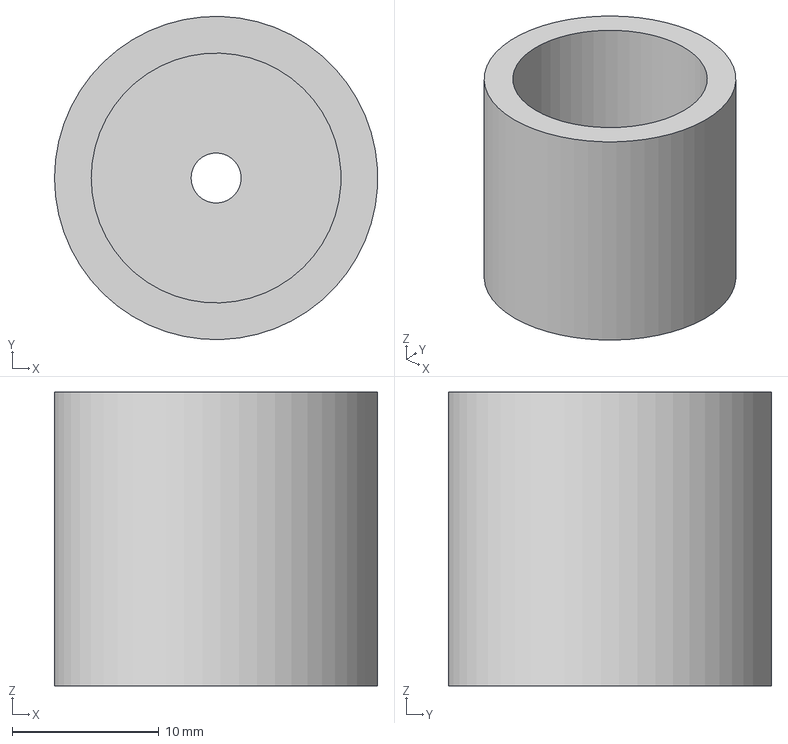
[picture p36: CAD file, 2026-11-08]
CAD/parts/step/R4-LG-02_foot.step
22.0 x 22.0 x 20.0 mm
