Kidus-Tesfaye/edf-tvc-testbed/CAD/parts/step/R4-ES-05_tab_block.step

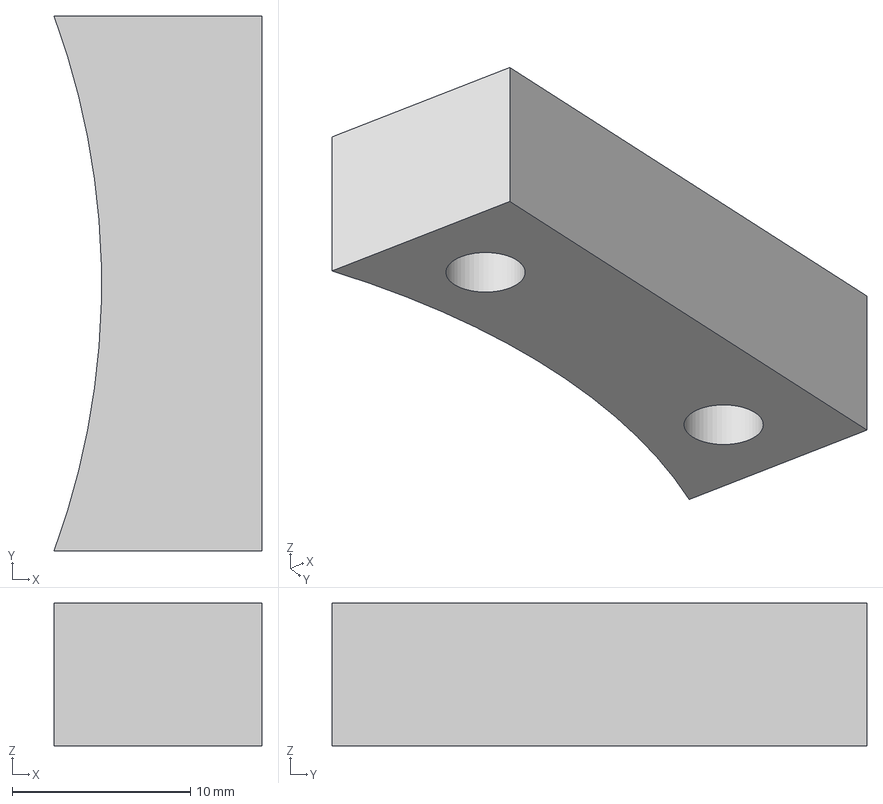
[picture p37: CAD file, 2026-11-08]
CAD/parts/step/R4-ES-05_tab_block.step
11.7 x 30.0 x 8.00 mm
