Kidus-Tesfaye/edf-tvc-testbed/CAD/parts/step/R4-LG-03_foot_disc.step

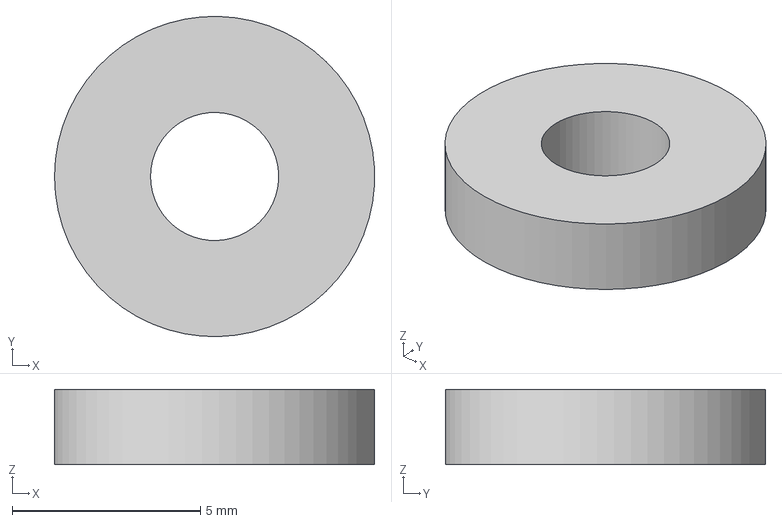
[picture p38: CAD file, 2026-11-08]
CAD/parts/step/R4-LG-03_foot_disc.step
8.49 x 8.50 x 2.00 mm
