Kidus-Tesfaye/edf-tvc-testbed/CAD/parts/step/R4-IG-01_intake_guard_quarter.step

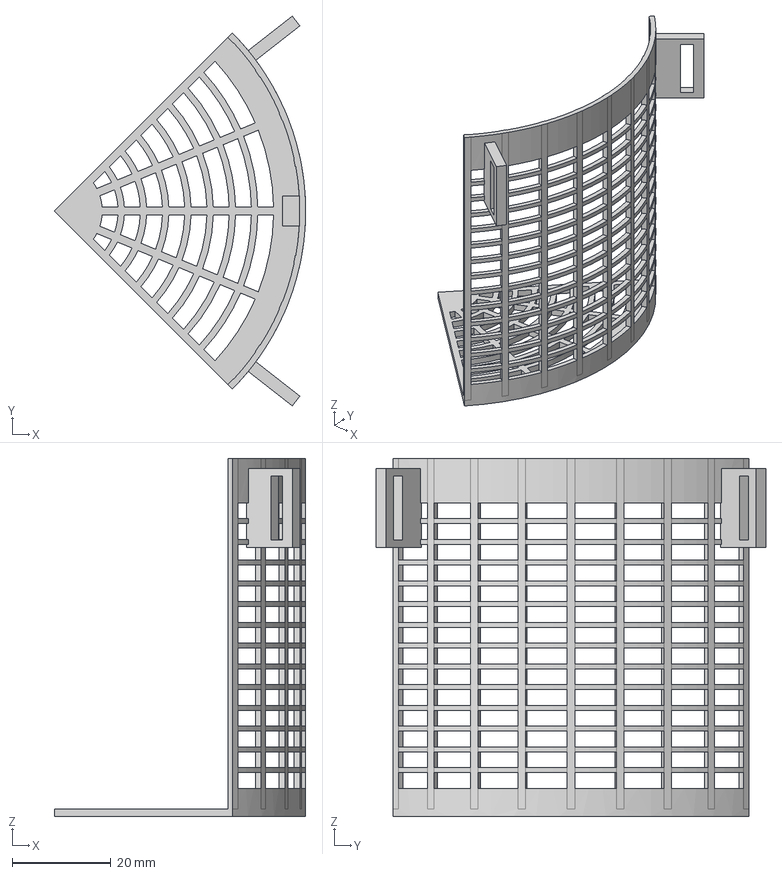
[picture p39: CAD file, 2026-11-08]
CAD/parts/step/R4-IG-01_intake_guard_quarter.step
50.9 x 78.9 x 72.5 mm
