Kidus-Tesfaye/edf-tvc-testbed/CAD/parts/step/R4-LG-01_leg.step

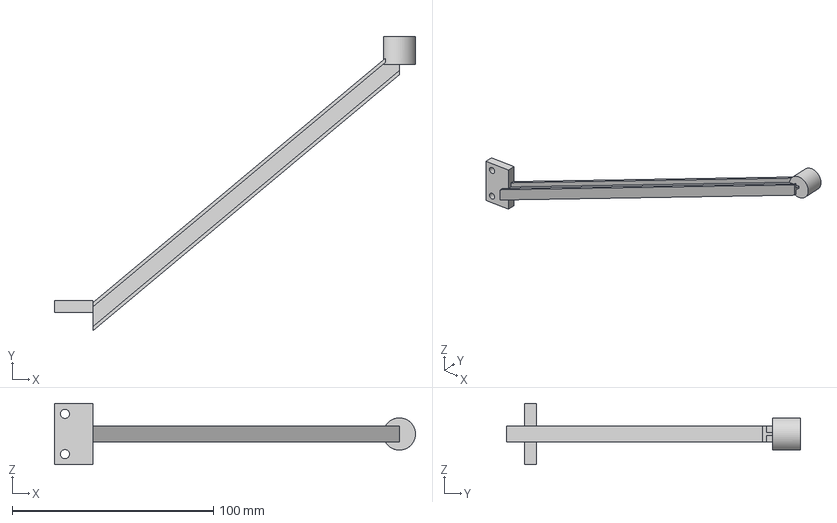
[picture p40: CAD file, 2026-11-08]
CAD/parts/step/R4-LG-01_leg.step
179.2 x 146.0 x 30.4 mm
