Kidus-Tesfaye/edf-tvc-testbed/CAD/parts/step/R4-FL-03_fc_tray.step

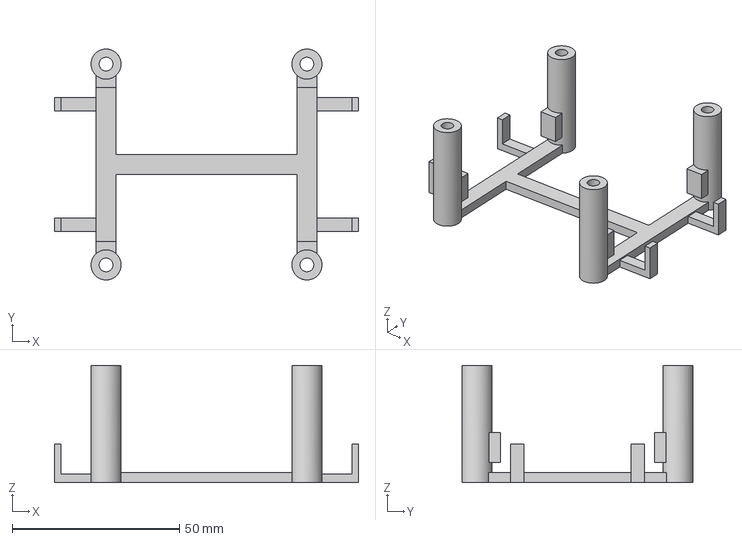
[picture p41: CAD file, 2026-11-08]
CAD/parts/step/R4-FL-03_fc_tray.step
90.8 x 69.0 x 35.0 mm
