Kidus-Tesfaye/edf-tvc-testbed/CAD/parts/step/R4-VM-01_vane.step

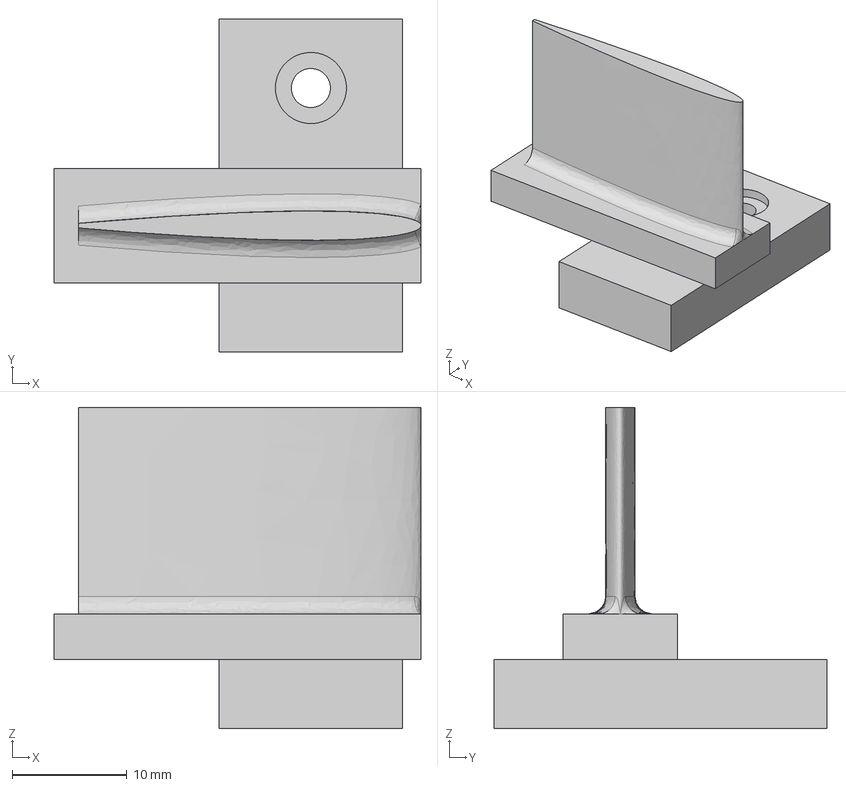
[picture p42: CAD file, 2026-11-08]
CAD/parts/step/R4-VM-01_vane.step
32.0 x 29.0 x 28.0 mm
