Kidus-Tesfaye/edf-tvc-testbed/CAD/parts/step/R4-ES-01_edf_support.step

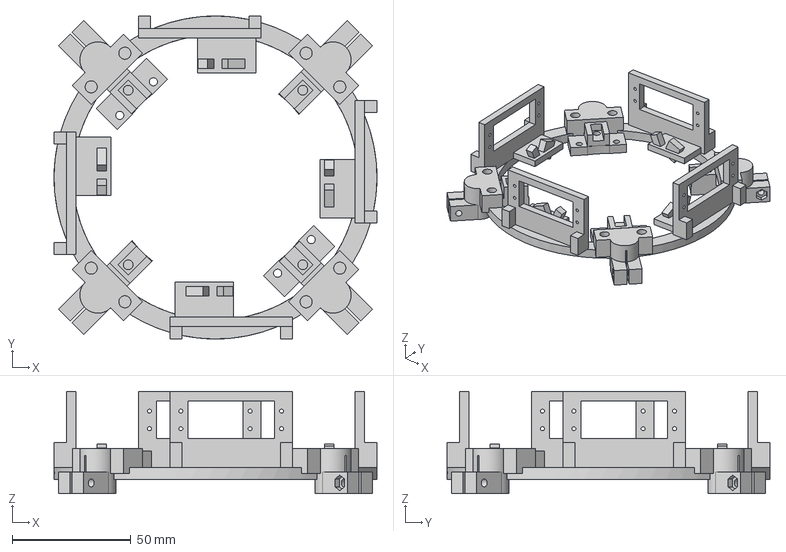
[picture p43: CAD file, 2026-11-08]
CAD/parts/step/R4-ES-01_edf_support.step
136.0 x 136.0 x 43.0 mm
