Kidus-Tesfaye/edf-tvc-testbed/(list of files, cad)

Other CAD files:
CAD/cad/R4_R4-FLIGHT.step
CAD/cad/EDF_PETG_Vehicle_R4_MIN.f3d
CAD/cad/EDF_R4_TestBed.f3d
CAD/parts/stl/R3-ES-06_fixed_vane.stl
CAD/parts/stl/R3-ES-07_fixed_vane_angle_insert_0deg.stl
CAD/parts/stl/R3-ES-10_fixed_vane_strut.stl
CAD/parts/stl/R3-FR-11T_tether_backup_stop_cap.stl
CAD/parts/stl/R3-TT-03_tether_backup_stop.stl
CAD/parts/stl/R4-ES-01_edf_support.stl
CAD/parts/stl/R4-ES-05_tab_block.stl
CAD/parts/stl/R4-ES-09_rangefinder_mount.stl
CAD/parts/stl/R4-FL-01_mid_plate.stl
CAD/parts/stl/R4-FL-02_top_plate.stl
CAD/parts/stl/R4-FL-03_fc_tray.stl
CAD/parts/stl/R4-FR-02_tube_plug.stl
CAD/parts/stl/R4-IG-01_intake_guard_quarter.stl
CAD/parts/stl/R4-LG-01_leg.stl
CAD/parts/stl/R4-LG-02_foot.stl
CAD/parts/stl/R4-LG-03_foot_disc.stl
CAD/parts/stl/R4-VM-01_vane.stl
