Kidus-Tesfaye/edf-tvc-testbed/CAD/views/19a_testbed_with_vehicle_iso.png

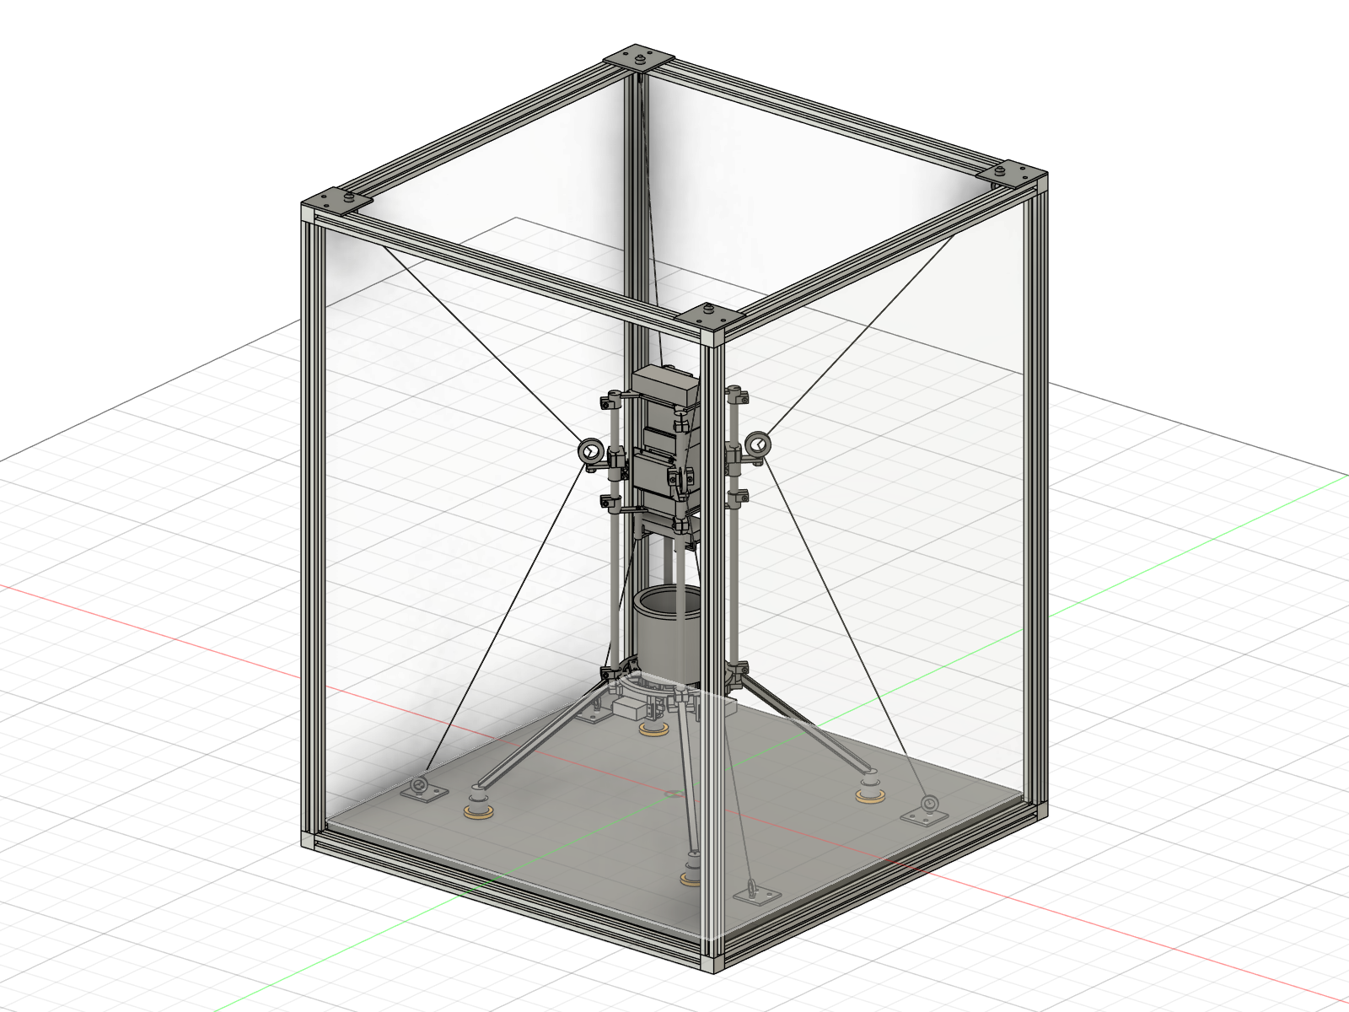
CAD/views/19a_testbed_with_vehicle_iso.png
