Kidus-Tesfaye/edf-tvc-testbed/CAD/views/19b_testbed_front_open_side_from_-Y.png

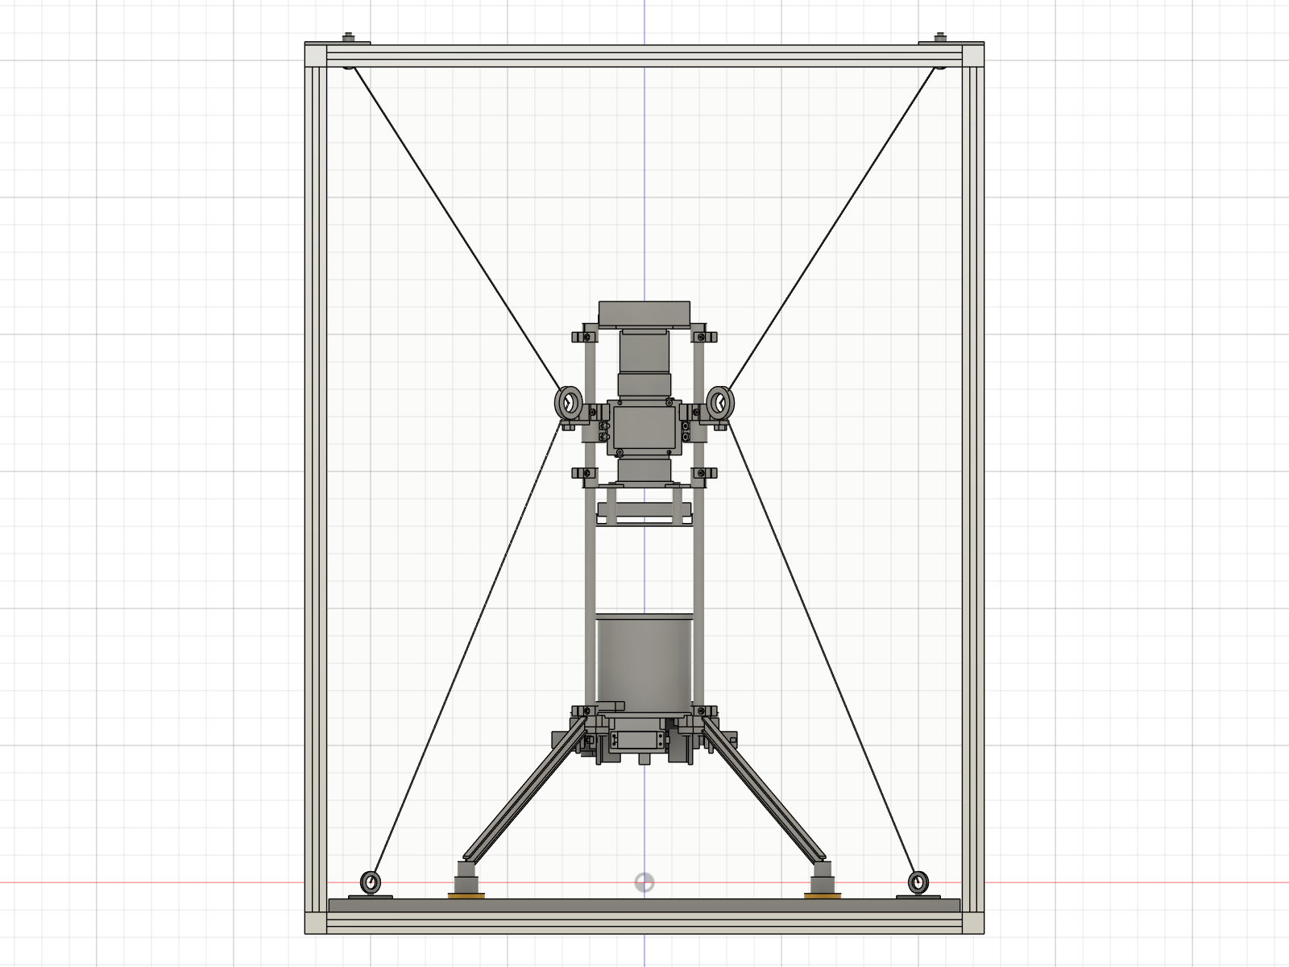
CAD/views/19b_testbed_front_open_side_from_-Y.png
