Kidus-Tesfaye/edf-tvc-testbed/CAD/views/19c_testbed_top_anchors_from_above.png

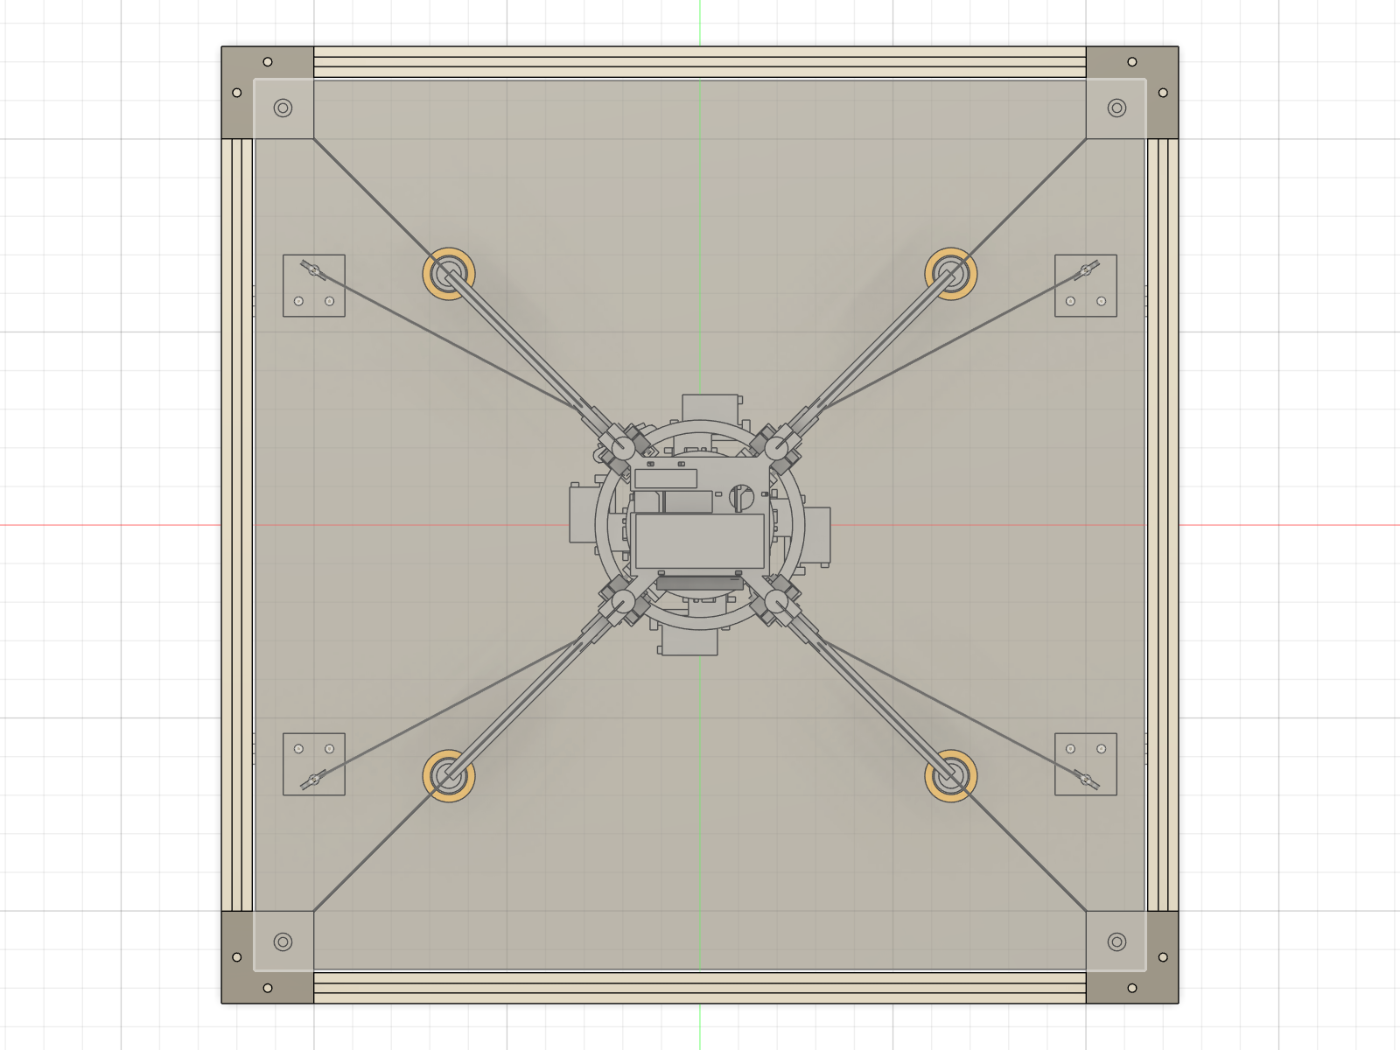
CAD/views/19c_testbed_top_anchors_from_above.png
